gilkeidar/ByteFrost/Programs/README.md

# Programs

Here is a list of included programs.

> Note: ByteFrost assembly programs have the file extension `.asm` and can be compiled to `.mlg` (this rewrites the assembly program into machine language in ASCII, useful for uploading a program to the program EEPROM using Arduino code) and `.bin` (which compiles the assembly directly to binary)

## Assembly Programs

* `BIST` - Built-In Self Test (tests hardware operations such as the ALU, RAM, register file, and display) - written by Ron Keidar
* `Binary Search Tree` - Implementation of a Binary Search Tree with recursive insert and traversal functions to sort a list of 10 numbers - written by Gil Keidar and Ron Keidar
* `Eight Queens` - Solver for the Eight Queens problem. Prints all 92 solutions - written by Gil Keidar and Ron Keidar
* `Fibonacci Recursive (Exponential)` - Recursive calculator for the nth Fibonacci number (exponential time to showcase use of stack) - written by Gil Keidar and Ron Keidar
*  `Stack_Example` - Simple stack example program that showcases use of PUSH and POP commands - written by Gil Keidar and Ron Keidar
* `memdump` - (fill program information here) - written by Ron Keidar
