gilkeidar/ByteFrost/Documentation/README.md

# ByteFrost Documentation

## Hardware Documentation

* ByteFrost PowerPoint (includes hardware schematics)

## Software Documentation

* ByteFrost Powerpoint (includes instruction set list with control signal and micro-code specifications)
