gilkeidar/ByteFrost/Assembler v2/Design/assembler handbook/overview.md

#  Overview

This handbook documents the ByteFrost Assembler software architecture (covered
in the *Developer Documentation* section) and includes a manual for how to use
the ByteFrost Assembler intended for programmers of ByteFrost Assembly (covered
in the *Programmer Manual* section).
