gilkeidar/ByteFrost/Documentation/ByteFrost v3.0.pptx

Byte Frost

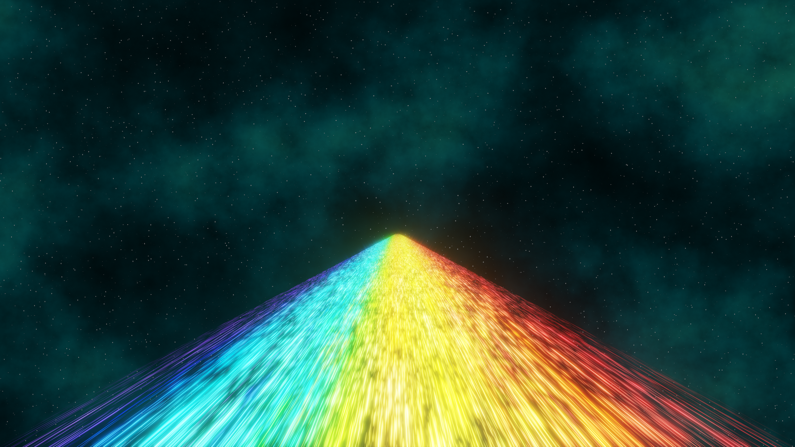
[picture p5: figure]
Bifrost [3840x2160] : r/wallpaper
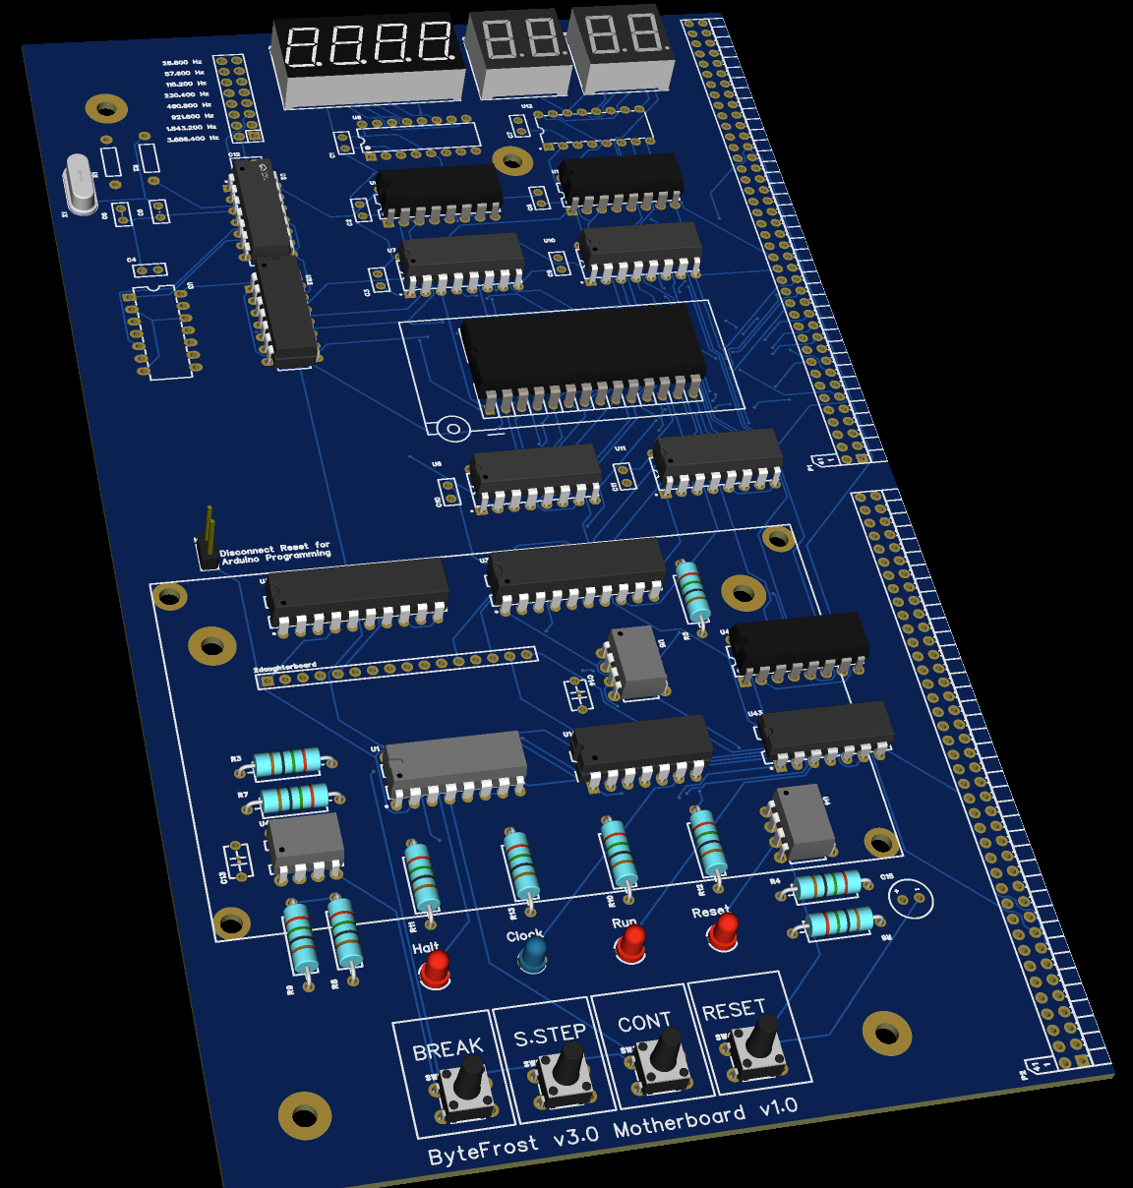
[picture p6: figure]

V3.0 PCB

## ByteFrost V3.0 – Migration to PCB

While most of the design is kept from v2.0, the migration to
Backplane and distributed PCB boards impact every circuit.
In addition, all the schematics are real, and not hand made impressions.

## Unified Bus Operation (v2.0)

8b→16b

16bitAdder

TmpAR

8 msb

Address Bus + Read/Write

8 lsb

Addr H

Addr L

Data Bus

Data Bus

TmpAR

PC

3msb

Data Bus

AMAP
Decoder

CE

Program Counter

Stack Pointer

SP

EEPROM

Data Pointer

DP

CE

SRAM

Base Pointer

AR Select

BP

CE

Read /Write

MMIO

Instruction Registers

Micro
Instructions

Register
File

## ByteFrost Addressing Modes

There are five forms of memory in the ByteFrost – Immediates (read-only), General-Purpose Registers (R0 – R3), Address Registers (DP, SP, PC, BP), Memory (64KB divided into ROM, RAM, and MMIO regions), and Stack
Every solid directed edge (u, v) in the following graph means that memory u can write to memory v with a dedicated instruction.
Every dotted directed edge (u, v) means that the memory u can write to memory v indirectly (i.e., a path exists from u to v but requires multiple instructions to implement).
There are technically 5 x 5 = 25 possible permutations here, but as immediates are read-only, there are in effect only 5 x 4 = 20 possible permutations.
Instructions with an asterisk (*) are currently not implemented.

Immediate

Memory

LDR

MOV

General Register

Address Register

Stack

Src | Dest | Semantics | Dedicated Instruction?
Imm | GR | Rd = Imm_8 (LDR Rd, Imm) | Yes (LDR)
GR | GR | Rd = Rs (MOV Rd, Rs) | Yes (MOV)
AR | GR | Rd = ARSrc[L/H] | Yes (*)
Memory | GR | (LMA) Rd = *{%DP[H], Imm}, DP[L] = Imm (LMR) Rd = *{%DP[H], Rs}, DP[L] = Rs (LMO*) Rd = *(ARSrc + Imm) | Yes (LMA, LMR, *
Stack | GR | Rd = *(SP), SP++ | Yes (POP)

Src | Dest | Semantics | Dedicated Instruction?
Imm | AR | ARDest[L/H] = Imm | Yes (*)
GR | AR | ARDest[L/H] = Rs | Yes (*)
AR | AR | ARDest = ARSrc + Imm | Yes (*)
Memory | AR | ARDest[L/H] = *(ARSrc + Imm) (?) ARDest = *{ARSrc + Imm + 1, ARSrc + Imm} (?) | No
Stack | AR | ARDest = *{SP + 1, SP}, SP += 2 (?) (e.g. POP ARDest) | No

Src | Dest | Semantics | Dedicated Instruction?
Imm | Memory | *(ARSrc) = Imm (?) | No
GR | Memory | *(ARSrc + Imm) = Rs | Yes (*)
AR | Memory | *(ARDest + Imm + 1, ARDest + Imm) = ARSrc(?) | No
Memory | Memory | *(ARDest + Imm) = *(ARSrc) | No (load-store architecture)
Stack | Memory | *(ARSrc + Imm) = *SP, SP++ (?) | No

Src | Dest | Semantics | Dedicated Instruction?
Imm | Stack | *(SP) = Imm, SP– (Push Imm) | No?
GR | Stack | *(SP) = Rs, SP-- | Yes (PUSH *) (change to full-descending)
AR | Stack | *(SP, SP – 1) = ARSrc, SP -= 2 | No? (Push ARSrc)
Memory | Stack | ? | ?
Stack | Stack | ? | ?

## Backplane

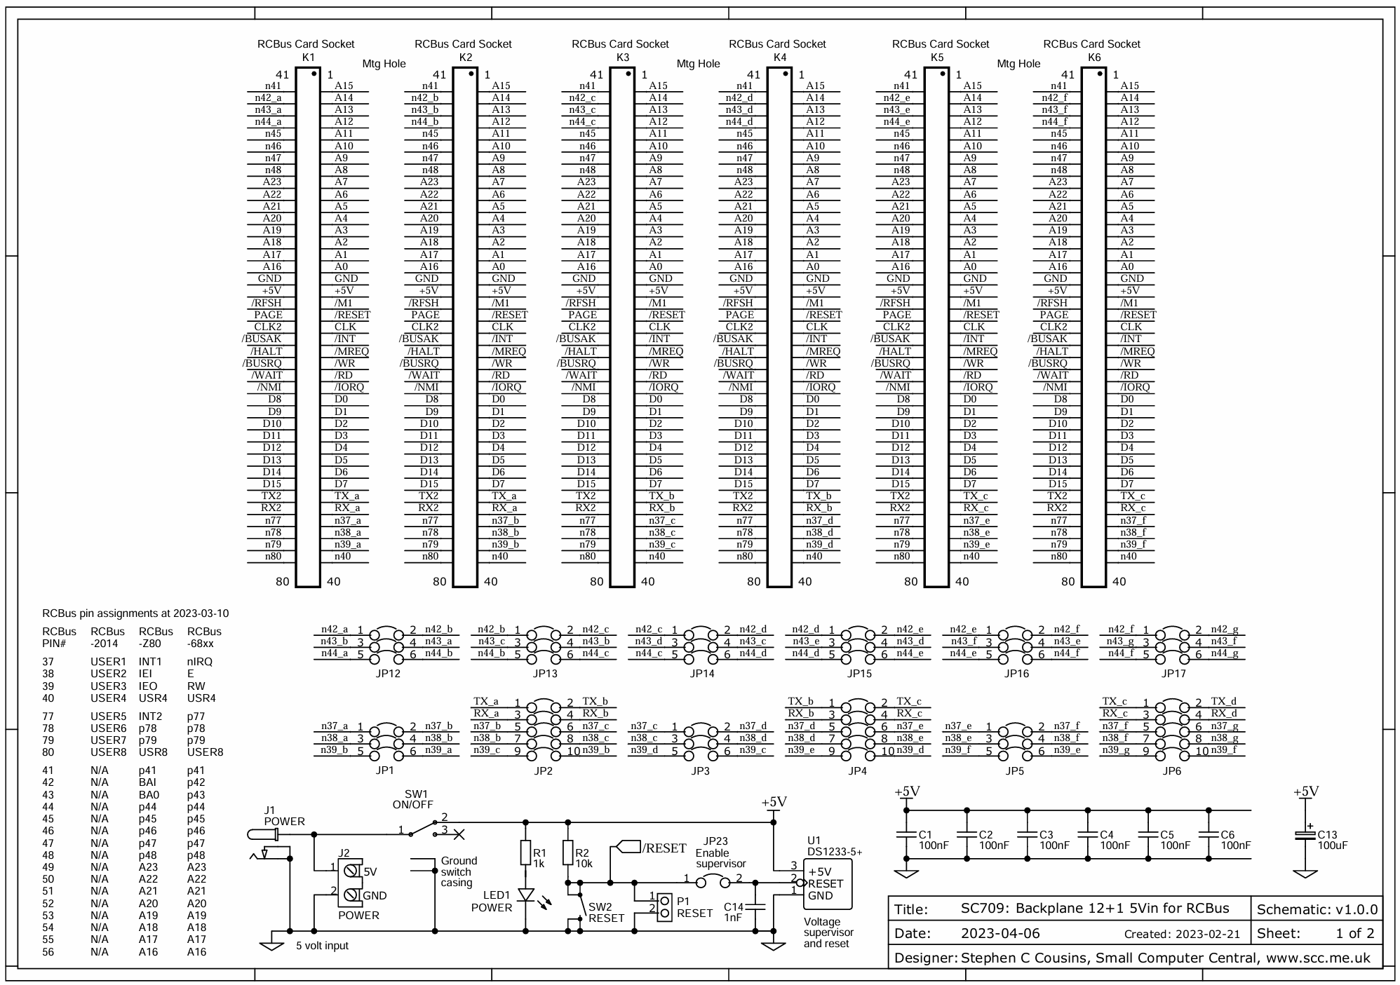
[picture p7: figure]

sc709_v1.0.0_2023-04-17_22-11_schematic.pdf (https://smallcomputercentral.com/wp-content/uploads/2023/04/sc709_v1.0.0_2023-04-17_22-11_schematic.pdf)
EasyEDA (https://easyeda.com/editor#id=67eacdcff3ef4f0daaa2c420b6aae15d)(Standard) - A Simple and Powerful Electronic Circuit Design Tool (https://easyeda.com/editor#id=67eacdcff3ef4f0daaa2c420b6aae15d)

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
## Main Backplane

__41 | 41 | 1 | A15
__42 | 42 | 2 | A14
__43 | 43 | 3 | A13
__44 | 44 | 4 | A12
__45 | 45 | 5 | A11
__46 | 46 | 6 | A10
D0 | 47 | 7 | A9
D1 | 48 | 8 | A8
D2 | 49 | 9 | A7
D3 | 50 | 10 | A6
D4 | 51 | 11 | A5
D5 | 52 | 12 | A4
D6 | 53 | 13 | A3
D7 | 54 | 14 | A2
CTRL23 | 55 | 15 | A1
CTRL22 | 56 | 16 | A0
GND | 57 | 17 | GND
+5V | 58 | 18 | +5V
CTRL21 | 59 | 19 | __19
CTRL20 | 60 | 20 | Reset#
CTRL19 | 61 | 21 | CLK
CTRL18 | 62 | 22 | WR#
CTRL17 | 63 | 23 | RD# (OE#)
CTRL16 | 64 | 24 | INSTR0
CTRL15 | 65 | 25 | INSTR1
CTRL14 | 66 | 26 | INSTR2
CTRL13 | 67 | 27 | INSTR3
CTRL12 | 68 | 28 | INSTR4
CTRL11 | 69 | 29 | INSTR5
CTRL10 | 70 | 30 | INSTR6
CTRL9 | 71 | 31 | INSTR7
CTRL8 | 72 | 32 | INSTR8
CTRL7 | 73 | 33 | INSTR9
CTRL6 | 74 | 34 | INSTR10
CTRL5 | 75 | 35 | INSTR11
CTRL4 | 76 | 36 | INSTR12
CTRL3 | 77 | 37 | INSTR13
CTRL2 | 78 | 38 | INSTR14
CTRL1 | 79 | 39 | INSTR15
CTRL0 | 80 | 40 | __40

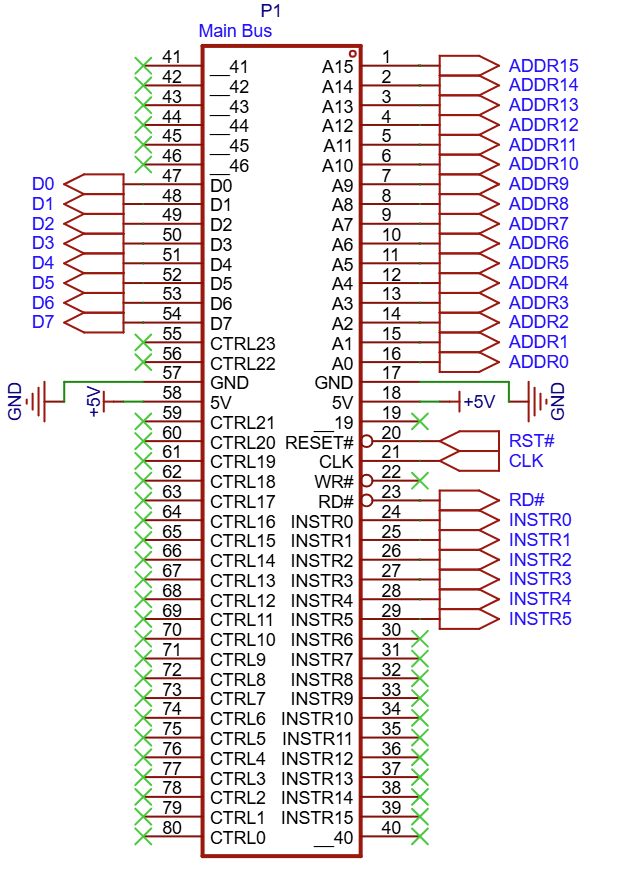
[picture p8: figure]

- Orange pins have jumpers that can make them local
- Pin with prefix __ are not assigned

## Secondary Backplane

__41 | 41 | 1 | Bus_Request
__42 | 42 | 2 | Bus_Grant
__43 | 43 | 3 | Bus_Release
__44 | 44 | 4 | Quiesce
__45 | 45 | 5
__46 | 46 | 6 | Fetch_Cycle
| 47 | 7
| 48 | 8 | Display_Load
| 49 | 9 | KBD_CLK
| 50 | 10 | KBD_Data
| 51 | 11
| 52 | 12
| 53 | 13
| 54 | 14
| 55 | 15
| 56 | 16
GND | 57 | 17 | GND
+5V | 58 | 18 | +5V
| 59 | 19 | BPL_LD
| 60 | 20 | BPH_LD
| 61 | 21 | SPL_LD
| 62 | 22 | SPH_LD
| 63 | 23 | DPL_LD
| 64 | 24 | DPH_LD
| 65 | 25 | PC_LD#
| 66 | 26 | DHPC_LD
| 67 | 27 | TmpAR_OE#
| 68 | 28 | BP_OE#
| 69 | 29 | SP_OE#
| 70 | 30 | DP_OE#
| 71 | 31 | PC_OE#
| 72 | 32 | __32
LD_BRNCH | 73 | 33 | __33
FLAG_N | 74 | 34 | __34
FLAG_C | 75 | 35 | __35
FLAG_Z | 76 | 36 | __36
RST_MicroPC | 77 | 37 | __37
MSB_Quiesce | 78 | 38 | __38
ARSrc_0 | 79 | 39 | __39
ARSrc_1 | 80 | 40 | __40

- Orange pins have jumpers that can make them local
- Pin with prefix __ are not assigned

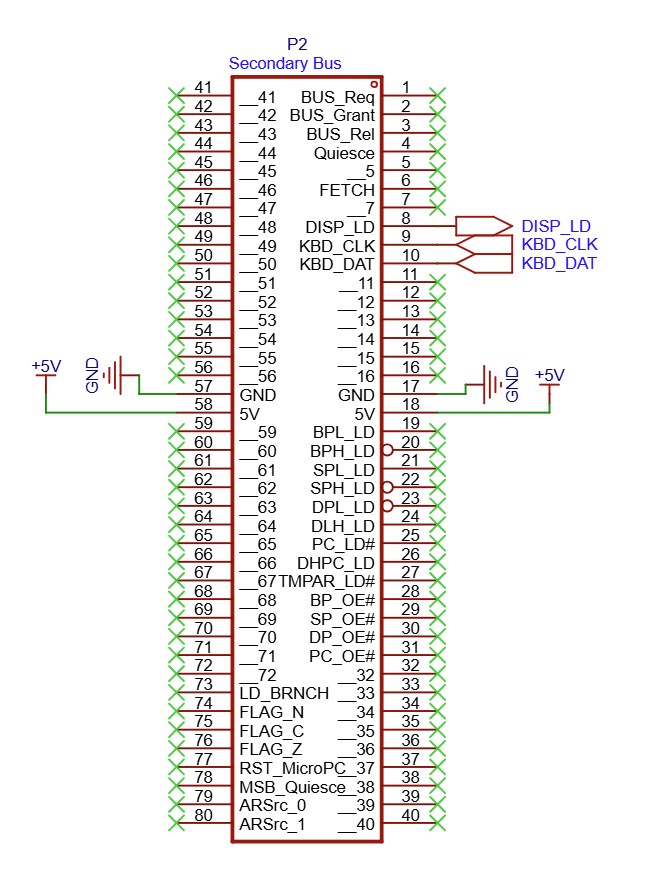
[picture p9: figure]

## Area Estimation – Chips * Length

23. Arduino+ Display
24. ALU

12. OpCode
13. Regs

15. Branch | 14. Display

16. SD MKR
17. SD I/F
18. BP
19. AddrDisp
20. TmpAR

1. clock
2. CTRL LEDs
3. MicroInst
4. OE/WE
5. ROM
6. DP
7. SRAM
8. PC
9 Addr
10. Counter
11. RNG

21. KBD
22. SP

## Motherboard (v3.0)

- The 4 buttons and LEDs at the bottom preserve the original ByteFrost design
- The clock is replaced with a crystal.
- The clock control is through the jumpers next to the crystal
- The 7SEG displays are scanned, such that one decoder serves 4 digits.
- The Display is planned to stand on 45mm columns
- 16b rainbow need to connect the display to the motherboard
- The empty space is to allow easy access to the EEPROM release bar
- The Primary and Secondary busses provides 160 lines to the rest of the system

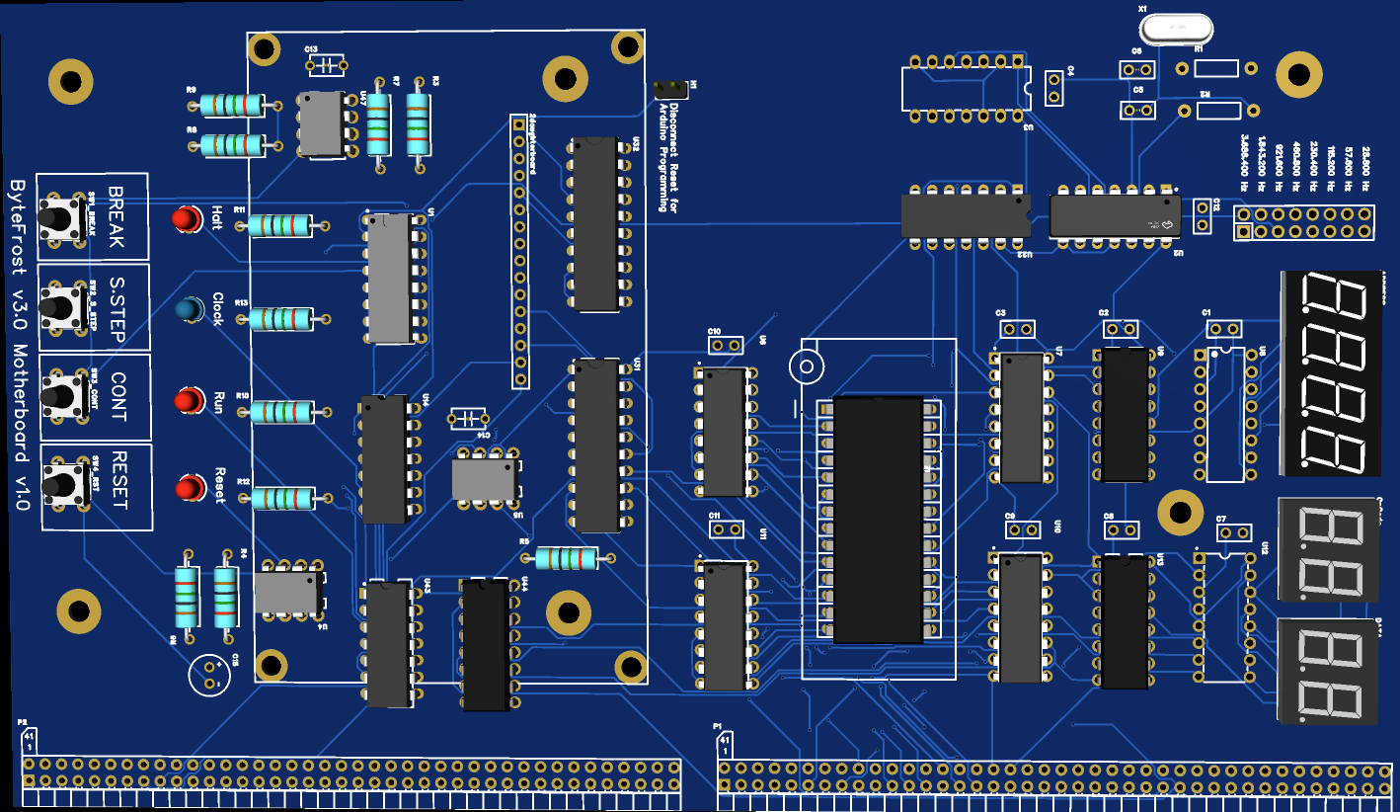
[picture p10: figure]

## Motherboard Clock (v3.0)

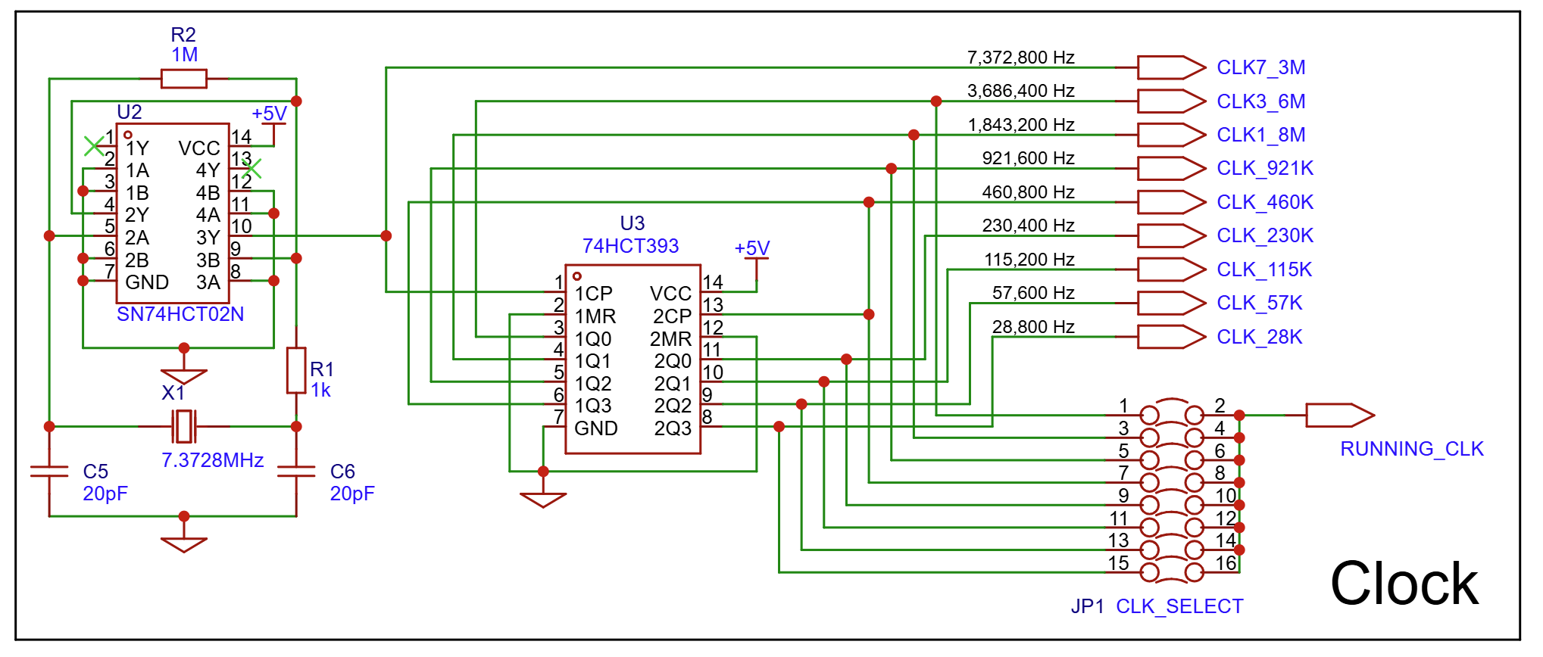
[picture p11: figure]

## Motherboard Address Display (v3.0)

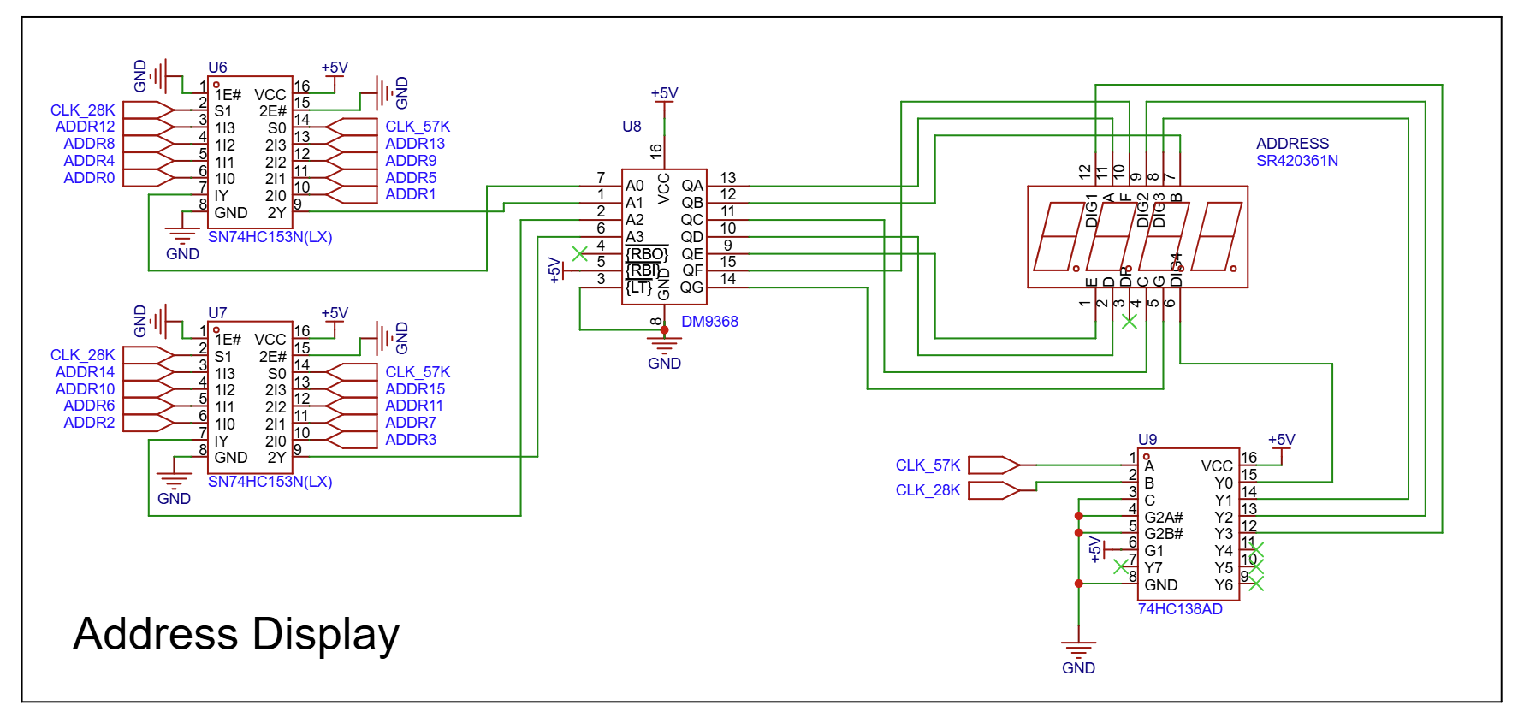
[picture p12: figure]

## Motherboard Data and Opcode Display (v3.0)

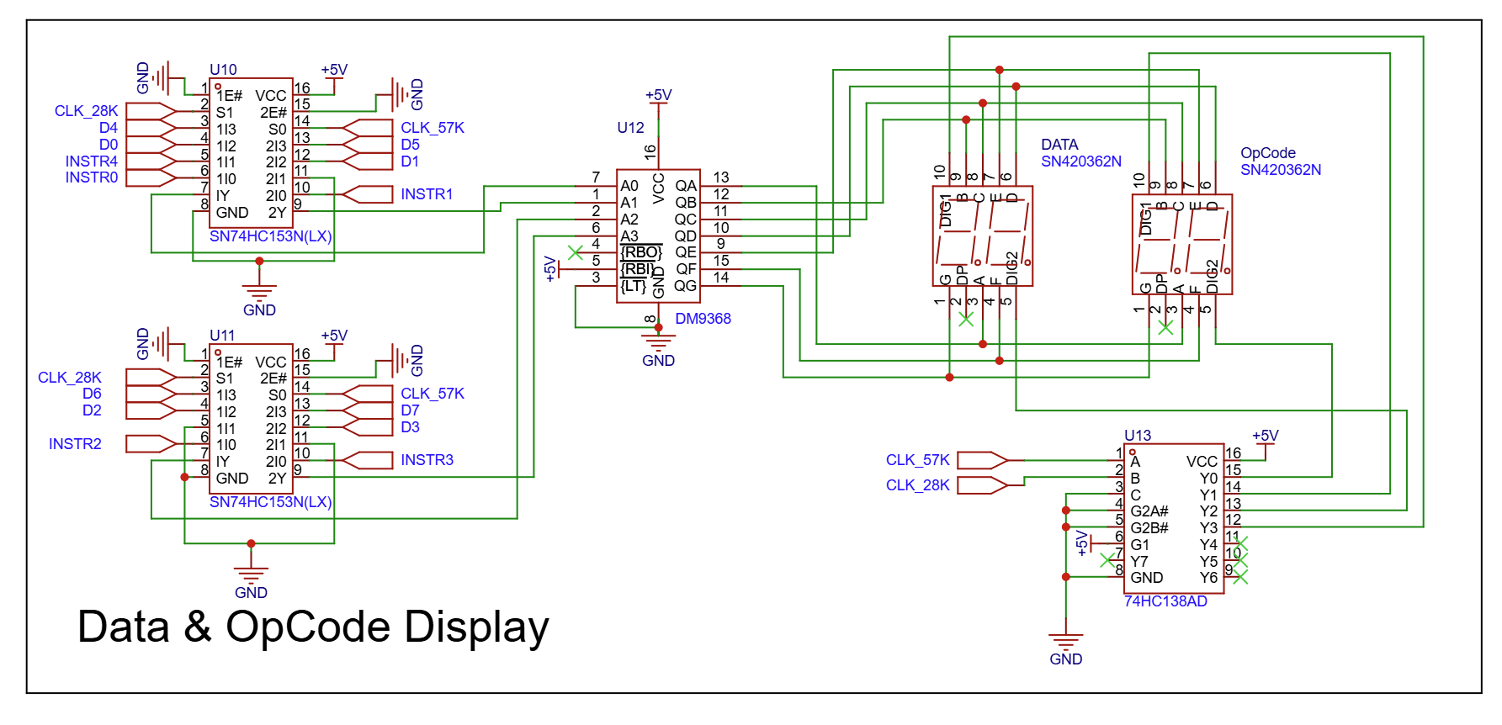
[picture p13: figure]

## Motherboard EEPROM (v3.0)

- In v3.0, the Chip_Enable signals are distributed, i.e, each storage need to generate its own CE based on the address bus.
- In this case the three MSBs are OR-ed to generate CE# for the lower 8KB

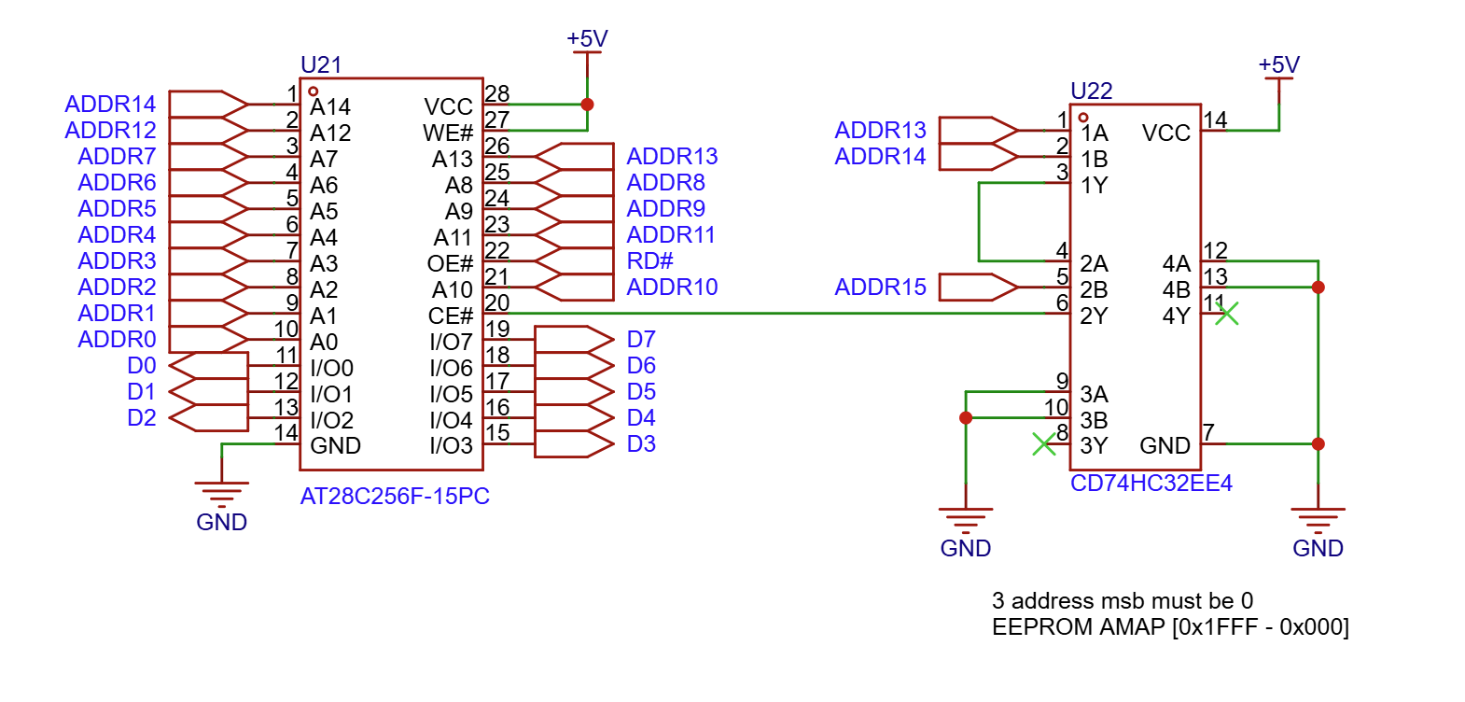
[picture p14: figure]

## Motherboard Arduino Interface (v3.0)

- DISP_LD – trigger printing a CHAR on the display
- First 273 capture the CHAR and second captures the A/I
- LDISP_LD also goes to the Arduino to trigger interrupt
- The Keyboard CHAR is serialized from Arduino and processed elsewhere through the secondary backplane.
- The reset line to Arduino need to be disconnected to enable programming through the USB

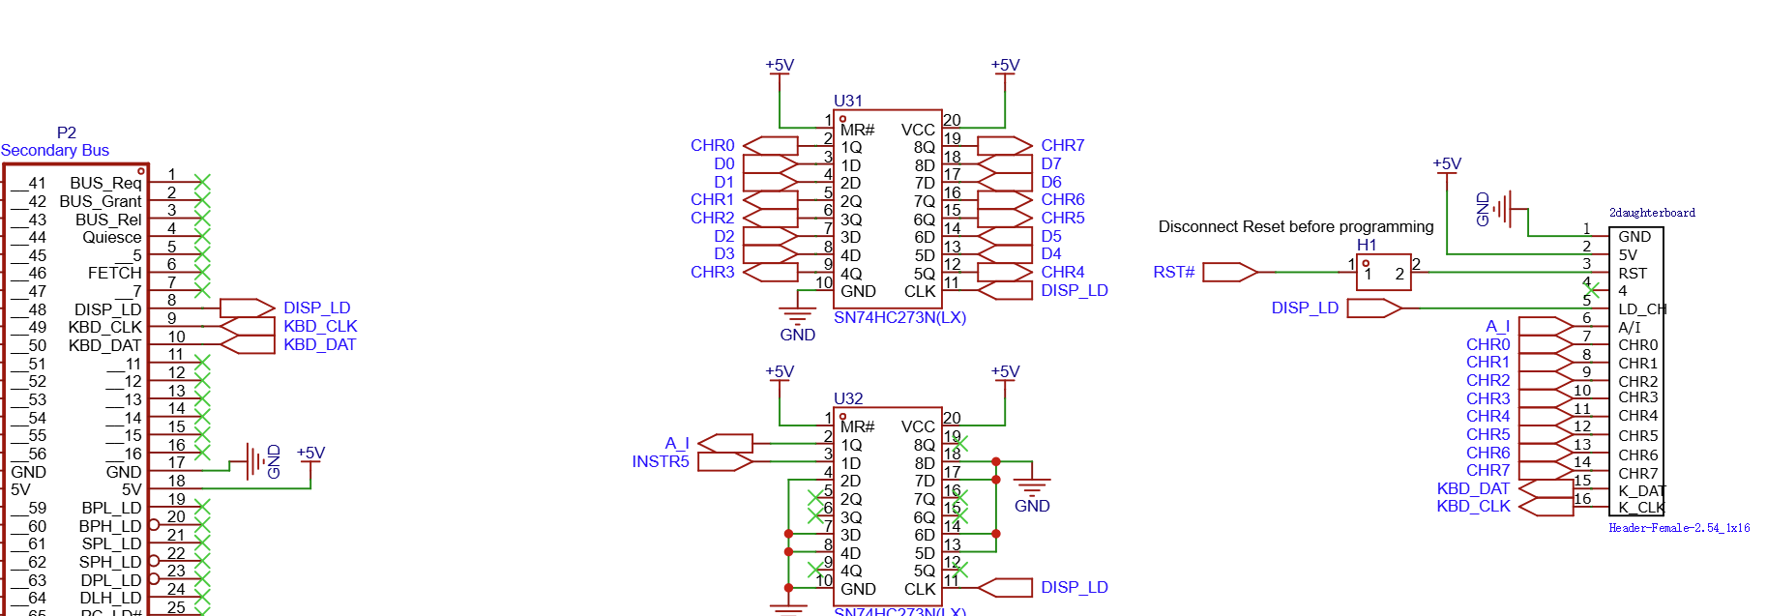
[picture p15: figure]

## Display Load (V2.0)

Data Bus

273 Char

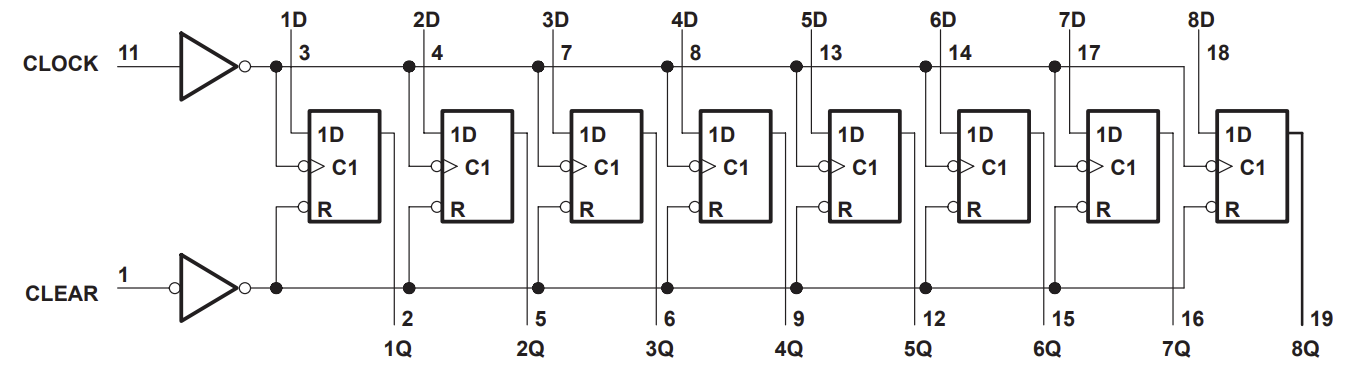
[picture p16: figure]

Disp Char

µC 6: Out Reg H

µC 3: Reg Out Select

OpCode [5] A/I

OpCode_08

Main CLK

Display Load

273 A/I

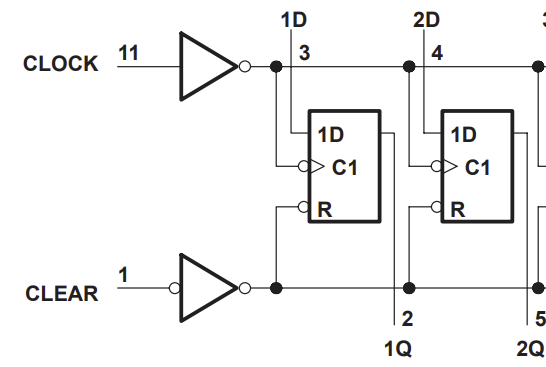
[picture p17: figure]

A/I

OpCode_0D

15

## Debug & Reset (v3.0)

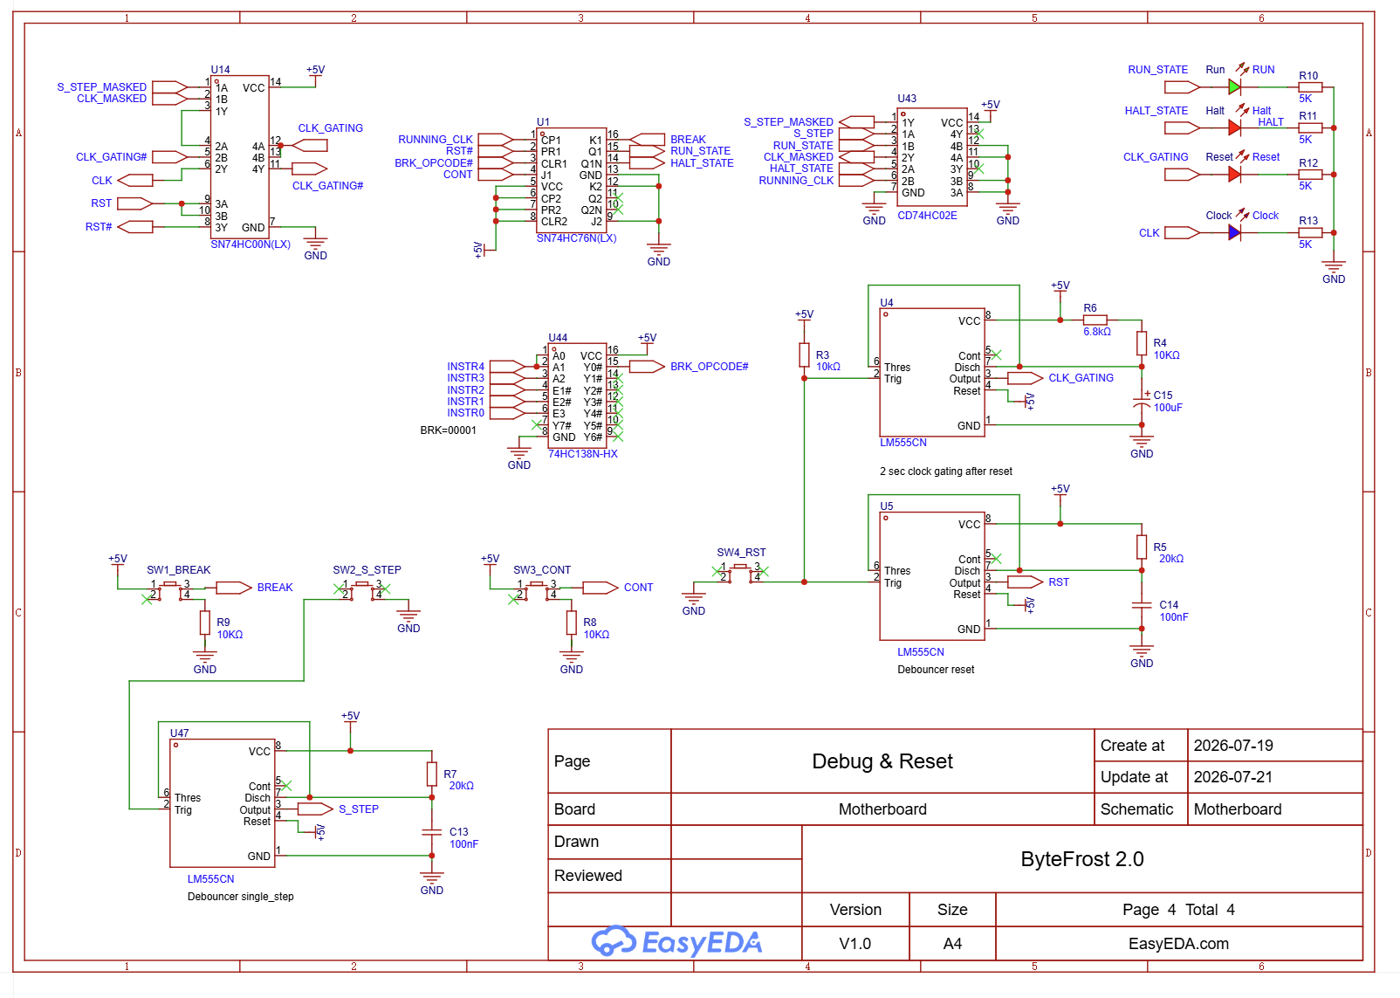
[picture p18: figure]

- The LM555 one-shots are used as debouncers, i.e. unify the many fast transitions a button may create.
- E.g. a “Single Step” button may advance multiple addresses unless a debouncer will unify the transitions into a single press.
- The CLK_GATING is a special timer that extend RST to almost 2sec. This allows the Arduino handling the display sufficient time. Otherwise, the first characters that printed in that time will be lost.
- 74HC76 is the running-state FF which determines if the system is:
  - RUN_STATE: RUNNING_CLK becomes CLK
  - HALT_STATE: No clock, or S_STEP is the CLK
- The BREAK and CONT do not need debouncers as they reset or set running-state
- 74HC02 is an OR
- The State wires are ORed with the clock they mask. (The output of the OR is ‘1’ instead of clock)
- 74HC00 is a NAND
- The two masked clocks are combined with a NAND (the masked clock is 1, enabling the other to go through the NAND)
- Another NAND is gated to allow the 2sec for the Display
- Next slide from v2.0 might help to visualize this

## Clock Gating (v2.0)

Reset#

BRK Button
(Purple)

Running CLK

Cont. Button
(Gray)

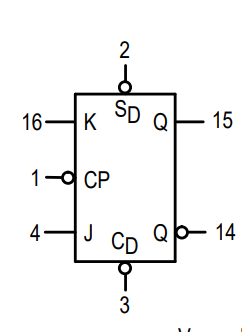
[picture p19: figure]

74LS76

S.S. CLK

RUN LED
(Brown wire)

Halt LED
(Blue wire)

Clock LED
(Green wire)

Main CLK

Clock gating 2sec for
Arduino (display) to boot

Op Code 1: BRK

Running CLK

Reset Button
(Red wire)

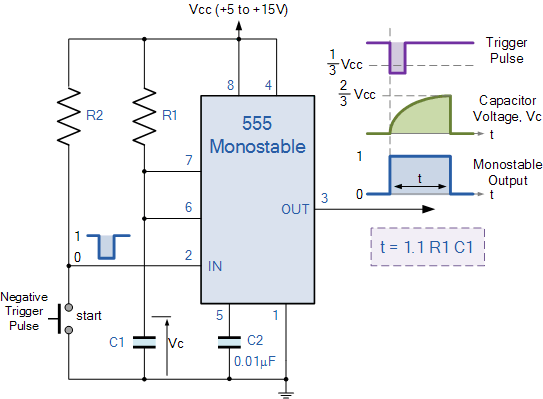
[picture p20: figure]
555 Timer Tutorial - The Monostable Multivibrator

Reset LED
(Orange wire)

Reset

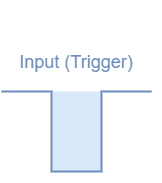
[picture p21: figure]
OPAMP Monostable - Electronics-Lab.com
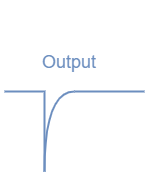
[picture p22: figure]

4ms

Main Reset

2s

17

## Display Daughterboard (v3.0)

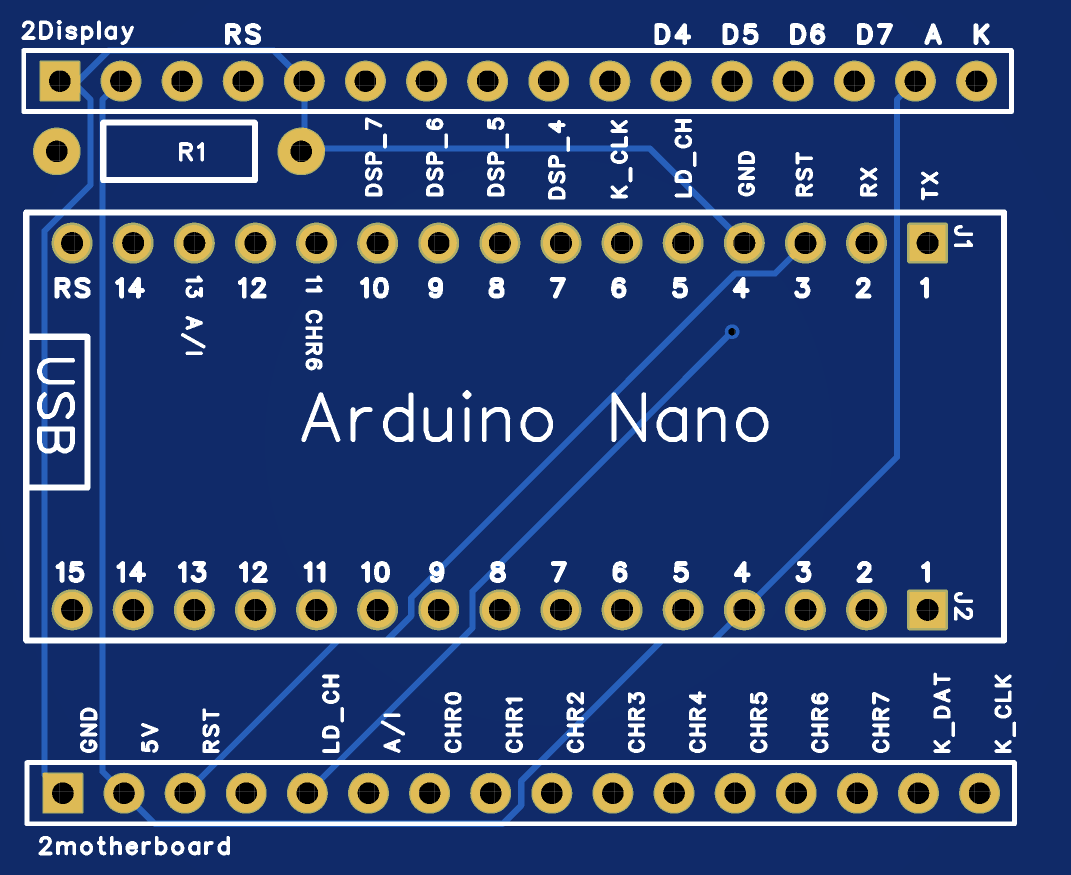
[picture p23: figure]

- The Display daughterboard is a mapper between the ByteFrost, the Arduino and the Display
- The wire to the motherboard is a 16-wire rainbow to the Motherboard
- J1/J2 are the socket for the Arduino
- The socket to the display is directly mapped to the display and physically holds the daughterboard in the air underneath the display.
- The Arduino is positioned such that the USB socket is as close as possible to the left edge of the Display, on the far end from the backplane of the Motherboard

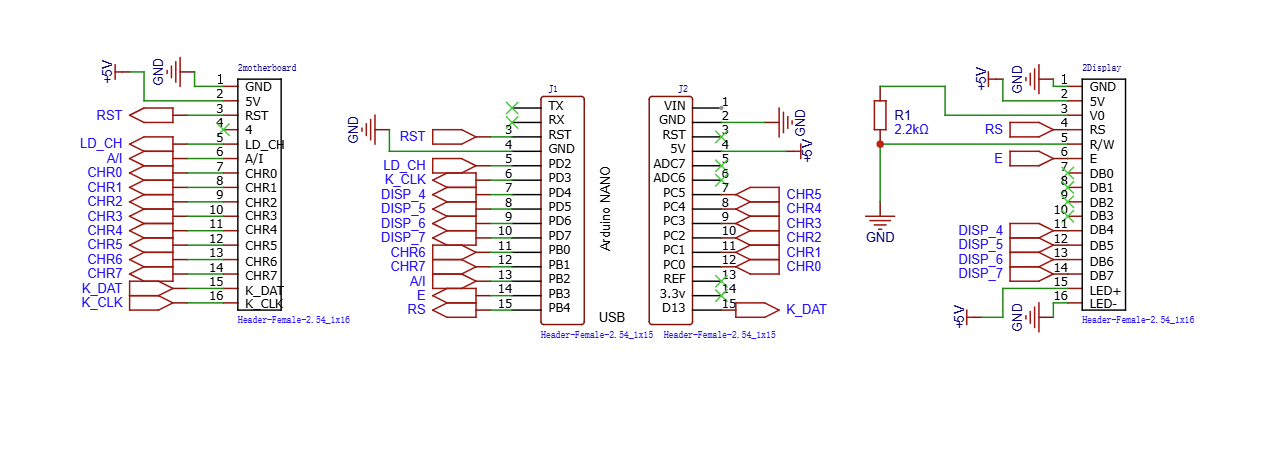
[picture p24: figure]

## Display (V2.0)

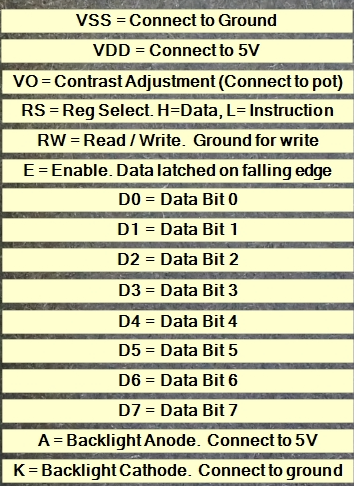
[picture p25: figure]

USB Serial.Print

Disp Char

5 4 3 2 1 0

6 7

# Main Reset

Gray

White

5V

KBD

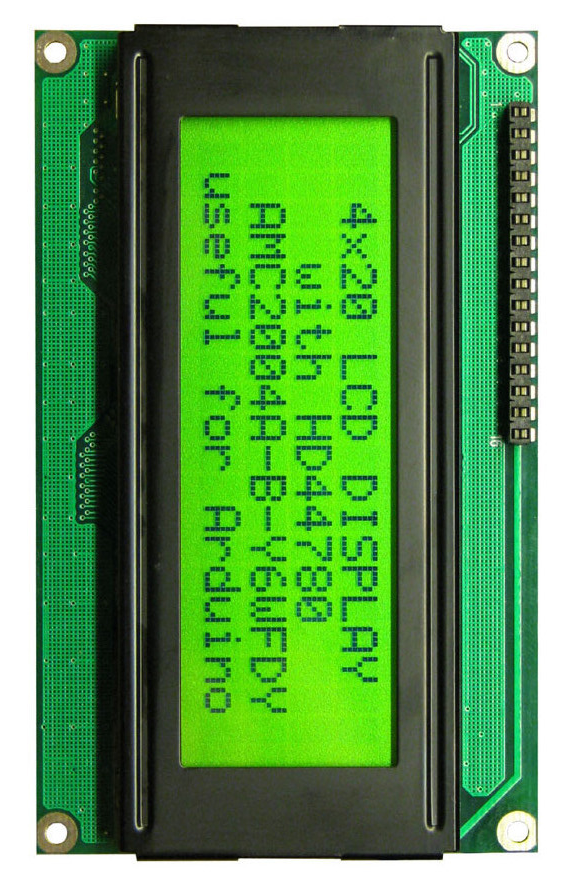
[picture p26: figure]

KBD data

KBD clock

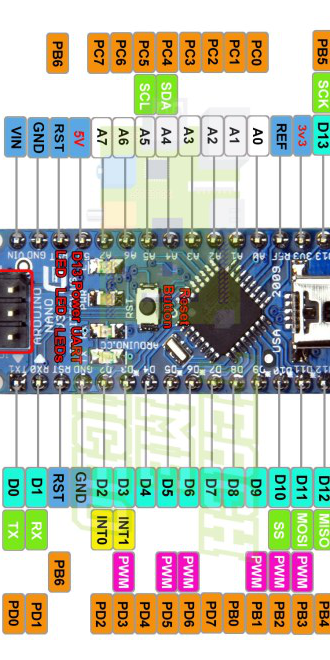
[picture p27: figure]
Arduino NANO Pinout

INT0

A/I

Notes:
1. To free up 4 GPIOs, Display is configured to use 4b which requires two writes
2. 5v was added to allow independence of USB connection. When USB is connected, it helps the main supply
3. To enable programing, the reset line need to be disconnected – proposed to add a 3state on its path
4. “A/I” is now latched and stay valid for multiple clocks and does not fail at MAX clock
5. IDE Setup: Board "Arduino NANO“; CPU "ATmega328p (old bootloader)"

Display Load

19

Notes: 1. IDE Setup
a. Board "Arduino NANO"
b. CPU "ATmega328p (old bootloader)"
2. To program the Arduino - the RESET control signal (black) need to be disconnected!!.

## Keyboard

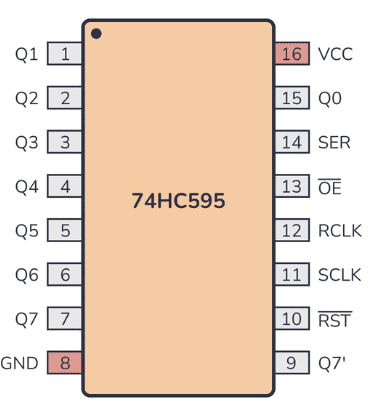
[picture p28: figure]

KBD #OE

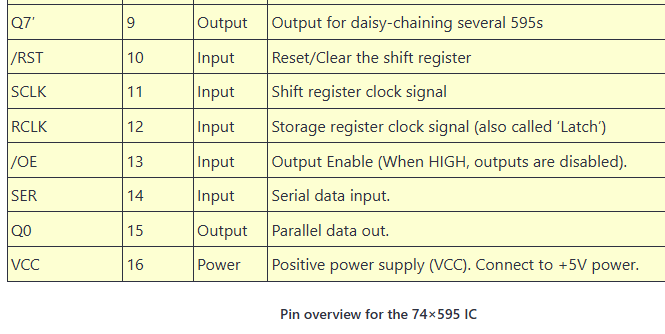
[picture p29: figure]

12

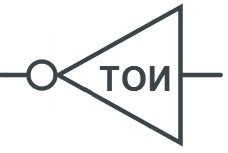
[picture p30: figure]

13

11

12

13

#Ready

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
Notes:
1. The format of the character is 1 READY bit followed by 8b char
2. Once the READY bit reaches the 9th spot (RDY Q0) the Char is ready
3. Once Ready, the Read to KBD generate #OE and the Char is out
4. If there is no Char, the #OE does not happen, and the CPU read 0
5. CPU ignores 0 as it is not an ASCII
6. The #OE also generates a reset that empty the SR but not the register
7. The end of the #OE generates a Reg clk (RCL), to load 0 to the register
8. The clock of the SR is inversed as clock to the Register (RCL) (if not inverted, the register get the previous SR)
9. The RCL combines both clock and #OE through OR 123
10. It is important that the clock from the display is 0 when not active so it wont block the OR.

Data Bus

Data - Gray

Clock - White

KBD

KBD

## Registers File

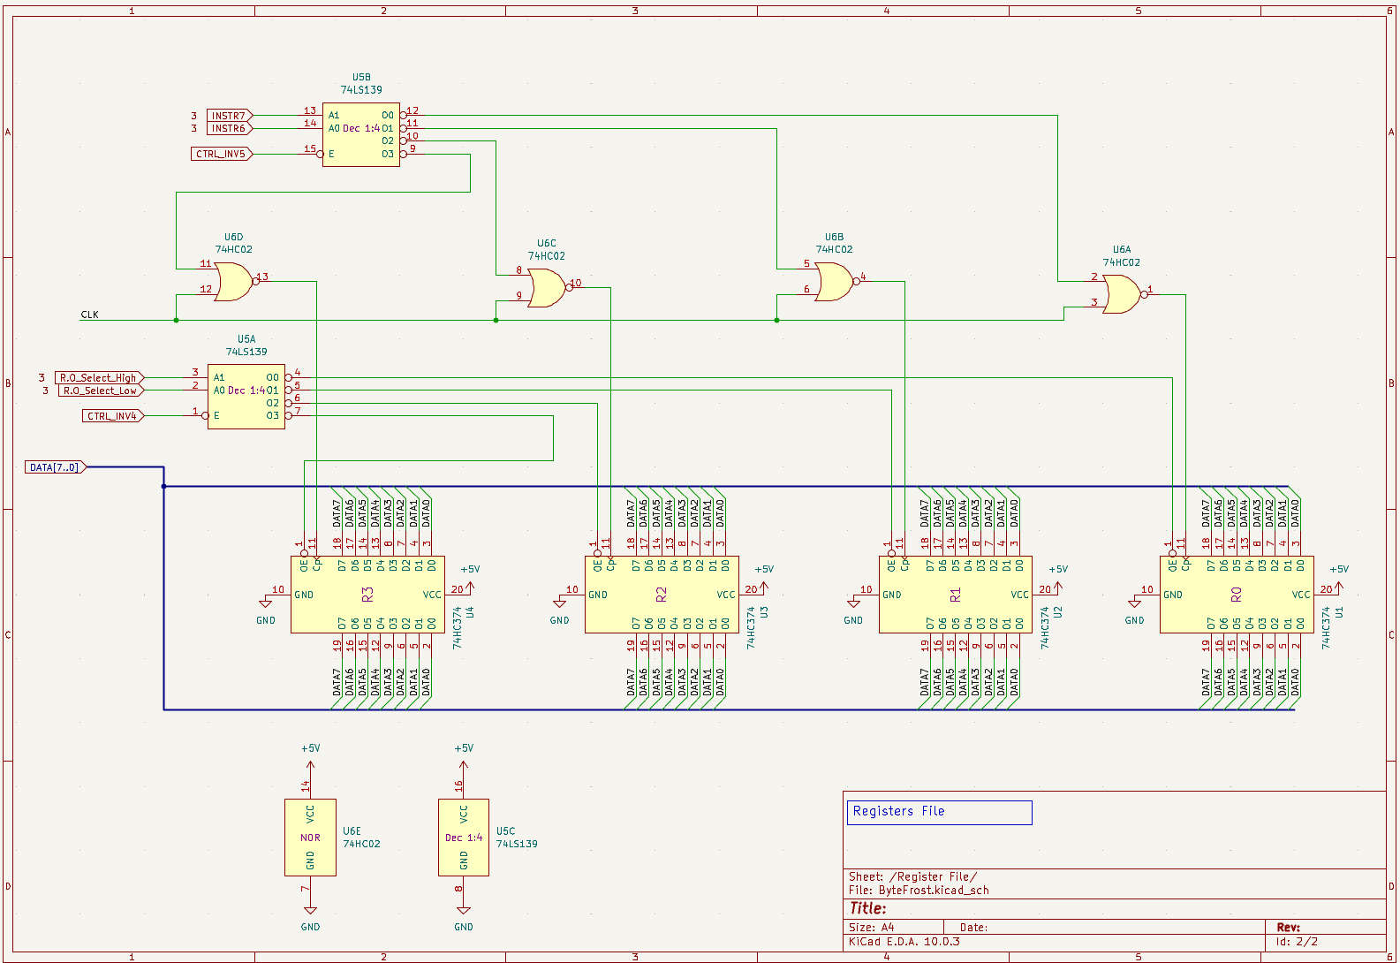
[picture p31: figure]

## Register Out Select

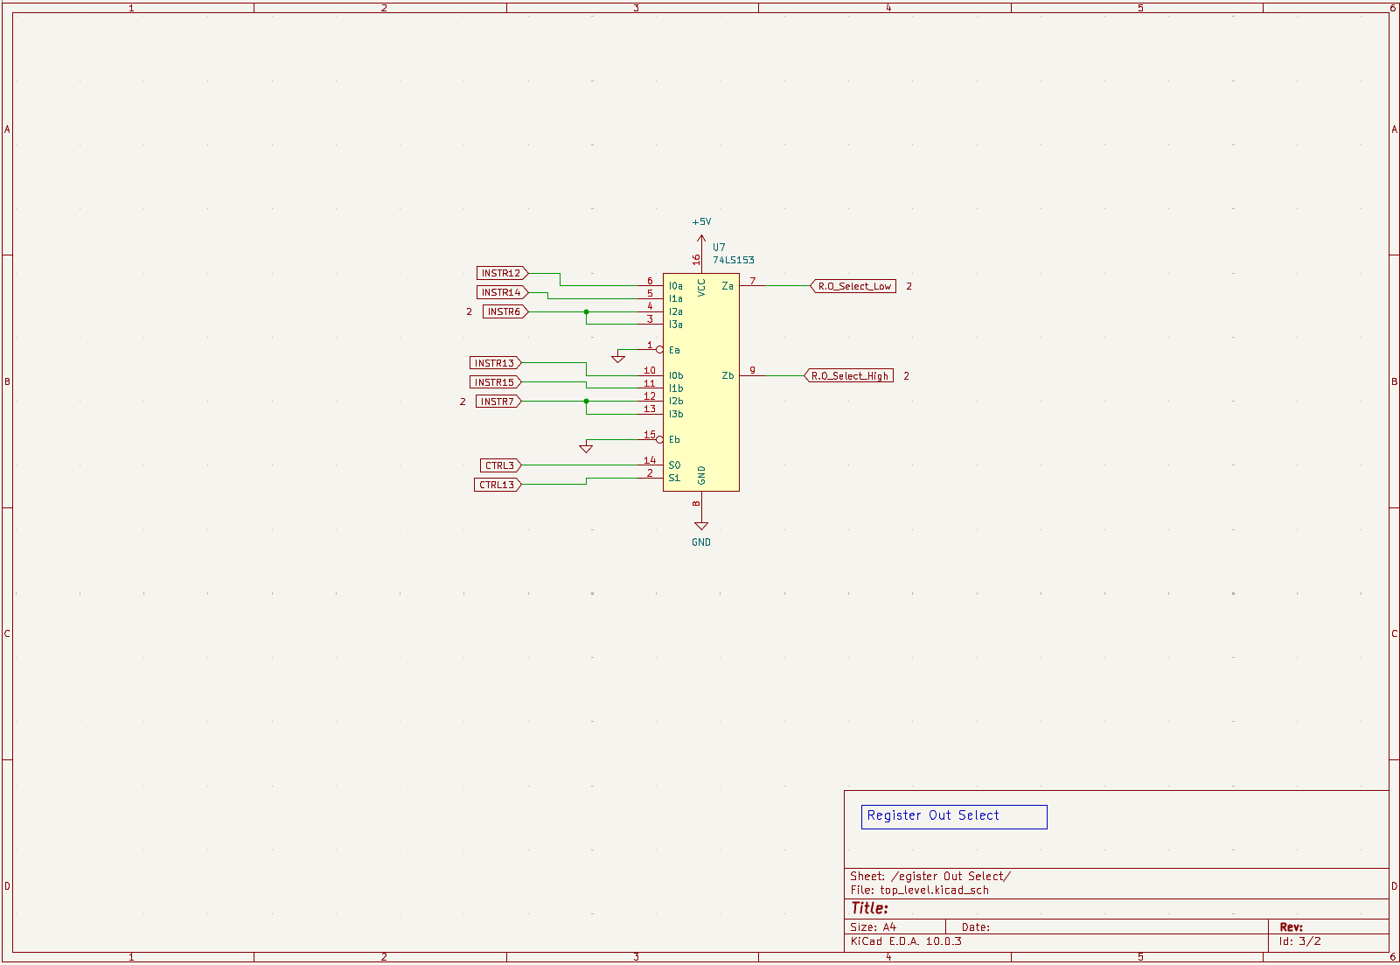
[picture p32: figure]

## Address Bus Select (ARSelect) v2.0

ARSelect specifies which AR gets to write to the Address Bus and whether any of them do (it can do this since it only sends output enables; if it doesn’t send an output enable to any hardware entity, then no entity writes to the address bus).

Bus Grant

µC 9: PC Out

FetchCycle

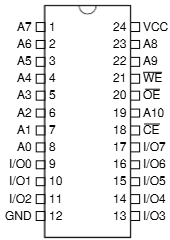
[picture p33: figure]

ARSelect 8x8 LUT

TmpAR OE

Opcode_MAG_LDW_SDW_MAA

µC 20: TmpARWrite

µC 14: SP Out

Program Counter OE

ARSrc [1:0]

Base Pointer OE

Inputs | | | | | | | Outputs (Active Low)
Bus Grant (A7) | Fetch Cycle (A6) | PC Out control signal (A5) | SP Out control signal (A4) | TmpAR Write control signal (A3) | Opcode_MAG_LDW_SDW_MAA (Active Low) (A2) | AR Src operand (A1, A0)
1 | X | X | X | X | X | X | None (Bus floats)
0 | 1 | X | X | X | X | X | PC (I/O 0)
0 | 0 | 1 | X | X | X | X | PC (I/O 0)
0 | 0 | 0 | 1 | X | X | X | SP (I/O 2)
0 | 0 | 0 | 0 | 1 | X | X | TmpAR (I/O 4)
0 | 0 | 0 | 0 | 0 | MAG, LDW, SDW, MAA | AR Src[1:0] | = AR Src[1:0] 0-PC, 1-DP, 2-SP, 3-BP
0 | 0 | 0 | 0 | 0 | Other Opcodes | X | DP (I/O 0)

Stack Pointer OE

Data Pointer OE

EEPROM Data Output Bit | Output
7 | 1 (unused)
6 | 1 (unused)
5 | 1 (unused)
4 | TmpAR Output Enable (ACTIVE LOW)
3 | BP Output Enable (ACTIVE LOW)
2 | SP Output Enable (ACTIVE LOW)
1 | DP Output Enable (ACTIVE LOW)
0 | PC Output Enable (ACTIVE LOW)

## Opcode_MAG_LDW_SDW_MAA (v2.0)

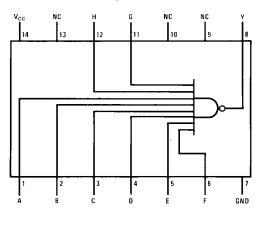
[picture p34: figure]

74LS30

LDWL

OpCode_14

LDWH

SDWL

OpCode_15

OpCode_16

SDWH

OpCode_17

MAAL

MAAH

OpCode_18

OpCode_19

Opcode_MAG_LDW_SDW_MAA

MAG

OpCode_1A

JSR

OpCode_10

Opcode_MAA

Opcode_MAA_JSR

## ARSrc Operand Decode v2.0

Instr[5],Instr[1]

Instr[9],Instr[8]

ARSrc Decode:
1. If opcode is of (AR → GR) (Rd = ARSrc[L/H]) instruction, then ARSrc is in bits 9:8.
2. Otherwise, ARSrc is a function of bits 5 and the opcode (maybe the opcode’ least significant bit?)
Instructions that specify ARSrc with 1 bit in bit 5 need to get the other bit from the opcode; if we always assign these two-opcode instructions opcodes as [4-bit opcode x][0/1], then we can get the other ARSrc bit from the least significant bit of the opcode, i.e., in these instructions ARSrc is {Instr[5], Instr[0]} (in bits 5 and 0)

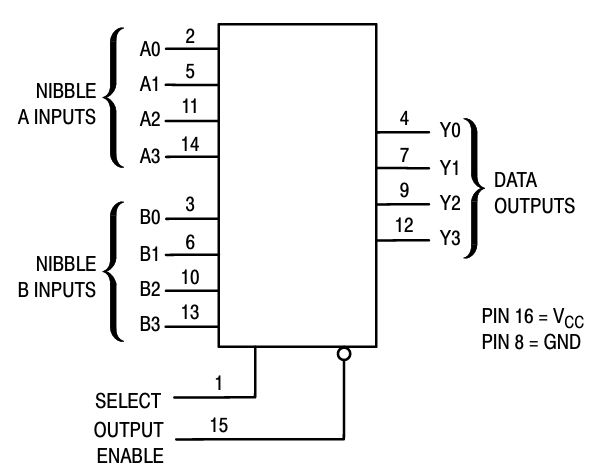
[picture p35: figure]

157: ARSrc

Instr[9],Instr[8]

ARSrc [1:0]

Instr[5],Instr[1]

OpCode_MAG

0v

## Address Map Decoder (v2.0)

Address Bus + Read/Write

A15..A13

138 AMAP

138 AMAP

~EEPROM Chip En

74HC21

Address Map

0000 – 1FFF | ROM
2000 – 3FFF | RAM
4000 – 5FFF
6000 – 7FFF
8000 – 9FFF
A000 – BFFF
C000 – DFFF
E000 – FFFF | MMIO

~SRAM Chip En

MMIO

E000 – E1FF | SD Card
E200 – E3FF | Counter
E400 – E5FF
E600 – E7FF
E800 – E9FF
EA00 – EBFF
EC00 – EDFF
EE00 – EFFF
F000 – FFFF | No HW

A9

A10

A11

138 MMIO Device Enable

~SD Card Device En

A12

~Counter Device En

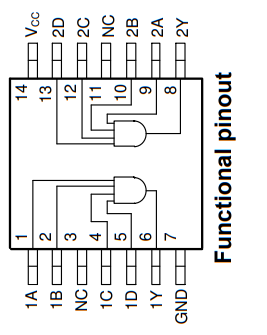
[picture p36: figure]

74HC21

## Memory Access (v2.0)

Cycle | Signal | SRAM | EEPROM | MMIO
Memory Write | #WE | #WE | ‘1’ (no writes) | #WE
Memory Read | #OE | #OE
Memory Write, or Memory Read | #CE | (~SRAM Chip En) | (~EEPROM Chip En) | MMIO

148ns delay

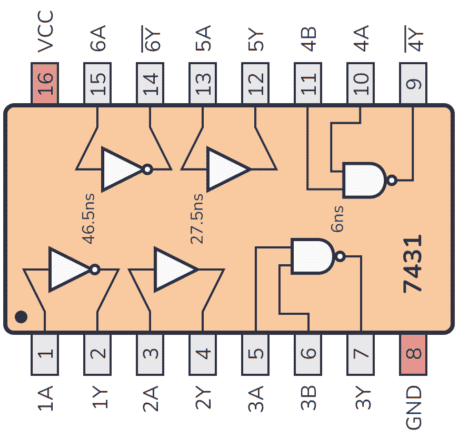
[picture p37: figure]
7400 Series Guide: 74LS31 Delay Elements

OR+Delay postpones the start of #OE,
but doesn’t impact its end

µC 10: MEM Read

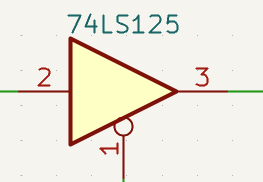
[picture p38: figure]

FetchCycle

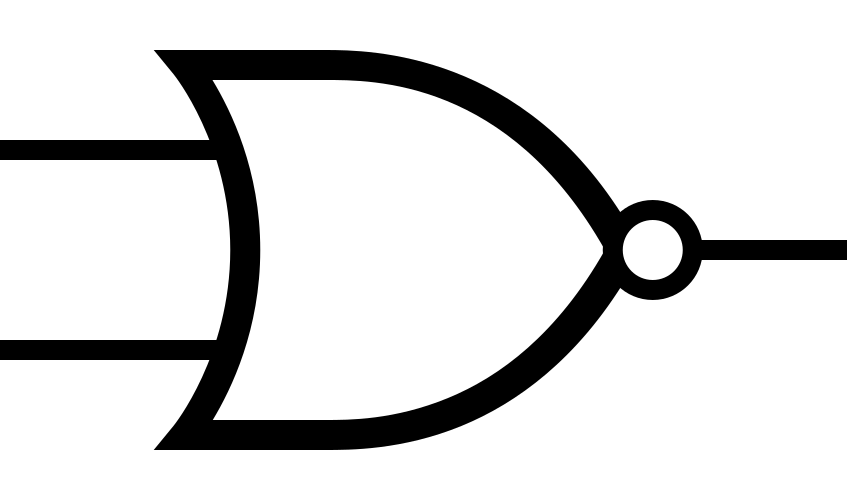
[picture p39: figure]
NOR logic - Wikipedia

#OE

Main CLK

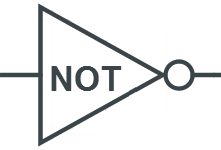
[picture p40: figure]
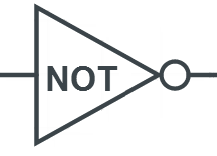
[picture p41: figure]

Bus Grant

5

6

#WE

µC 11: MEM Write

4

## SRAM (v2.0)

Data
Bus

~SRAM Chip En

#OE

#WE

Address Bus + Read/Write

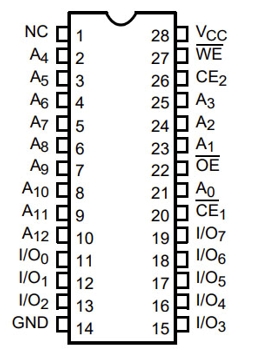
[picture p42: figure]

SRAM

A0..A15

I/O[0:7]

31

## EEPROM (v2.0)

Address Bus

Addr
[15:0]

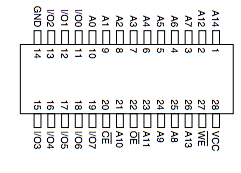
[picture p43: figure]
The Ben Eater EEPROM Programmer, 28C256 and Software Data Protection – Bread80.com

Prog EEPROM

Prog
Data[7:0]

~EEPROM Chip En

#OE

Data Bus

32

## Address Registers - Data Bus Load Enable v2.0

µC 17: LoadAR

µC 8: PC Load

PC Ld Branch

AR DB LE 8x8 LUT

µC 18: LoadAR H/L

Opcode_MAA

Opcode_5

BP[H] Ld En

EEPROM Address Bit | Input
7 | PC Ld Branch (Flags & µC 8: PC Load)
6 | loadAR (control signal)
5 | PC Load (control signal)
4 | loadARHorL (control signal)
3 | Opcode_MAA (ACTIVE LOW)
2 | (AR) L/H instruction operand
1 | ARDest[1]
0 | ARDest[0]

Opcode_7

Opcode_6

BP[L] Ld En

SP[H] Ld En

DHPC Ld En

DP[L] Ld En

PC Ld En

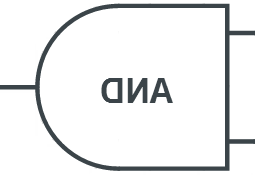
[picture p44: figure]

SP[L] Ld En

DP[H] Ld En

Main CLK

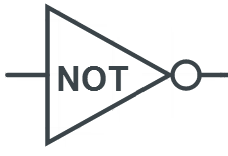
[picture p45: figure]

EEPROM Data Output Bit | Output
7 | BP[H] Load Enable (574 - ACTIVE HIGH)
6 | BP[L] Load Enable (574 - ACTIVE HIGH)
5 | SP[H] Load Enable (191 – ACTIVE High*)
4 | SP[L] Load Enable (191 - ACTIVE High*)
3 | DP[H] Load Enable (574 - ACTIVE HIGH)
2 | DP[L] Load Enable (574 - ACTIVE HIGH)
1 | DHPC Load Enable (574 - ACTIVE HIGH)
0 | PC[L] Load Enable (161 - ACTIVE LOW)

* 191 is active low, but to use the AND for clock gating they are Active High that later inverted

## Program Counter Design

- The Program Counter on Address Bus is a 16b pointer, with granularity of bytes.
- However, the actual HW counter is a 15b counter, counting instructions.
- So:
  - When SW writes to the HW counter, the data shift right, dropping the lsb (PC cannot be odd)
  - When HW Counter writes to the Address bus, it shift left, addith the lsb from the fetch FSM

Load PC from Dummy

Load PC from Data Bus

Load PC from Data+Dummy

15 | 14 | 13 | 12 | 11 | 10 | 9 | 8 | 7 | 6 | 5 | 4 | 3 | 2 | 1 | 0

15 | 14 | 13 | 12 | 11 | 10 | 9 | 8 | 7 | 6 | 5 | 4 | 3 | 2 | 1 | 0

dangled

0

HW Program Counter

dangled

15 | 14 | 13 | 12 | 11 | 10 | 9 | 8 | 7 | 6 | 5 | 4 | 3 | 2 | 1 | 0

PC on the Address Bus

Bit[0] from
Fetch FSM

## Program Counter (v2.0)

Notes:
- In SW view, PC points to Address,
- In HW view, PC points to instruction (div by 2)
- Read PC : PC shifts left
  - “INC Prog Counter” provides bit 0
- Write PC: (Absolute Branch, JSR, RTS) Dummy and Data shifted right (ignoee lsb)

DHPC Ld En

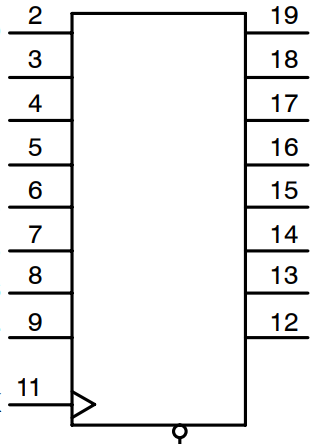
[picture p46: figure]

574: Prog Ctr
Dummy

0,[15:9]

Data Bus

Data
[7:5]

Data
[4:1]

Data[0] dangled

Main CLK

74HC161 PC[15:13]

74HC161 PC[12:9]

PC High[15:9]

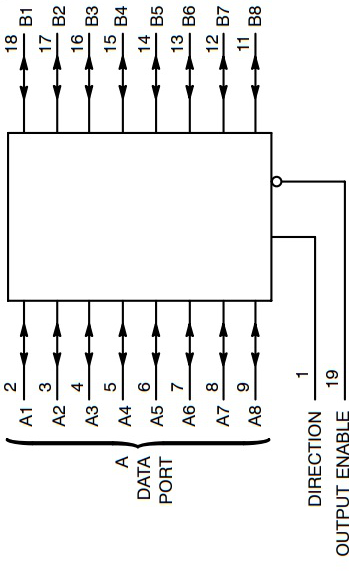
[picture p47: figure]
74HC245 Octal Bus Transceiver Pinout, Examples, Datasheet, Applications

74HC245

PC[14:8] → Addr[15:9]
INC → Addr[0]

‘0’

PC[8]

74HC161 PC[8:5]

74HC161 PC[4:1]

~Main Reset

Address Bus

PC
[8:5]

PC
[4:1]

PC Ld En

[0]

PC Low[8:1]

74HC245

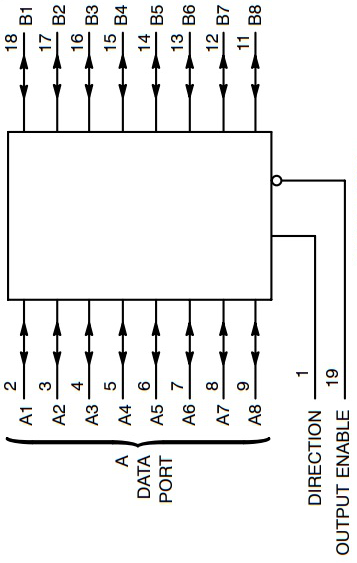
[picture p48: figure]
74HC245 Octal Bus Transceiver Pinout, Examples, Datasheet, Applications

PC[7:0 ]→ Addr[8:1]

Addr Low
[8:1]

INC Prog Counter

Addr Hi
[15:9, 0]

Program Counter OE

35

## Data Pointer (v2.0)

574: Addr Ptr Hi

574: Addr Ptr Lo

Address Bus + Read/Write

Data
Bus

A15..A8

A15..A8

DP[H] Ld En

A7..A0

A7..A0

DP[L] Ld En

Data Pointer OE

Clk

Control

!Clk

AND

Data is sampled in the middle of the clock (negative edge)

36

## Base Pointer (v2.0)

574: Addr Ptr Hi

574: Addr Ptr Lo

Address Bus + Read/Write

Data
Bus

A15..A8

A15..A8

BP[H] Ld En

A7..A0

A7..A0

BP[L] Ld En

Base Pointer OE

Clk

Control

!Clk

AND

Data is sampled in the middle of the clock (negative edge)

37

## Stack Pointer (v2.0)

µC 16: SP Up/Down

µC 15: SP Count

Main CLK

SP[H] Ld En

574: Stack Ptr Page

Address Bus + Read/Write

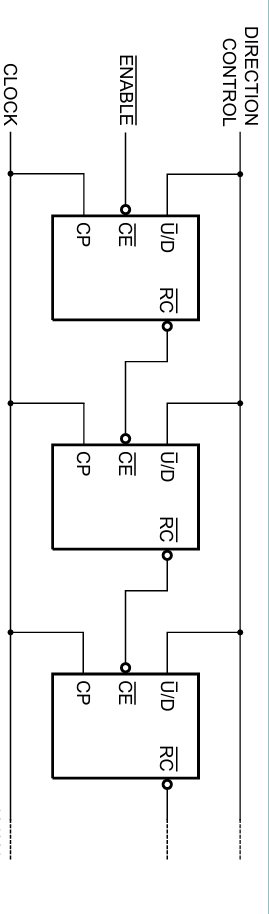
[picture p49: figure]

Data
Bus

SP 3:0

74HC191
A3:A0

A3..A0

A7..A0

SP 7:4

74HC191
A7:A4

A7..A4

SP 3:0

74HC191
A11:A8

A11..A8

574: Stack Ptr Page

Stack Pointer OE

A15..A8

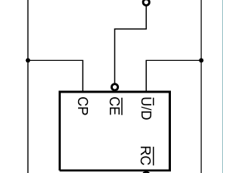
[picture p50: figure]

SP 7:4

A15..A12

74HC191
A15:A12

SP[L] Ld En

38

## Address to Data Bus

Main CLK

Bock clock during Output Enable

µC 21: AB2DB

Data Bus

Data
[7:0]

Addr Hi
[15:8]

Address Bus

Data
[7:0]

8

9

10

574: Addr Hi

574: Addr Lo

Addr Hi
[15:8]

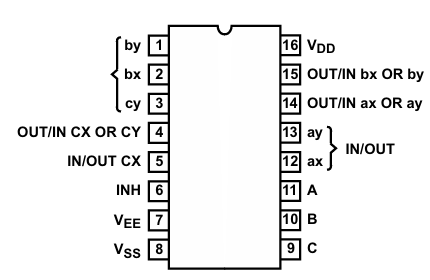
[picture p51: figure]

µC 21: AB2DB

1v

5v

Addr Lo OE

AR H/L (Instr[5])

11

1v

Addr Hi OE

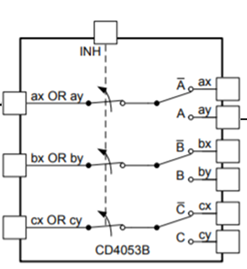
[picture p52: figure]

µC 22: AB2DB H/L

Opcode_MAA_JSR

Opcode_MAA_JSR

12

13

CD4053 A

1

3

0

µC 21: AB2DB

0v

µC 22: AB2DB H/L

12

0

11

CD4053 C

5

1

9

4

Addr Hi OE

0v

0v

AR H/L (Instr[5])

13

1

14

1

CD4053 B

0

10

1

2

1

15

Addr Lo OE

## TmpAR (Address Offset Adder) v2.0

Address Bus

Address Bus

Main CLK

5

6

Addr Hi
[15:8]

Addr Low
[7:0]

2

1

3

574: TmpAR Hi

574: TmpAR Lo

Read in the middle of the cycle

Addr Hi
[15:8]

Addr Hi
[15:8]

µC 19: TmpARRead

TmpAR OE

283: Add 3:0

283: Add 3:0

283: Add 3:0

283: Add 3:0

Addr Hi
[15:8]

Data
Sign Extended
[15:8]

Addr Lo
[7:0]

Data
[7:0]

Data Bus

## Output H Register to Data Bus (v2.0)

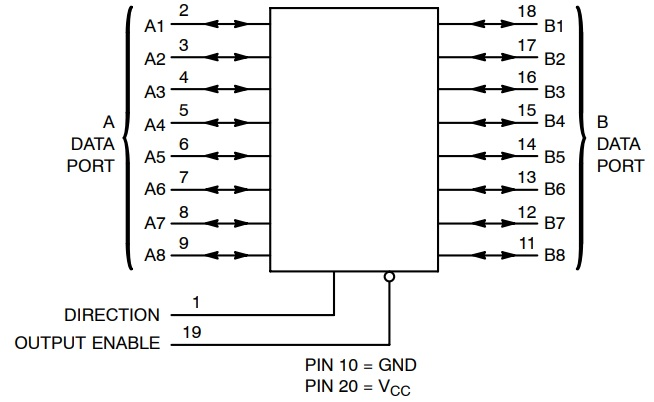
[picture p53: figure]
74HC245 Octal Bus Transceiver Pinout, Examples, Datasheet, Applications

HC245
H → Bus

HC245
H4 → Bus

Data
Bus

H Reg
8 bits

µC 6: Out Reg H

ALU Imm

TST Imm

OpCode_6

OpCode_13

Short H
[15:12]

0

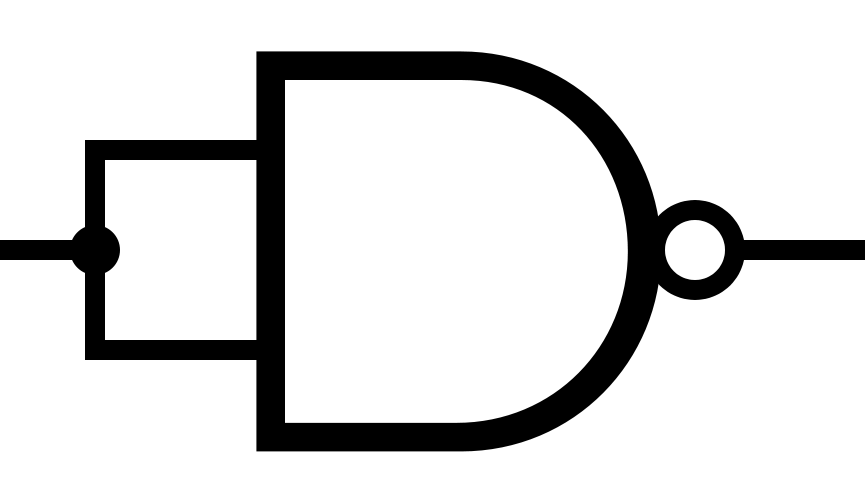
[picture p54: figure]

If opcode is 00110 or 10011, then 4-bit immediate from high instruction register
is written to the bus; otherwise, the full 8-bit high instruction register is written to
bus as an 8-bit immediate

41

## Fetch State Machine (v2.0)

Prog
Data[7:0]

OpCode
[4:0]

Prog
Data[7:0]

FetchCycle

273 Lo

µC 7: PC Advance

OpCode
[7:5] Flags

OpCode
[7:6] Rd RO

Main CLK

OpCode [5] A/I

175

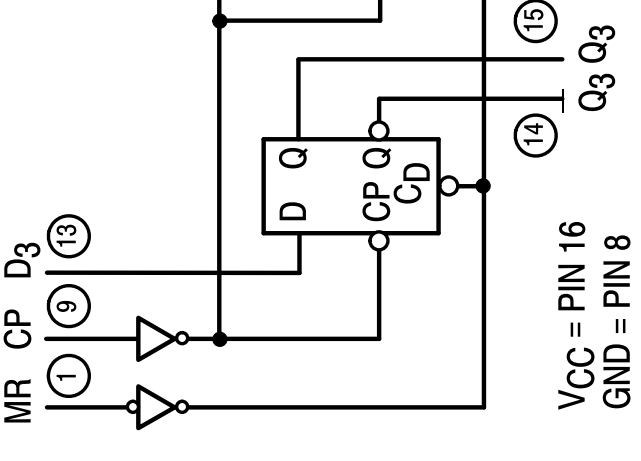
[picture p55: figure]

273 Hi

OpCode
[7:6] Rd RI

MR

H Reg
8 bits

Short H
[15:12]

# Main Reset

# Bus Grant

# Reset_microPC

Quiesce

INC Prog Counter

Bus Grant

MSB_Quiesce

42

## Micro Instructions EEPROMs (v2.0)

µC 23:

µC 22: AB2DB H/L

µC 15: SP Count

µC 14: SP Out

µC 7: PC Advance

µC 6: Out Reg H

µC 21: AB2DB

µC 20: TmpARWrite

µC 19: TmpARRead

µC 13: Reg Out Rd

µC 12: Ld Data Addr

µC 11: MEM Write

µC 5. Reg In En

µC 4: Reg Out En

µC 3: Reg Out Select

µC 5. Reg In En

µC 4. Reg Out En

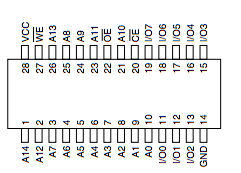
[picture p56: figure]
The Ben Eater EEPROM Programmer, 28C256 and Software Data Protection – Bread80.com

1,0,0,0,0,0,0,0

Micro Ins 16_23

µC 18: LoadAR H/L

µC 17: LoadAR

µC 16: SP Up/Down

1,0,0,0,0,0,0,0

Micro Ins 8_15

µC 10: MEM Read

µC 9: PC Out

µC 8: PC Load

µC 2: ALU Out En

µC 1: ALU Load A

µC 0: ALU Load B

Set A8 to quiesce all controls during the first clock while upper OpCode is loading

µC 2. ALU Out En

1,0,0,0,0,0,0,0

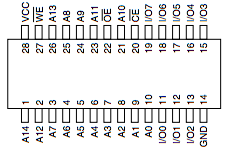
[picture p57: figure]
The Ben Eater EEPROM Programmer, 28C256 and Software Data Protection – Bread80.com

Micro Ins 0_7

MSB_Quiesce

0,0

5 bit

Opcode A7..A3

0,0

5 bit

3 bit

0,0

5 bit

3 bit

Counter A2..A0

3 bit

OpCode
[4:0]

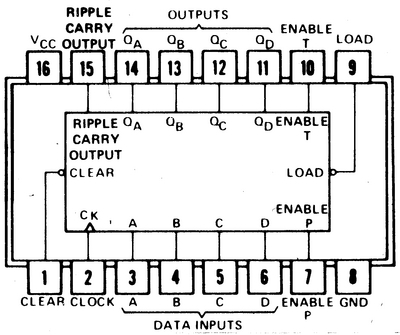
[picture p58: figure]

43

3 bit

# Reset_microPC

161

Main CLK

## Sharing the Data and Address Buses during Fetch Cycle

Last Instruction

Next Instruction

Address Bus

Data Bus

Control signals

Last Micro instruction
PC Advance

Addr+1
Inst address A8=1

Micro
instruction 0

Micro
instruction 1

Program Counter
Low addr

Program Counter
High addr

Next Instruction Low byte

Ld Low Instruction

Next Instruction High byte

Ld High Instruction

Ld Instruction

Clock

First clock of the next instruction, buses are used to load the high byte of the instruction. To avoid transmission of the first micro instruction on the buses, the micro instruction address bit A8 is set, and all control signals are set to 0, avoiding any transmission on the busses

Micro Instruction 0 controls the buses

Last clock of an instruction includes the PC_Advance.
In that clock, the Address and Data buses are used by the Program Counter. No other signal using the address or data buses is allowed.

## PC Advance - Logic Analyzer

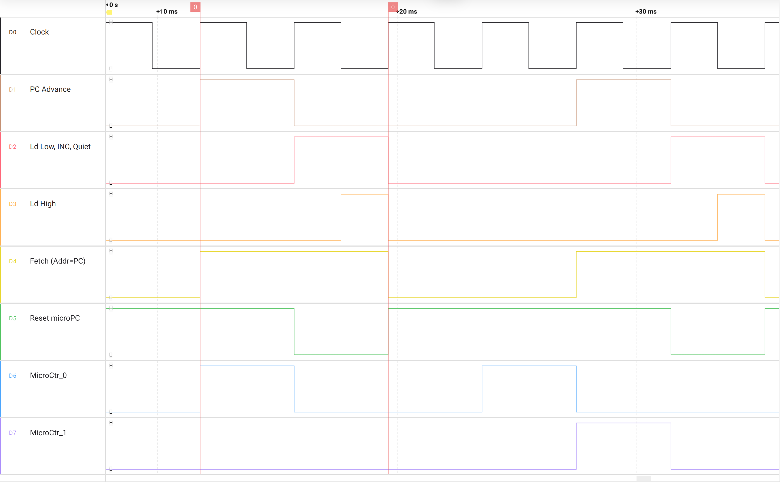
[picture p59: figure]

PC Advance

Address Bus controlled by Prog Count

Ld Low (rising)
INC, Quiesce

Ld High
(from INC)

Reset Micro Instruction Ctr

CTR=0

CTR=0

CTR=1

CTR=2

## Bus Arbitration for I/O

Normal
- CPU owns buses

MMIO Buses Request
- No change
- CPU owns buses till end of instruction

MMIO Buses Granted
- CPU does not transmit on
  - Address bus
  - Data bus
  - Micro instruction controls
- Microinstruction counter held in reset

MMIO request

End of
Micro instruction

Bus Release

175

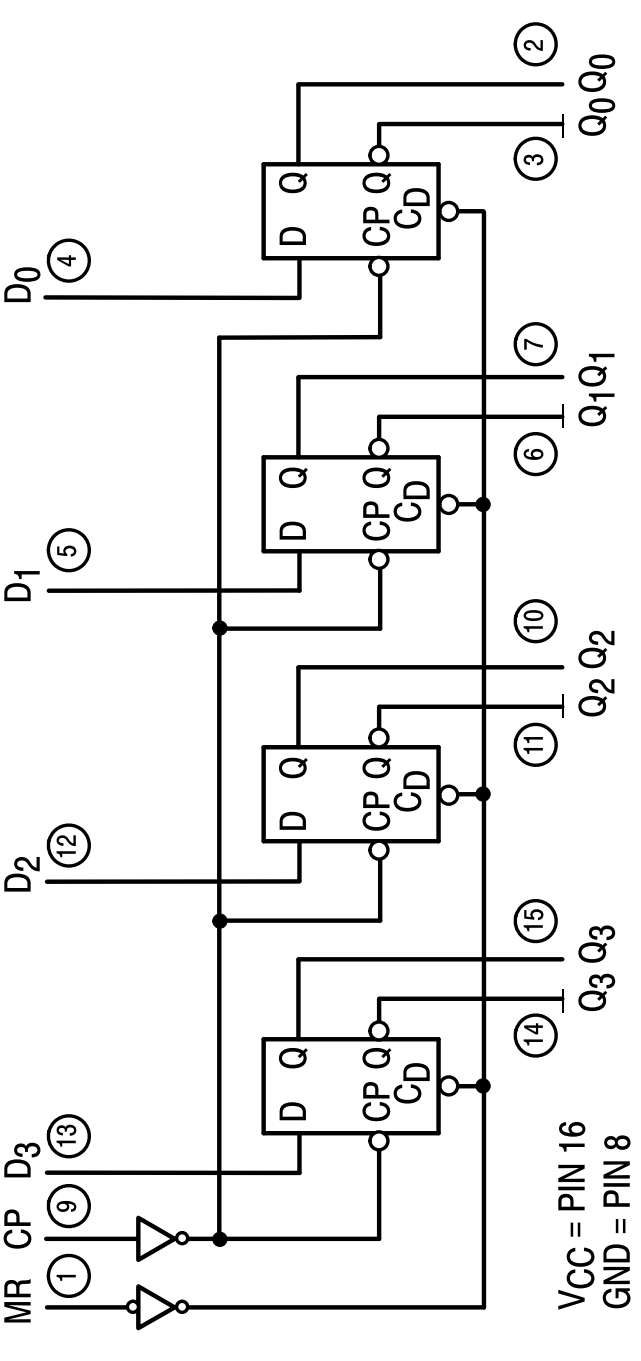
[picture p60: figure]

Requested

1

3

1

3

Bus Request

2

2

4

5

6

5

Bus Grant

Quiesce

4

6

12

13

11

# Bus Release

## SD Card – Page Load / Store

Operation | ReadRAM# | WriteRAM# | Addr_En# | Dat_ dir | SRAM OE# | SRAM WE#
Idle | 0 | 0 | 1 | N/A | N/A | N/A
RAM → SD | 0 | 1 | 0 | In | 0 | 1
SD → RAM | 1 | 0 | 0 | Out | 1 | 0
Idle | 1 | 1 | 1 | N/A | N/A | N/A

Address | R/W | Register
Base Addr | W | Addr Hi
+1 | W | Sector Hi
+2 | W | Sector Lo
+3 | W | Go

8-bit data bus

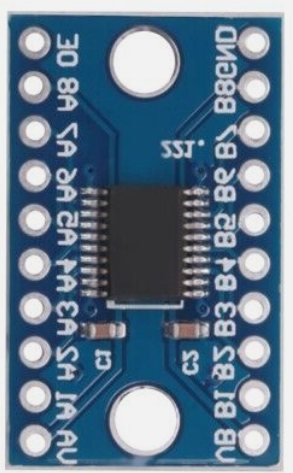
[picture p61: figure]

Data bus

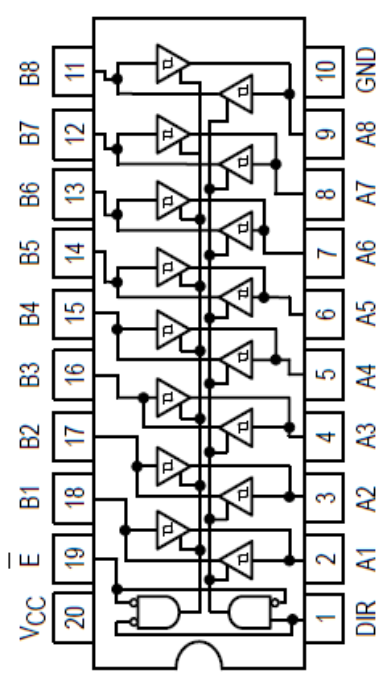
[picture p62: figure]

HC245 Data Out

Data bus

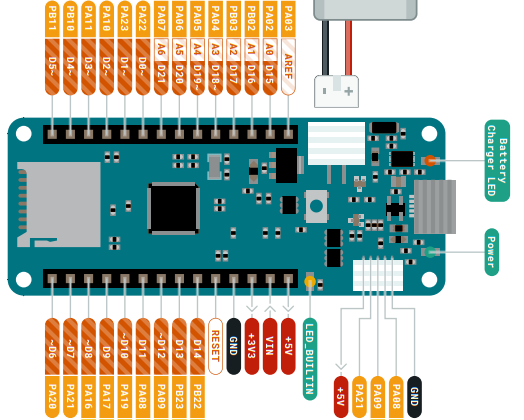
[picture p63: figure]

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
RESET
GND
VCC (3.3v)
VIN (5v)
5V

165 Sector Lo

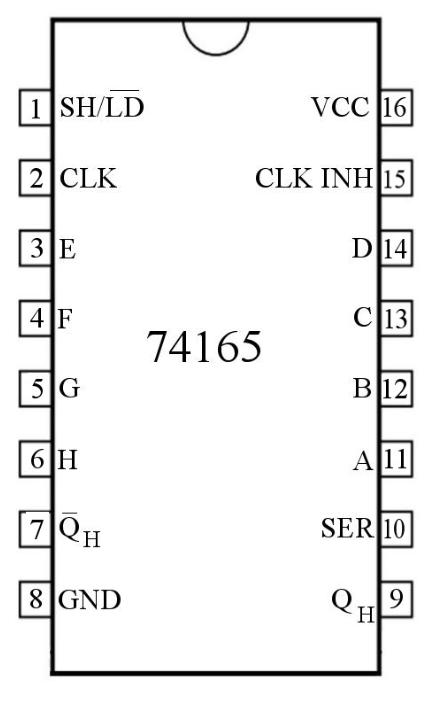
[picture p64: figure]

165 Sector Hi

WriteRAM#

Addr_en#

Addr_en#

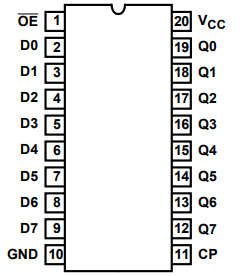
[picture p65: figure]

574 Addr - High

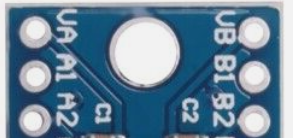
[picture p66: figure]

# Bus Release

165 Sector Hi

Ld Sector

138 Decoder

Addr 15:8

17 – ReadRAM#

16 – WriteRAM#

Load Addr Hi

~SD Card Device En

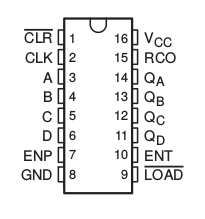
[picture p67: figure]

7:4 Ctr

3.3v – 5v
bi-directional
level shifters

# Main Reset

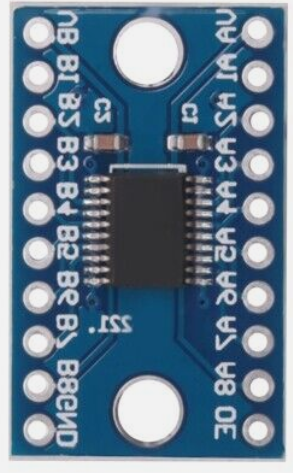
[picture p68: figure]

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
Addr_en#
XNOR

#WE

Addr 2:0

Addr_en#

Addr 7:4

11 - Serial_IN

10 – RESET Counters

9 - CNT/CLK

8 - GO_INT

12 - Shift

3:0 Ctr

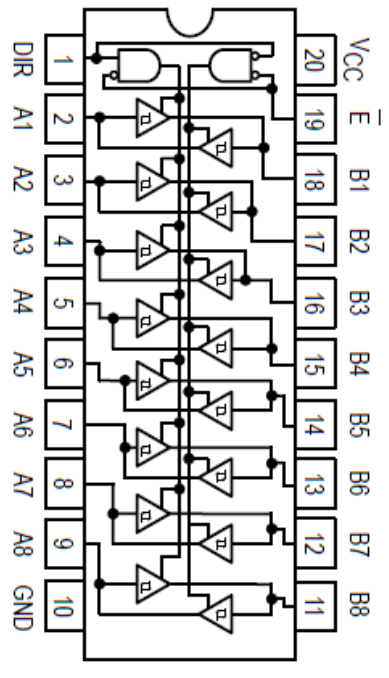
[picture p69: figure]

HC245 Addr Out

Addr 3:0

Bus Grant

Bus Request

47

## Counter (v2.0)

Data Bus

Address | R/W | Register
Base Addr E200 | W | Reset Counter
+1 | W | Latch Counter
+2 | R | Read Counter 0
+3 | R | Read Counter 1
+4 | R | Read Counter 2
+5 | R | Read Counter 3
+6 | R | RNG Read

74HC590 Counter

Addr 2:0

#WE

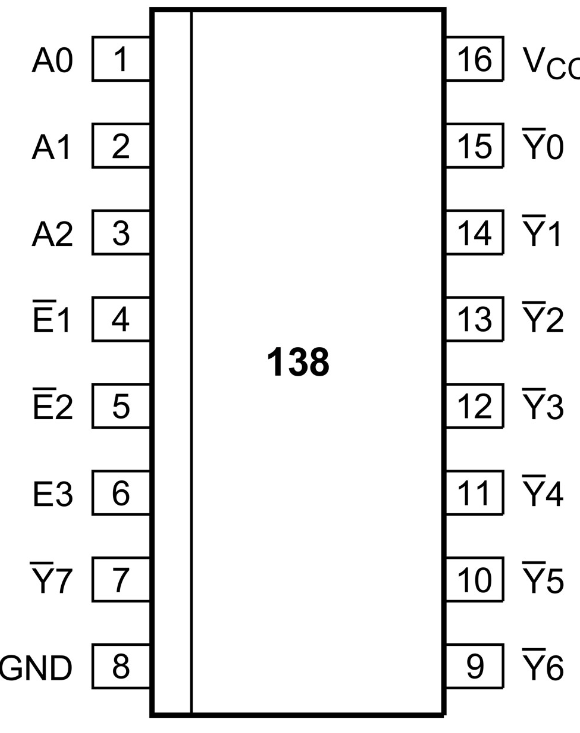
[picture p70: figure]

Write Decoder

MRC: Reset Counter

CPR: Latch Counter

74HC590 Counter

~Counter Device En

Addr 2:0

#OE

Read Decoder

74HC590 Counter

RNG Rd

74HC590 Counter

74HC590 Counter

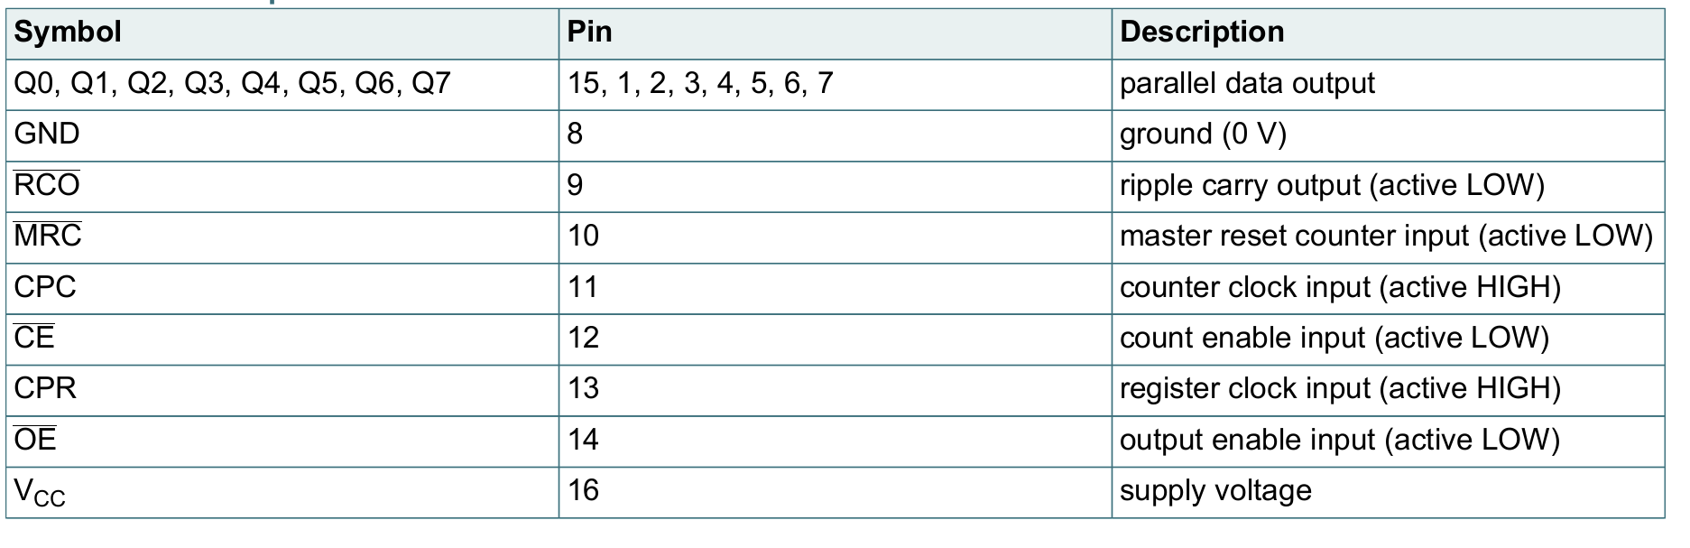
[picture p71: figure]

## RNG (V2.0)

HC164

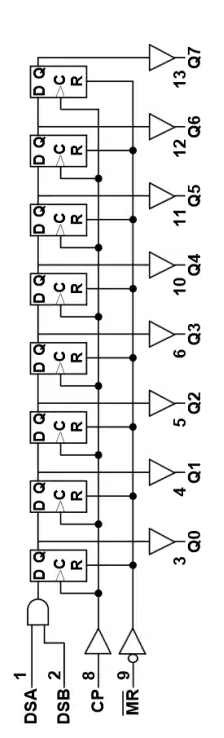
[picture p72: figure]

RNG Rd

10

9

8

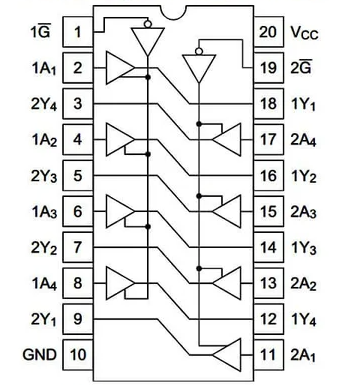
[picture p73: figure]

1

12

13

11

Data Bus

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
Clock

5v

## OpCode Decoder (v2.0)

OpCode_18

MAAL

OpCode_10

JSR

OpCode_08

Out Reg

OpCode_0D

OpCode_1

BRK

OpCode_19

OpCode_MAG

OpCode_1B

MAAH

1A

LDA

MGA

OpCode_11

OpCode_13

RTS

TST Im

Out Imm

OpCode_05

OpCode_6

Branch Absolute

ALU Immediate

74HC138
OpCodes 24-31

OpCode_1C

OpCode_1D

OpCode_1E

Unused

Unused

Unused

74HC138
OpCodes 16-23

74HC138
OpCodes 8-15

74HC138
OpCodes 0-7

OpCode_7

Branch Relative

OpCode_1F

‘0’

0

1

2

3

4

OpCode
[4:0]

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
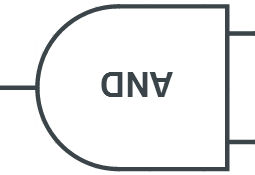
[picture p74: figure]

50

## Slide 51

ALU Interface – Flags, A,B Registers, Op Code selection (v2.0)

Clock

MR

A_I

Clk

µC 1: ALU Load A

ALU

74HC161

74HC161

74HC161

74HC161

74HC251

74HC161

Clk

Branch Relative

µC 0: ALU Load B

Gray

Data
Bus

A

OpCode_7

Don’t update flags on BR relative

4b’0110 (ADD)

74HC157

0

ALU OpCode

B

Function H[3:0]

1

µC 2. ALU Out En

Data Bus

Flags captured on ALU Out (161 Parallel Load Enable)

C

Flags

Flags

Carry In

Notes: Registers A and B are implemented by two HC161s, each stores 4 bits as the typical HC273 and HC347 won't fit into the 16pin sockets on the ALU wirewrap board.
~~The branch relative instruction (Obsolete) doesn’t update flag bits to avoid corrupting the flag register state when executing a branch instruction (which may occur due to the ADD operation performed)~~

## ALU OpCodes 2,3,7

Op Select | Special Func. = 0 | | Special Func. = 1 | | Flag in
010 - 2 | A XOR B | XOR: 4 | !B | NOT: 5 | -
011 - 3 | A + B | ADD: 6 | A – B | SUB: 7 | -
111- 7 | A + B + Cin | ADC: E | A – B + Cin | SBC: F | Cin

ALU opcode(010), SF(0 / 1) – A XOR B / !B
No change to the source SF for ADD/SUB/ADC/SBC/!B

SF

ALU_Op[0]

{Op =XX0, SF = 0} → A XOR B; Else B or !B

x8

Adder

Carry-in to Adder

ADD/SUB/ADC/SBC/!B

B

A

Op Codes
‘011’ , ‘111’

SF

A

8

0

1

x8

8

!B or (A XOR B)

B or !B

Op Code ‘010’ output

52

## Branch (v2.0)

Note: PC Ld Lo is renamed to PC Load Branch.

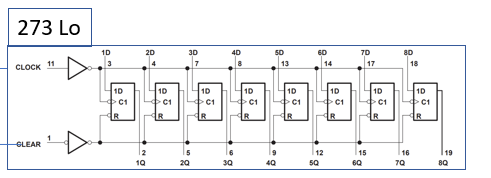
[picture p75: figure]

OpCode
[7:5]

Q7 Q6 Q5

Instruction LSB

µC 8: PC Load

D4
D5
D6
D7

‘1’

PC Ld Branch

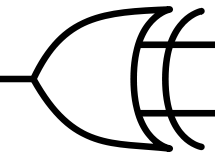
[picture p76: figure]

74HC151

‘C’

‘N’

‘Z’

74HC161

Flags

C2 | C1 | C0 | Condition | Instruction LSB | Equivalent Assembly Instruction
0 | 0 | 0 | JMP | 05 | JMP
0 | 0 | 1 | N | 25 | BMI – Branch on Minus
0 | 1 | 0 | C | 45 | BCS – Branch Carry Set
0 | 1 | 1 | Z | 65 | BEQ – Branch Equal
1 | 0 | 0 | Never | 85 | NOP
1 | 0 | 1 | !N | A5 | BPL – Branch on Plus
1 | 1 | 0 | !C | C5 | BCC – Branch Carry Clear
1 | 1 | 1 | !Z | E5 | BNE

## Instruction set (v2.0)

Op code | Instruction | Details
0x00 | NOP | No operation
0x01 | BRK | Halt the program
0x02 | ALU (Format ALU Rd, Rs1, Rs2) | ALU instruction (OR, AND, XOR, NOT, ADD, SUB, ASL, ROL, LSR, ASR, ROR, ADC, SBC)
0x03 | LDR | Load Register from immediate
0x04 | MOV | Copy Register (MOV instruction in ARM)
0x05 | Branch Absolute | Conditional/Unconditional Jump to a 16-bit address
0x06 | ALU Immediate (Format: ALU Rd, Rd, imm) | ALU instruction with value from immediate
0x07
0x08 | OUT register | Print a register as a character or integer
0x09
0x0A
0x0B
0x0C
0x0D | OUT Immediate | Print the immediate next byte as a character or integer
0x0E | PUSH
0x0F | POP
0x10 | JSR | Jump Subroutine, store current PC in stack
0x11 | RTS | Return Subroutine, Load PC from stack
0x12 | TST Registers | Compare registers
0x13 | TST Register | Compare register and immediate
0x14 | LDW1 | Load Data Byte with Offset 1 (PC or SP)
0x15 | LDW2 | Load Data Byte with Offset 2 (DP or BP)
0x16 | SDW1 | Store Data Byte with Offset 1 (PC or SP)
0x17 | SDW2 | Store Data Byte with Offset 2 (DP or BP)
0x18 | MAA1 | Move Address with Offset to Address 1 (PC or SP)
0x19 | MAA2 | Move Address with Offset to Address 2 (DP or BP)
0x1A | MAG | Move Address to General register
0x1B | LDA | Load Address register
0x1C | MGA | Move General to Address register

Covered by BIST
Implemented
Planned
Deprecating
Not used

54

## ALU with changes

Op Select | Special Func. = 0 | | Special Func. = 1 | | Flag in | Flags Out
0 | A OR B | OR: 0 | A OR B | | - | Z, N
1 | A AND B | AND: 2 | A AND B | | -
2 | A XOR B | XOR: 4 | ~B | NOT: 5 | - | Z, N
3 | A + B | ADD: 6 | A – B | SUB: 7 | - | Z, N, Co
4 | Shift Left A A[0]=0 | ASL: 8 | Rotate left A A[0]=Cin | ROL: 9 | Cin (Rotate) | Z, N=A[6], Co=A[7]
5 | Shift Right A | LSR: A | Arithmetic S.R. A | ASR: B | - | Z, N, Co=A[0]
6 | Rotate Right | ROR: C | Cin -> A-> Cout | | Cin | Z, N, Co=A[0]
7 | A + B + Cin | ADC: E | A – B + Cin | SBC: F | Cin | Z, N, Co

Proposal | # of IC slots | Description | Op Code
OR and ADD share Op Code (low priority) | 2x 74LS157 | Special Function select OR or AND | Release op code
Allow using ALU as two registers (low Priority) | | Need to create output A and B

Proposals for the additional operations
- How to chain Shift Right of two bytes?

55

## Micro-Instructions Control: NOP Instruction (00000)

Cycle # | Instruction | Explanation
0 | 10000000 = 0x80 | Increment PC
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
Bit | Operation
16 | Stack Pointer Increment / Decrement (0: decrease / 1: increase)
15 | Stack Pointer Count
14 | RAM Address Select (0: Address register / 1: Stack pointer)
13 | Use Rd as Source
12 | Lower Address Register Load
11 | Mem Write
10 | Mem Read
9 | PC Out
8 | PC Load
7 | PC advance
6 | Program Register H Write to Bus (parameter)
5 | Register File Input Enable
4 | Register File Output Enable
3 | Register File Output Select (parameter – 0 -> Rs1, 1 -> Rs2)
2 | ALU output enable
1 | ALU load register A
0 | ALU load register B

Bit | Operation
17 | Load Special Register
16 | Stack Pointer Increment / Decrement (0: decrease / 1: increase)
15 | Stack Pointer Count
14 | RAM Address Select (0: Address register / 1: Stack pointer)
13 | Use Rd as Source
12 | Lower Address Register Load
11 | Mem Write
10 | Mem Read
9 | PC Out
8 | PC Load
7 | PC advance
6 | Program Register H Write to Bus (parameter)
5 | Register File Input Enable
4 | Register File Output Enable
3 | Register File Output Select (parameter – 0 -> Rs1, 1 -> Rs2)
2 | ALU output enable
1 | ALU load register A
0 | ALU load register B

NOP

Type | 15 14 | 13 12 | 11 10 9 8 | 7 6 | 5 | 4 3 2 1 0
None | XX | X | XXXX | XX | X | OpCode=00

56

## Micro-Instructions Control: BREAK (00001)

Cycle # | Instruction | Explanation
0 | 10000000 = 0x80 | Increment PC
1
2
3
4
5
6
7

Note: BRK has the same microcode as NOP, but the opcode decoder halts the clock when the opcode 00001 is detected. Stepping through it manually (via Single-Step / Run button press) resumes the clock. Hence, BRK acts as a hardware breakpoint.

1

Bit | Operation
16 | Stack Pointer Increment / Decrement (0: decrease / 1: increase)
15 | Stack Pointer Count
14 | RAM Address Select (0: Address register / 1: Stack pointer)
13 | Use Rd as Source
12 | Lower Address Register Load
11 | Mem Write
10 | Mem Read
9 | PC Out
8 | PC Load
7 | PC advance
6 | Program Register H Write to Bus (parameter)
5 | Register File Input Enable
4 | Register File Output Enable
3 | Register File Output Select (parameter – 0 -> Rs1, 1 -> Rs2)
2 | ALU output enable
1 | ALU load register A
0 | ALU load register B

Bit | Operation
17 | Load Special Register
16 | Stack Pointer Increment / Decrement (0: decrease / 1: increase)
15 | Stack Pointer Count
14 | RAM Address Select (0: Address register / 1: Stack pointer)
13 | Use Rd as Source
12 | Lower Address Register Load
11 | Mem Write
10 | Mem Read
9 | PC Out
8 | PC Load
7 | PC advance
6 | Program Register H Write to Bus (parameter)
5 | Register File Input Enable
4 | Register File Output Enable
3 | Register File Output Select (parameter – 0 -> Rs1, 1 -> Rs2)
2 | ALU output enable
1 | ALU load register A
0 | ALU load register B

BRK

Type | 15 14 | 13 12 | 11 10 9 8 | 7 6 | 5 | 4 3 2 1 0
None | XX | X | XXXX | XX | X | OpCode=01

57

## Micro-Instructions Control: ALU (00010)

Cycle # | Instruction | Explanation
0 | 00010010 = 0x12 | Load Rs1 to reg A
1 | 00011001 = 0x19 | Load Rs2 to reg B
2 | 00100100 = 0x24 | Output and Read to Rd
3 | 10000000 = 0x80 | Increment PC
4
5
6
7

2

Bit | Operation
16 | Stack Pointer Increment / Decrement (0: decrease / 1: increase)
15 | Stack Pointer Count
14 | RAM Address Select (0: Address register / 1: Stack pointer)
13 | Use Rd as Source
12 | Lower Address Register Load
11 | Mem Write
10 | Mem Read
9 | PC Out
8 | PC Load
7 | PC advance
6 | Program Register H Write to Bus (parameter)
5 | Register File Input Enable
4 | Register File Output Enable
3 | Register File Output Select (parameter – 0 -> Rs1, 1 -> Rs2)
2 | ALU output enable
1 | ALU load register A
0 | ALU load register B

Bit | Operation
17 | Load Special Register
16 | Stack Pointer Increment / Decrement (0: decrease / 1: increase)
15 | Stack Pointer Count
14 | RAM Address Select (0: Address register / 1: Stack pointer)
13 | Use Rd as Source
12 | Lower Address Register Load
11 | Mem Write
10 | Mem Read
9 | PC Out
8 | PC Load
7 | PC advance
6 | Program Register H Write to Bus (parameter)
5 | Register File Input Enable
4 | Register File Output Enable
3 | Register File Output Select (parameter – 0 -> Rs1, 1 -> Rs2)
2 | ALU output enable
1 | ALU load register A
0 | ALU load register B

ADD Rd, Rs1, Rs2

Type | 15 14 13 12 | 11 10 | 9 8 | 7 6 5 4 | 3 2 | 1 0
ALU | OpCode | XX | Rd | Function | Rs1 | Rs2

Type | 15 14 | 13 12 | 11 10 9 8 | 7 6 | 5 | 4 3 2 1 0
ALU | Rs2 | Rs1 | S2 S1 S0 SF (Function sel) | Rd | X | OpCode=02

58

## Micro-Instructions Control: Load Immediate to Reg (00011)

Cycle # | Instruction | Explanation
0 | 01100000 = 0x60 | Write imm to bus and Rd read
1 | 10000000 = 0x80 | Increment PC
2
3
4
5
6
7

3

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

LDR Rd, #0x00

Type | 15 14 | 13 12 | 11 10 9 8 | 7 6 | 5 | 4 3 2 1 0
Load Imm | Immediate (8-bit) | | Immediate (8-bit) | Rd | X | OpCode=03

59

## Micro-Instructions Control: MOV (00100)

Cycle # | Instruction | Explanation
0 | 00110000 = 0x30 | Write Rs1 to bus and Rd reads
1 | 10000000 = 0x80 | Increment PC
2
3
4
5
6
7

4

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

MOV Rd, Rs1

Type | 15 14 | 13 12 | 11 10 9 8 | 7 6 | 5 | 4 3 2 1 0
Load Reg | XX | Rs1 | XXXX | Rd | X | OpCode=04

60

## Micro-Instructions Control: Branch / Jump Absolute Immediate (00101)

Cycle # | Instruction | Explanation
0 | 0x1_40 01_0100_0000 | Write H register to bus and PC (conditionally) reads
1 | 0x0_80 00_1000_0000 | PC advance
2
3
4
5
6
7

C2 | C1 | C0 | Condition | Low instruction register | Assembly
0 | 0 | 0 | JMP | 05 | JMP
0 | 0 | 1 | N | 25 | BMI – Branch on Minus
0 | 1 | 0 | C | 45 | BCS – Branch Carry Set
0 | 1 | 1 | Z | 65 | BEQ – Branch Equal
1 | 0 | 0 | Never | 85 | NOP
1 | 0 | 1 | !N | A5 | BPL – Branch on Plus
1 | 1 | 0 | !C | C5 | BCC – Branch Carry Clear
1 | 1 | 1 | !Z | E5 | BNE

5

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

Type | 15 14 | 13 12 | 11 10 9 8 | 7 6 5 | 4 3 2 1 0
Branch | Immediate (8-bit) | | Immediate (8-bit) | C2 C1 C0 | OpCode=05

61

## Micro-Instructions Control: ALU immediate (4-bit) (00110)

Cycle # | Instruction | Explanation
0 | 10_0000_0001_0010 = 2012 | Load Rd to reg A
1 | 0100_0001 = 0x0041 | Load 4 bit imm to reg B
2 | 0010_0100 = 0x0024 | Write ALU output to Rd
3 | 1000_0000 = 0x0080 | Increment PC
4
5
6
7

ADD Rd, #0x00

6

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

Type | 15 14 13 12 | 11 10 | 9 8 | 7 6 5 4 | 3 2 | 1 0
ALU | OpCode | XX | Rd | Function | Rs1 | Rs2

Type | 15 14 13 12 | 11 10 9 8 | 7 6 | 5 | 4 3 2 1 0
ALU | 4-bit imm. | S2 S1 S0 SF (Function sel) | Rd | X | OpCode=06

62

## Micro-Instructions Control: Branch / Jump Relative Immediate (00111)

Cycle # | Instruction | Explanation
0 | 10_0000_0010 0x2_02 | Load PC into reg A
1 | 00_0100_0001 0x0_41 | Load immediate into reg B
2 | 01_0000_0100 0x1_04 | Output ALU val, load PC
3 | 00_1000_0000 0x0_80 | Advance PC
4
5
6
7

C2 | C1 | C0 | Condition | OpCode | Assembly
0 | 0 | 0 | JMP | 07 | JMP
0 | 0 | 1 | N | 27 | BMI – Branch on Minus
0 | 1 | 0 | C | 47 | BCS – Branch Carry Set
0 | 1 | 1 | Z | 67 | BEQ – Branch Equal
1 | 0 | 0 | Never | 87 | NOP
1 | 0 | 1 | !N | A7 | BPL – Branch on Plus
1 | 1 | 0 | !C | C7 | BCC – Branch Carry Clear
1 | 1 | 1 | !Z | E7 | BNE

7

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

Note: This only sets the PC Low register! As such, this instruction is Deprecated.

Type | 15 14 | 13 12 | 11 10 9 8 | 7 6 5 | 4 3 2 1 0
Branch | Immediate (8-bit) | | Immediate (8-bit) | C2 C1 C0 | OpCode=07

63

## Micro-Instructions Control: OUT (01000) (Display ASCII or Integer)

Cycle # | Instruction | Explanation
0 | 0000_0000 = 0x00 | Wait for H register to be loaded (need value of Rs1)- No longer required
1 | 0001_0000 = 0x10 | Write Rs1 to the bus (when opcode 01000 is detected, the value on the bus is read by the OUT register to the display)
2 | 1000_0000 = 0x80 | Advance PC
3
4

8

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

OUT Rs1, A

Type | 15 14 13 12 | 11 10 | 9 8 | 7 6 5 4 | 3 2 | 1 0
Load Reg | OpCode | XX | Rd | XXXX | Rs1 | XX

Type | 15 14 | 13 12 | 11 10 9 8 | 7 6 | 5 | 4 3 2 1 0
Out | XX | Rs1 | XXXX | XX | I=1; A=0 | OpCode=08

64

## Micro-Instructions Control: OUT immediate (01101)

Cycle # | Instruction | Explanation
0 | 0000_0000 = 0x00 | Wait for H instruction register to be loaded
1 | 0100_0000 = 0x40 | Write program register H to the bus
2 | 1000_0000 = 0x80 | Advance PC
3
4

D

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

OUT #Imm, A

Type | 15 14 13 12 | 11 10 | 9 8 | 7 6 5 4 | 3 2 | 1 0
Load Reg | OpCode | XX | Rd | XXXX | Rs1 | XX

Type | 15 14 | 13 12 | 11 10 9 8 | 7 6 | 5 | 4 3 2 1 0
Out | 8-bit immediate | | XXXX | XX | I=1; A=0 | OpCode=0D

65

## Micro-Instructions Control: PUSH (01110)

Cycle # | Instruction | Explanation
0 | 0x00_80_00 | (SP--;) Decrement SP.
1 | 0x00_48_10 | (*SP = Rs1;) Write Rs1 to the Data Bus, Write SP to the Address Bus, and Set Memory to read from the Data Bus.
2 | 0x00_00_80 | Advance PC.

E

Bit | Operation
23 | Not Used
22 | AddressHorL
21 | AddressBusToDataBus
20 | TmpARWrite
19 | TmpARRead
18 | loadARHorL
17 | loadAR (formerly: Load Special Pointer)
16 | Stack Pointer Increment / Decrement (0: decrease / 1: increase)
15 | Stack Pointer Count
14 | SP Out (formerly: RAM Address Select (0: Address register / 1: Stack pointer))
13 | Use Rd as Source
12 | Lower Address Register Load
11 | Mem Write
10 | Mem Read
9 | PC Out
8 | PC Load
7 | PC advance
6 | Program Register H Write to Bus (parameter)
5 | Register File Input Enable
4 | Register File Output Enable
3 | Register File Output Select (parameter – 0 -> Rs1, 1 -> Rs2)
2 | ALU output enable
1 | ALU load register A
0 | ALU load register B

SP--;
*SP = Rs1

PUSH R2

Type | 15 14 | 13 12 | 11 10 9 8 | 7 6 | 5 | 4 3 2 1 0
PUSH | XX | Rs1 | XXXX | XX | X | OpCode=0x0e

66

## Micro-Instructions Control: POP (01111)

Cycle # | Instruction | Explanation
0 | 0x01_c4_20 | (Rd = *SP; SP++;) Write SP to the Address Bus, Set Memory to write to the Data Bus, Set Rd to read from the Data Bus, and increment SP.
1 | 0x00_00_80 | Advance PC.

F

Bit | Operation
23 | Not Used
22 | AddressHorL
21 | AddressBusToDataBus
20 | TmpARWrite
19 | TmpARRead
18 | loadARHorL
17 | loadAR (formerly: Load Special Pointer)
16 | Stack Pointer Increment / Decrement (0: decrease / 1: increase)
15 | Stack Pointer Count
14 | SP Out (formerly: RAM Address Select (0: Address register / 1: Stack pointer))
13 | Use Rd as Source
12 | Lower Address Register Load
11 | Mem Write
10 | Mem Read
9 | PC Out
8 | PC Load
7 | PC advance
6 | Program Register H Write to Bus (parameter)
5 | Register File Input Enable
4 | Register File Output Enable
3 | Register File Output Select (parameter – 0 -> Rs1, 1 -> Rs2)
2 | ALU output enable
1 | ALU load register A
0 | ALU load register B

Rd = *SP;
SP++

POP R1

Type | 15 14 | 13 12 | 11 10 9 8 | 7 6 | 5 | 4 3 2 1 0
POP | XX | XX | XXXX | Rd | X | OpCode=0x0f

67

## Micro-Instructions Control: JSR (10000)

Cycle # | Instruction | Explanation
0 | 0x00_82_00 | (SP--; Address Bus Register High = PC[H];) Write PC to the Address Bus (captured by A2D).
1 | 0x60_48_00 | (*SP = PC[H]) Write SP to the Address Bus, Write A2D High to the Data Bus (PC[H]), Set Memory to store in *SP.
2 | 0x00_82_00 | (SP--; Address Bus Register Low = PC[L]) Write PC to the Address Bus (captured by A2D).
3 | 0x20_48_00 | (*SP = PC[L]) Write SP to the Address Bus, write Address Bus Register Low to the Data Bus (PC[L]), and set Memory to read from the Data Bus.
4 | 0x00_00_00 | (Address Bus Register High = DP[H]) Write DP to the Address Bus.
5 | 0x66_01_00 | (DHPC = DP[H]; Address Bus Register Low = DP[L]) Write DP to the Address Bus, write Address Bus Register High to the Data Bus (DP[H], and set DHPC to load from the Data Bus.
6 | 0x22_01_00 | (PC[L] = DP[L] (and PC[H] = DHPC)) Write Address Bus Register Low to the Data Bus (DP[L]) and set PC[L] to load from the Data Bus.
7 | 0x00_00_80 | Advance PC.

SP--; *SP = PC[H]; SP--;
*SP = PC[L]; PC = DP;

10

Bit | Operation
23 | Not Used
22 | AddressHorL
21 | AddressBusToDataBus
20 | TmpARWrite
19 | TmpARRead
18 | loadARHorL
17 | loadAR (formerly: Load Special Pointer)
16 | Stack Pointer Increment / Decrement (0: decrease / 1: increase)
15 | Stack Pointer Count
14 | SP Out (formerly: RAM Address Select (0: Address register / 1: Stack pointer))
13 | Use Rd as Source
12 | Lower Address Register Load
11 | Mem Write
10 | Mem Read
9 | PC Out
8 | PC Load
7 | PC advance
6 | Program Register H Write to Bus (parameter)
5 | Register File Input Enable
4 | Register File Output Enable
3 | Register File Output Select (parameter – 0 -> Rs1, 1 -> Rs2)
2 | ALU output enable
1 | ALU load register A
0 | ALU load register B

JSR

Type | 15 14 | 13 12 | 11 10 9 8 | 7 6 | 5 | 4 3 2 1 0
JSR | XX | XX | XXXX | XX | X | OpCode=0x10

68

## Micro-Instructions Control: RTS (10001)

Cycle # | Instruction | Explanation
0 | 0x01_80_00 | (SP++;) Increment SP. (Point to Return address HIGH)
1 | 0x06_45_00 | (DHPC = *SP) Write SP to the Address Bus, Set Memory to write to the Data Bus, Set DHPC to read from the Data Bus, and decrement SP.
2 | 0x00_80_00 | SP-- (Point to Return address LOW)
3 | 0x03_45_00 | (PC[L] = *SP) Write SP to the Address Bus, Set Memory to write to the Data Bus, Set PC[L] to read from the Data Bus (and PC[H] = DHPC).
4 | 0x01_80_00 | (SP++;) Increment SP. (POP first half)
5 | 0x01_80_80 | (SP++;) POP second half and Advance PC.

11

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

SP++; DHPC = *SP; SP--;
PC[L] = *SP, PC[H] = DHPC;
SP++; SP++;

Type | 15 14 | 13 12 | 11 10 9 8 | 7 6 | 5 | 4 3 2 1 0
POP | XX | XX | XXXX | Rd | X | OpCode=0x0f

RTS

69

## Micro-Instructions Control: Test (10010)

Cycle # | Instruction | Explanation
0 | 0001_0010 = 0x12 | Load Rs1 to reg A
1 | 0001_1001 = 0x19 | Load Rs2 to reg B
2 | 0000_0100 = 0x04 | Output ALU value on bus (but don’t save in register)
3 | 1000_0000 = 0x80 | Increment PC
4
5
6
7

12

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

TST Rs1, Rs2

Type | 15 14 13 12 | 11 10 | 9 8 | 7 6 5 4 | 3 2 | 1 0
ALU | OpCode | XX | Rd | Function | Rs1 | Rs2

Type | 15 14 | 13 12 | 11 10 9 8 | 7 6 | 5 | 4 3 2 1 0
ALU | Rs2 | Rs1 | S2 S1 S0 SF (Function sel) | XX | X | OpCode=12

70

## Micro-Instructions Control: Test immediate (10011)

Cycle # | Instruction | Explanation
0 | 10_0000_0001_0010 = 0x2012 | Load Rd to reg A
1 | 0100_0001 = 0x0041 | Load 4 bit imm to reg B
2 | 0000_0100 = 0x0004 | Write ALU output to bus (but not to register)
3 | 1000_0000 = 0x80 | Increment PC
4
5
6
7

13

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

TST Rd, #0x00

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

Type | 15 14 13 12 | 11 10 9 8 | 7 6 | 5 | 4 3 2 1 0
ALU | 4-bit imm. | S2 S1 S0 SF (Function sel) | Rd | X | OpCode=13

71

## Micro-Instructions Control: Load Data Byte with Offset 1 (LDW1) (10100)

Cycle # | Instruction | Explanation
0 | 0x08_00_40 | Write Imm to the Data Bus, ARSrc to the Address Bus, and set TmpAR to read from the 16-bit adder.
1 | 0x10_04_20 | Write TmpAR to the Address Bus, Write Memory data word to the Data Bus, and set Rd to read from the Data Bus.
2 | 0x00_00_80 | Advance PC.

14

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

INSTR[5] | INSTR[0] | ARSrc Address Register | Command Parameter
0 | 0 | PC ({PC[H], PC[L]}) | %PC
1 | 0 | SP | %SP

Rd = *(ARSrc + Imm)

LDW R0, %SP, #4

Type | 15 14 | 13 12 | 11 10 9 8 | 7 6 | 5 | 4 3 2 1 0
LDW | Immediate (8-bit) | | Immediate (8-bit) | Rd | ARSrc[1] | OpCode=14 (and ARSrc[0] = 0)

72

## Micro-Instructions Control: Load Data Byte with Offset 2 (LDW2) (10101)

Cycle # | Instruction | Explanation
0 | 0x08_00_40 | Write Imm to the Data Bus, ARSrc to the Address Bus, and set TmpAR to read from the 16-bit adder.
1 | 0x10_04_20 | Write TmpAR to the Address Bus, Write Memory data word to the Data Bus, and set Rd to read from the Data Bus.
2 | 0x00_00_80 | Advance PC.

15

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

INSTR[5] | INSTR[0] | ARSrc Address Register | Command Parameter
0 | 1 | DP | %DP
1 | 1 | BP | %BP

Rd = *(ARSrc + Imm)

LDW R0, %DP, #4

Type | 15 14 | 13 12 | 11 10 9 8 | 7 6 | 5 | 4 3 2 1 0
LDW | Immediate (8-bit) | | Immediate (8-bit) | Rd | ARSrc[1] | OpCode=15 (and ARSrc[0] = 1)

73

## Micro-Instructions Control: Store Data Byte with Offset 1 (SDW1) (10110)

Cycle # | Instruction | Explanation
0 | 0x08_00_40 | Write Imm to the Data Bus, write ARSrc to the Address Bus, and set TmpAR to read.
1 | 0x10_28_10 | Write TmpAR to the Address Bus, write Rs (Rd) to the Data Bus, and set Memory to read from the Data Bus.
2 | 0x00_00_80 | Advance PC.

16

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

INSTR[5] | INSTR[0] | ARSrc Address Register | Command Parameter
0 | 0 | PC ({PC[H], PC[L]}) | %PC
1 | 0 | SP | %SP

*(ARSrc + Imm) = Rs (Rd as source)

SDW R2, 16(%SP)

Type | 15 14 | 13 12 | 11 10 9 8 | 7 6 | 5 | 4 3 2 1 0
SDW | Immediate (8-bit) | | Immediate (8-bit) | Rs (Rd) | ARSrc[1] | OpCode=16 (and ARSrc[0] = 0)

74

## Micro-Instructions Control: Store Data Byte with Offset 2 (SDW2) (10111)

Cycle # | Instruction | Explanation
0 | 0x08_00_40 | Write Imm to the Data Bus, write ARSrc to the Address Bus, and set TmpAR to read.
1 | 0x10_28_10 | Write TmpAR to the Address Bus, write Rs (Rd) to the Data Bus, and set Memory to read from the Data Bus.
2 | 0x00_00_80 | Advance PC.

17

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

INSTR[5] | INSTR[0] | ARSrc Address Register | Command Parameter
0 | 1 | DP | %DP
1 | 1 | BP | %BP

*(ARSrc + Imm) = Rs (Rd as source)

SDW R0, %BP, #0

Type | 15 14 | 13 12 | 11 10 9 8 | 7 6 | 5 | 4 3 2 1 0
SDW | Immediate (8-bit) | | Immediate (8-bit) | Rs (Rd) | ARSrc[1] | OpCode=17 (and ARSrc[0] = 1)

75

## Micro-Instructions Control: Address with Offset to Address 1 (MAA1) (11000)

Cycle # | Instruction | Explanation
0 | 0x08_00_40 | Write Imm to the Data Bus, ARSrc to the Address Bus, and set TmpAR to read.
1 | 0x10_00_00 | Write TmpAR to the Address Bus.
2 | 0x32_00_00 | Write TmpAR to the Address Bus, Address Bus Low register to the Data Bus, and set ARDest[L] to read from the Data Bus.
3 | 0x66_00_00 | Write Address Bus High Register to the Data Bus and set ARDest[H] to read from the Data Bus.
4 | 0x_00_00_80 | Advance PC.

18

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

ARDest = ARSrc + Imm

MAA %SP, %SP, #-1

INSTR[5] | INSTR[0] | ARSrc Address Register | Command Parameter
0 | 0 | PC ({PC[H], PC[L]}) | %PC
1 | 0 | SP | %SP

Type | 15 14 | 13 12 | 11 10 9 8 | 7 6 | 5 | 4 3 2 1 0
MAA | Immediate (8-bit) | | Immediate (8-bit) | ARDest | ARSrc[1] | OpCode=18 (and ARSrc[0] = 0)

0-PC, 1-DP, 2-SP, 3-BP

76

## Micro-Instructions Control: Address with Offset to Address 2 (MAA2) (11001)

Cycle # | Instruction | Explanation
0 | 0x08_00_40 | Write Imm to the Data Bus, ARSrc to the Address Bus, and set TmpAR to read.
1 | 0x10_00_00 | Write TmpAR to the Address Bus.
2 | 0x32_00_00 | Write TmpAR to the Address Bus, Address Bus Low register to the Data Bus, and set ARDest[L] to read from the Data Bus.
3 | 0x66_00_00 | Write Address Bus High Register to the Data Bus and set ARDest[H] to read from the Data Bus.
4 | 0x_00_00_80 | Advance PC.

19

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

ARDest = ARSrc + Imm

MAA %DP, %BP, #-1

INSTR[5] | INSTR[0] | ARSrc Address Register | Command Parameter
0 | 1 | DP | %DP
1 | 1 | BP | %BP

Type | 15 14 | 13 12 | 11 10 9 8 | 7 6 | 5 | 4 3 2 1 0
MAA | Immediate (8-bit) | | Immediate (8-bit) | ARDest | ARSrc[1] | OpCode=19 (and ARSrc[0] = 1)

0-PC, 1-DP, 2-SP, 3-BP

77

## Micro-Instructions Control: Move Address to General register (MAG) (11010)

Cycle # | Instruction | Explanation
0 | 0x00_00_00 | Write ARSrc to the Address Bus (special behavior due to opcode being MAG).
1 | 0x20_00_20 | Write Address Bus L/H Register to the Data Bus (L or H determined by the (AR) L/H instruction operand) and set Rd to read from the Data Bus.
2 | 0x00_00_80 | Advance PC.

1A

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

Rd = ARSrc[L/H]

MAG R3, %SP, L

Type | 15 14 | 13 12 | 11 10 9 8 | 7 6 | 5 | 4 3 2 1 0
MAG | XXXX | | ARSrc | Rd | (AR) L/H | OpCode=1a

78

## Micro-Instructions Control: Load Address register(LDA) (11011)

Cycle # | Instruction | Explanation
0 | 0x02_00_40 | Write Imm to the Data Bus and set ARDest[L/H] to read from the Data Bus.
1 | 0x00_00_80 | Advance PC.

1B

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

ARDest[L/H] = Imm

LDA %BP[L], #0x05

Type | 15 14 | 13 12 | 11 10 9 8 | 7 6 | 5 | 4 3 2 1 0
LDA | Immediate (8-bit) | | | ARDest | (AR) L/H | OpCode=1b

0-PC, 1-DP, 2-SP, 3-BP

79

## Micro-Instructions Control: Move General to Address register (MGA) (11100)

Cycle # | Instruction | Explanation
0 | 0x02_00_10 | Write Rs1 to the Data Bus and set ARDest[L/H] to read from the Data Bus.
1 | 0x00_00_80 | Advance PC.

1C

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

ARDest[L/H] = Rs1

MGA %SP[L], R2

Type | 15 14 | 13 12 | 11 10 9 8 | 7 6 | 5 | 4 3 2 1 0
MGA | XX | Rs1 | X | ARDest | (AR) L/H | OpCode=1c

80

## (Data Bus → AR) Loading

We must be able to tell an AR to read from the Data Bus, and we must specify which byte (L or H) it should write the Data Bus’ data word into.

Inputs: L/H instruction operand (1 bit), ARDest instruction operand (2 bits), loadAR control signal, PC Load control signal, loadARHorL control signal, opcode

Output: {None (no AR reads), PC[Dummy H], PC[L], SP[H], SP[L], DP[H], DP[L], BP[H], BP[L]}
(Note: Can’t write to the actual PC H, can only write to the PC Dummy H from the data bus! Actual PC H only reads from the Dummy PC High!)

PC Load Branch | loadAR control signal | PC Load control signal | Opcode_MAA (active low) | loadARHorL control signal | L/H instruction operand | Output
Active (1) | X | X | X | X | X | PC[L] (and PC[H] = DHPC)
Inactive (0) | 1 | 1 | X | HorL | X | PC[HorL] (if L, PC[L] = data bus and PC[H] = DHPC)
Inactive (0) | 1 | 0 | MAA | HorL | X | ARDest[HorL]
Inactive (0) | 1 | 0 | Other Opcodes | X | L/H | ARDest[L/H]
Inactive (0) | 0 | X | X | X | X | None

## (Data Bus → AR) Loading (AR Data Bus Load Enable LUT)

The Data Bus → AR Loading combinational logic (explained in previous slide) is implemented as a (8 bit → 8 bit) (256 byte) LUT in an EEPROM.

EEPROM Address Bit | Input
7 | PC Load Branch (ACTIVE LOW)
6 | loadAR (control signal)
5 | PC Load (control signal)
4 | loadARHorL (control signal)
3 | Opcode_MAA (ACTIVE LOW)
2 | (AR) L/H instruction operand
1 | ARDest[1]
0 | ARDest[0]

EEPROM Data Output Bit | Output
7 | BP[H] Load Enable (ACTIVE LOW)
6 | BP[L] Load Enable (ACTIVE LOW)
5 | SP[H] Load Enable (ACTIVE LOW)
4 | SP[L] Load Enable (ACTIVE LOW)
3 | DP[H] Load Enable (ACTIVE LOW)
2 | DP[L] Load Enable (ACTIVE LOW)
1 | DHPC Load Enable (ACTIVE LOW)
0 | PC[L] + PC[H] = DHPC Load Enable (ACTIVE LOW)

## 138 - 3-to-8 Line Decoder

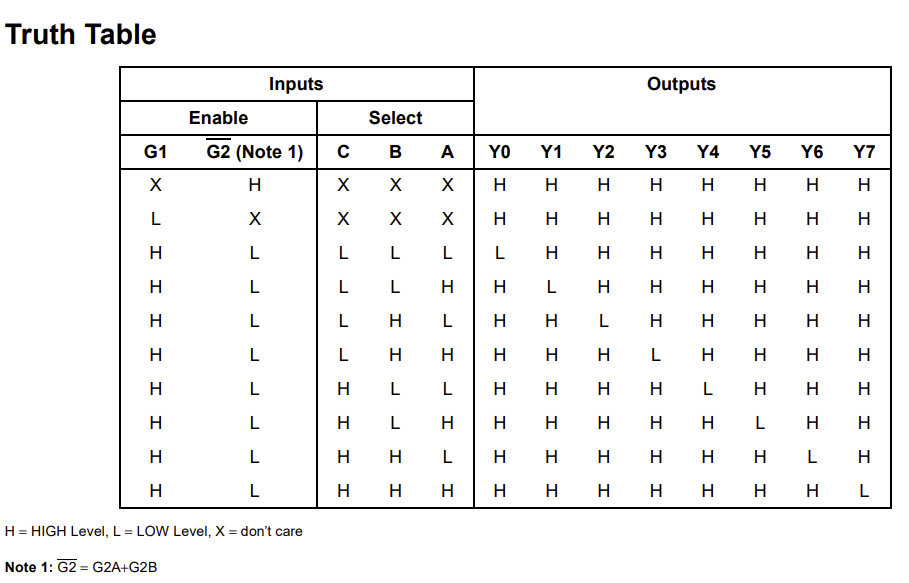
[picture p77: figure]
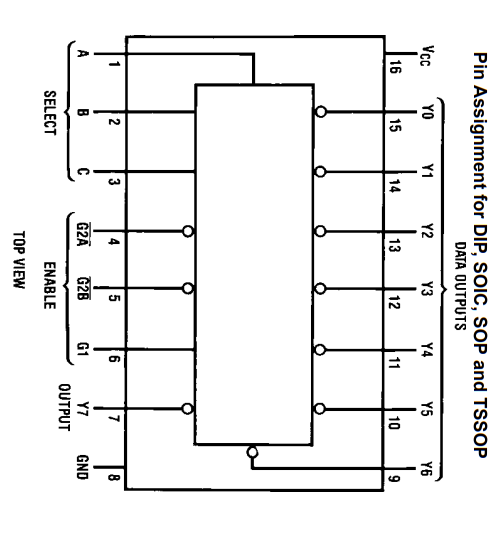
[picture p78: figure]
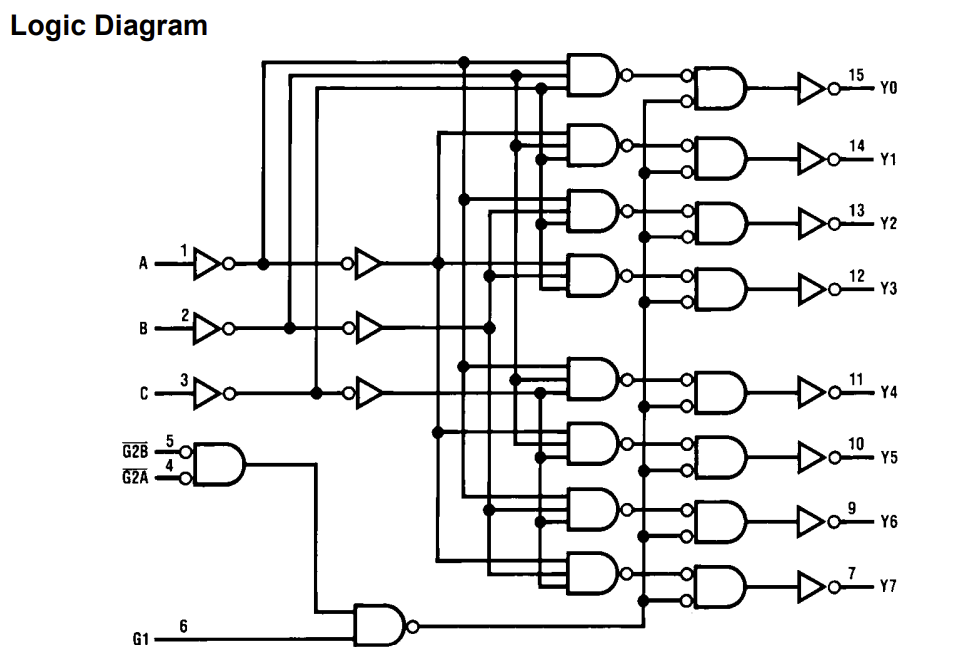
[picture p79: figure]

## 161 - 4-Bit Binary Counter, Asynchronous Reset

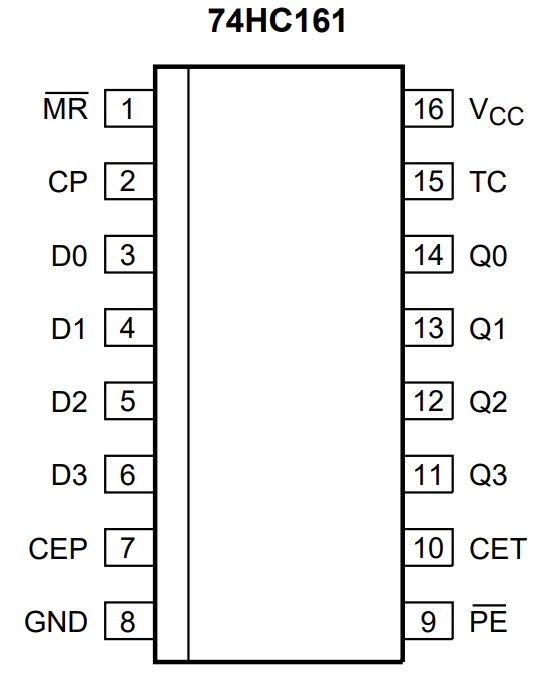
[picture p80: figure]
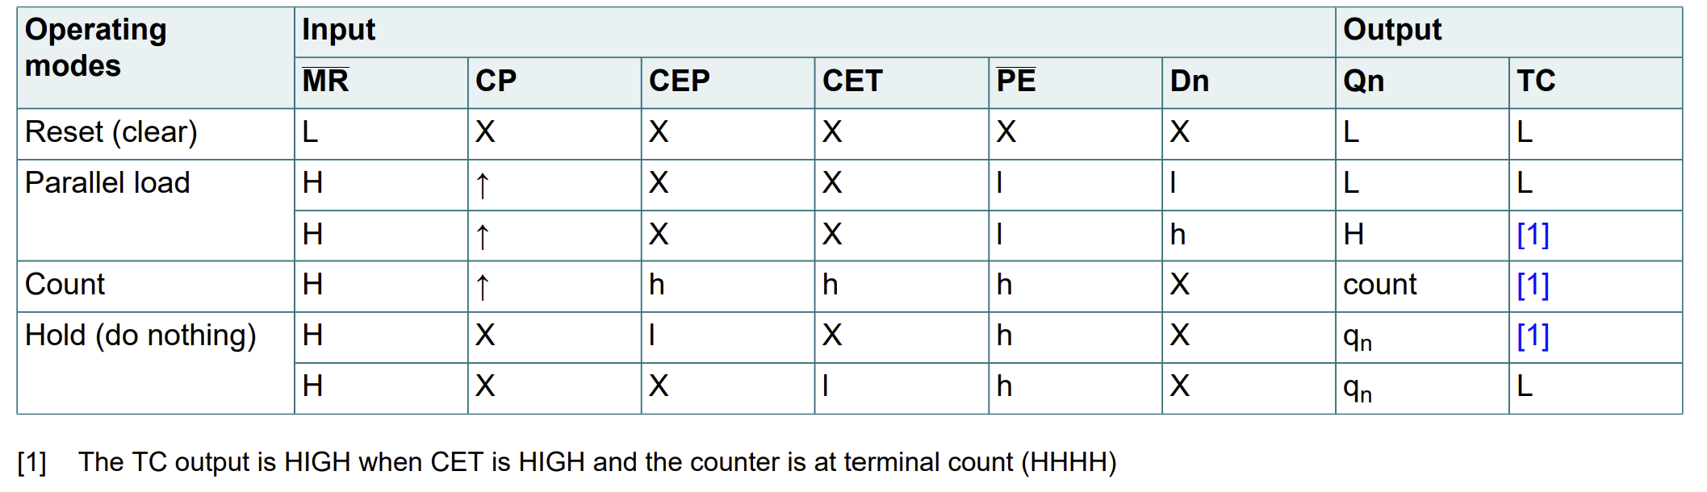
[picture p81: figure]
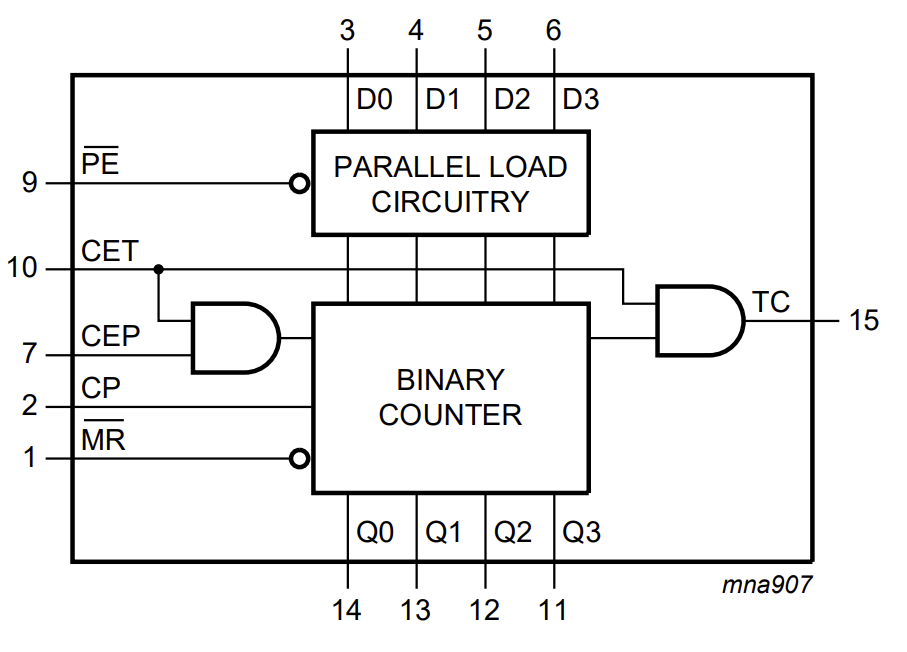
[picture p82: figure]

Notes:
- Parallel Load need to happen on invese clock
- Count need to happen on [TBD – need timing diagram of the PC Advance]

## 175 - Quad D-Type Flip-Flop with Reset

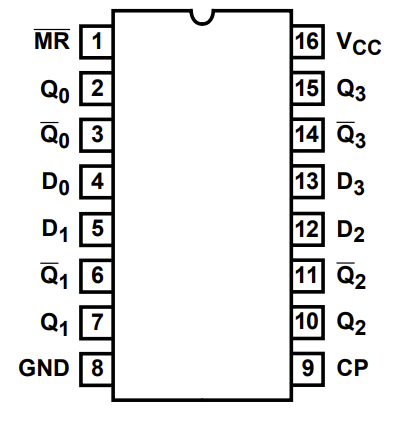
[picture p83: figure]
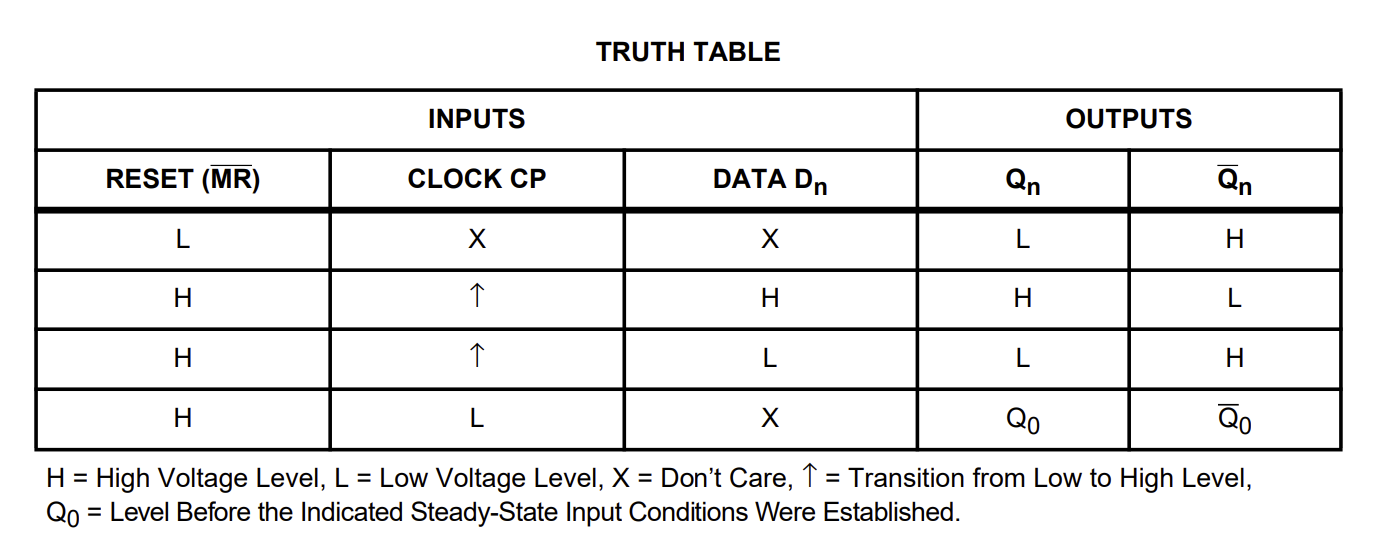
[picture p84: figure]
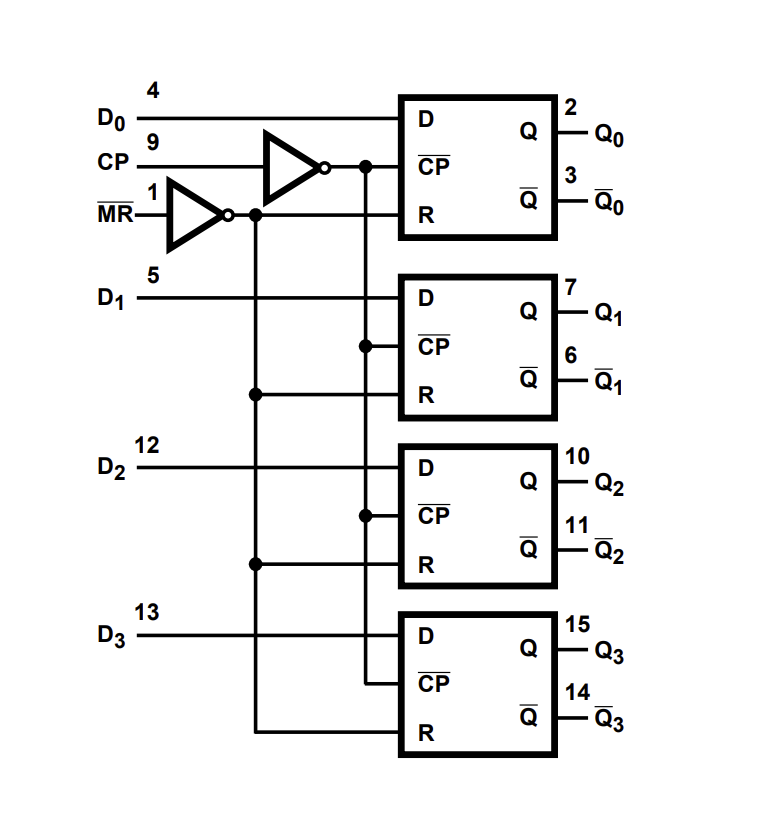
[picture p85: figure]

## 245 - Octal D-Type Flip-Flop with Reset

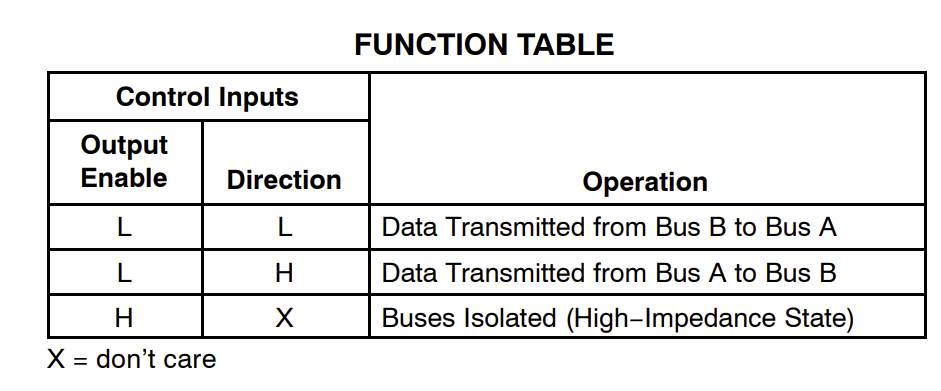
[picture p86: figure]
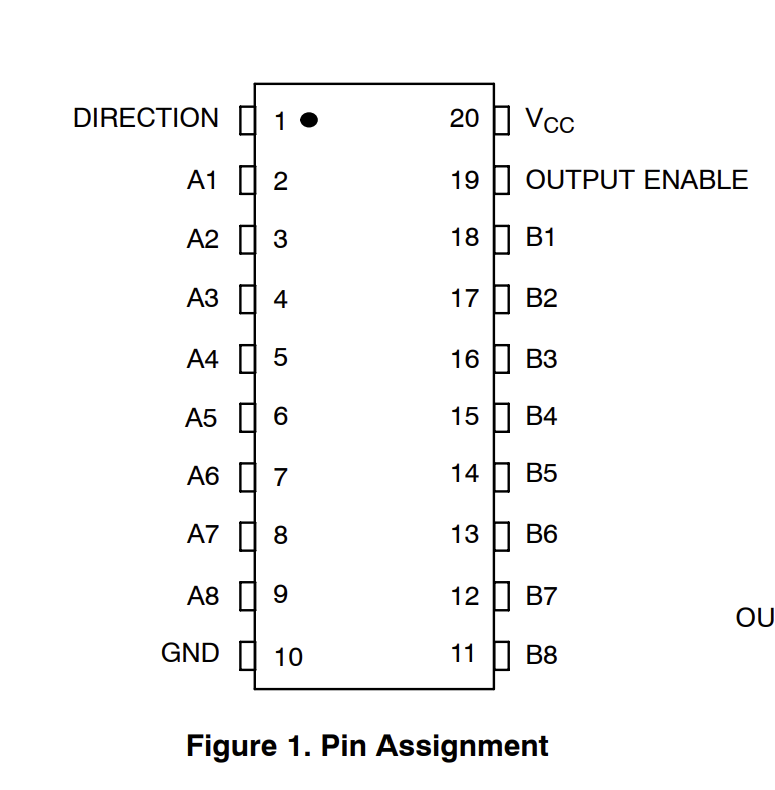
[picture p87: figure]
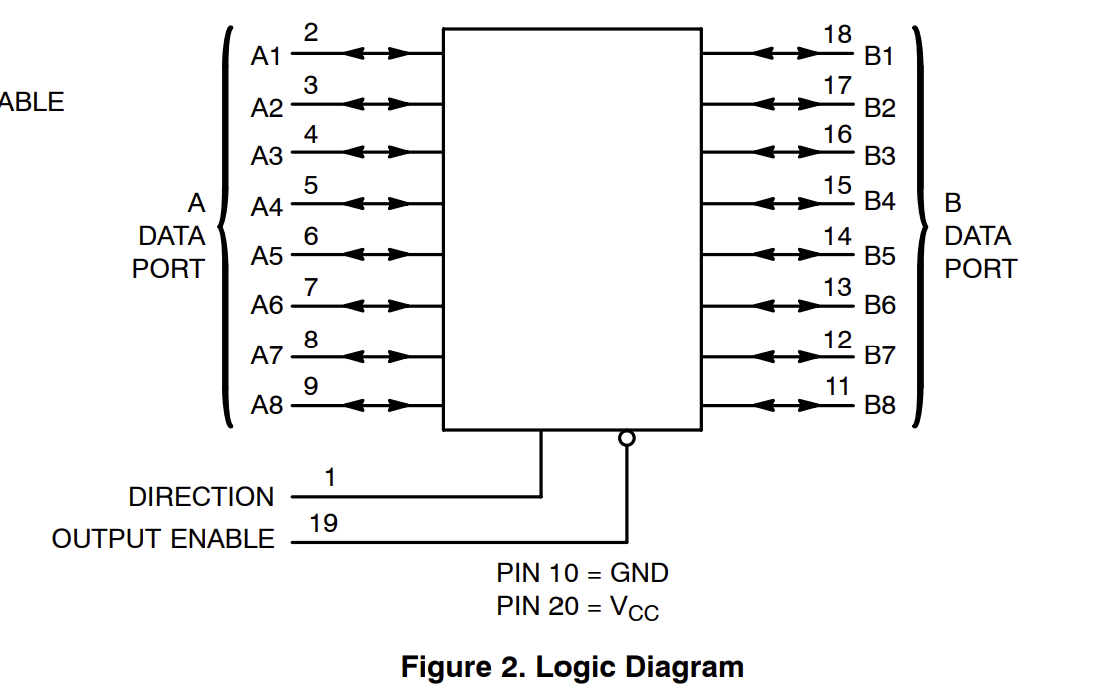
[picture p88: figure]

## 273 - Octal D-Type Flip-Flop with Reset

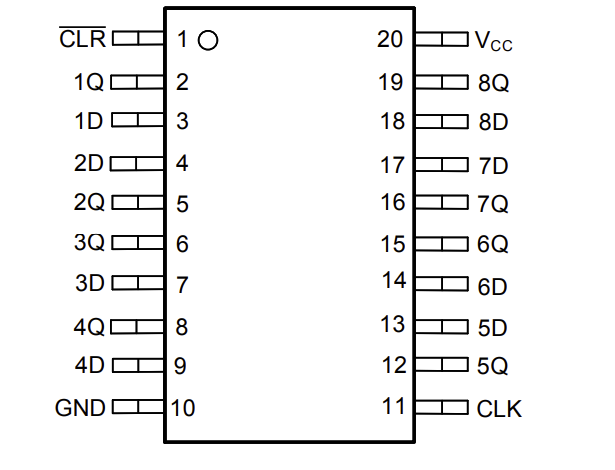
[picture p89: figure]
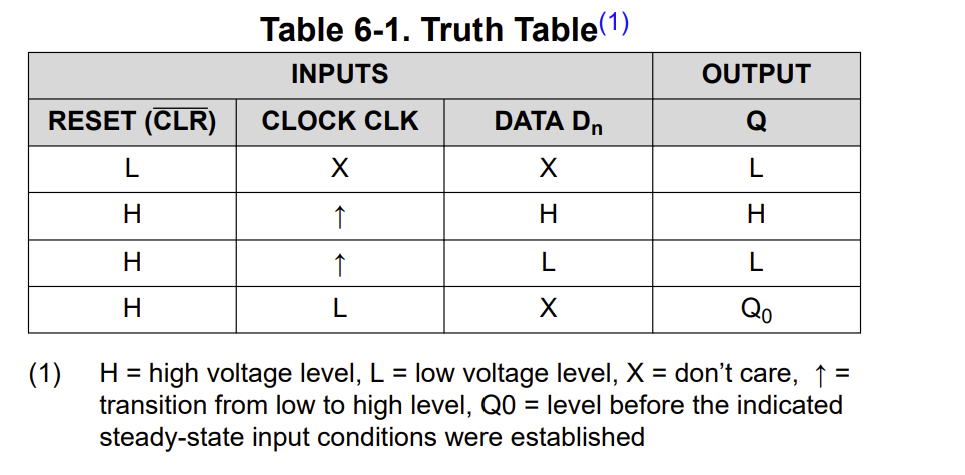
[picture p90: figure]
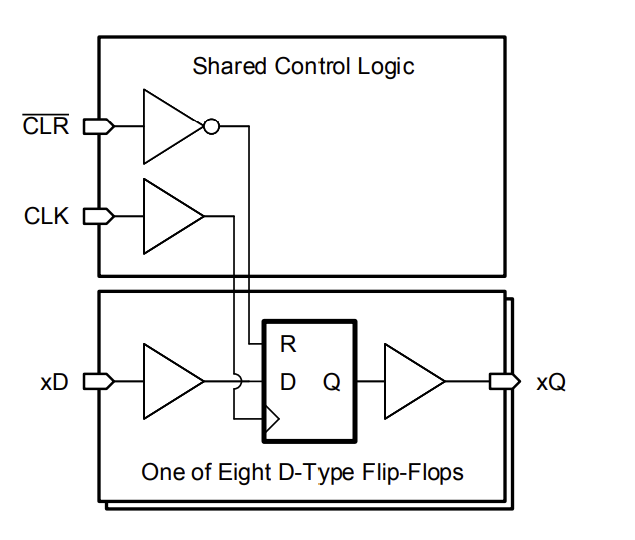
[picture p91: figure]

## 547 - Octal 3−State Noninverting D Flip−Flop

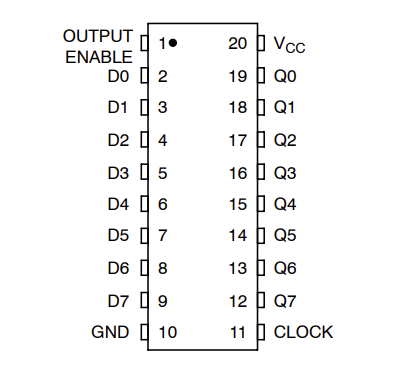
[picture p92: figure]
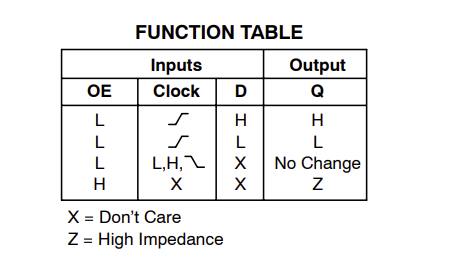
[picture p93: figure]
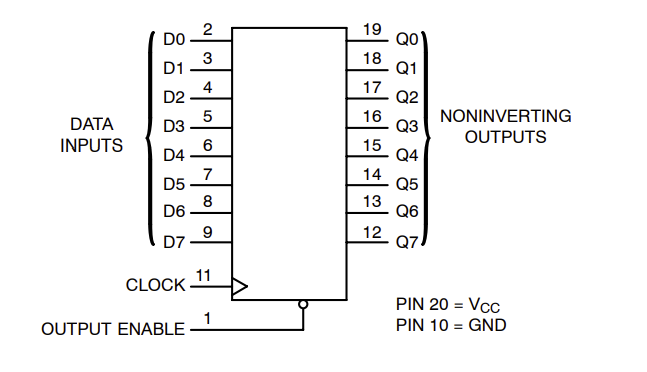
[picture p94: figure]
