gilkeidar/ByteFrost/PCB/Process - Study.docx

# Process Building ByteFrost on PCB

To create a professional Printed Circuit Board (PCB) from a breadboard project, you must transition from a temporary physical prototype to a digital design and, finally, to a fabricated board. [1 (https://www.aivon.com/blog/pcb-manufacturing/from-breadboard-to-pcb-making-your-projects-permanent/), 2 (https://www.youtube.com/watch?v=nFrnlTu5QJI)]

1. Document the Working Circuit [3 (https://hubble.com/community/guides/how-to-transition-from-arduino-to-custom-pcb/)]

Before dismantling anything, document your breadboard setup.

- Take Photos: Capture top-down and angled views to clearly see every wire and component.
- List Components: Create a Bill of Materials (BOM) that includes the physical size of each part to ensure the correct footprints are used later. [5 (https://www.aivon.com/blog/pcb-manufacturing/from-breadboard-to-pcb-making-your-projects-permanent/), 6 (https://forum.arduino.cc/t/from-breadboard-to-pcb-how/973134), 7 (https://www.allpcb.com/allelectrohub/digital-signage-pcb-reverse-engineering-understanding-existing-designs), 8 (https://adaptalux.com/electronic-circuit-board-photography/)]

2. Draw the Electrical Schematic

A schematic is the "blueprint" of your circuit. Use Electronic Design Automation (EDA) software to map the logical connections between components.

- Software Options:
  - KiCad: Free, open-source, and highly recommended for beginners and pros alike.
  - EasyEDA: Web-based and very user-friendly for fast prototyping.
  - Flux.ai: A collaborative tool with AI-assisted routing.
- Assign Footprints: Choose the physical layout for each part, such as through-hole (easier for hand-soldering) or Surface Mount Devices (SMD) for a more compact board. [3 (https://hubble.com/community/guides/how-to-transition-from-arduino-to-custom-pcb/), 13 (https://www.youtube.com/shorts/ufUB1CZ1i50), 14 (https://www.reddit.com/r/AskElectronics/comments/7tku6p/how_to_transfer_from_breadboard_to_circuit_board/), 15 (https://medium.com/@pcbsync/how-i-went-from-arduino-breadboards-to-custom-pcbs-in-3-months-f72e82460411), 16 (https://www.youtube.com/shorts/ufUB1CZ1i50), 17 (https://www.kicad.org/), 18 (https://versae.com/the-best-pcb-design-software-for-printed-circuit-board-designing/), 19 (https://www.protoexpress.com/kb/pcb-design-software-overview/)]

3. Design the PCB Layout

Once the schematic is finished, the software transfers it to a physical board layout.

- Place Components: Arrange parts logically. Place power sections together and minimize the length of signal paths.
- Route Traces: Draw the copper paths (traces) connecting the pins. Avoid sharp 90-degree angles and ensure traces are wide enough for the current they carry (typically 0.5mm for signals).
- Run a Design Rule Check (DRC): Use the software's built-in tool to verify there are no short circuits or overlapping traces. [1 (https://www.aivon.com/blog/pcb-manufacturing/from-breadboard-to-pcb-making-your-projects-permanent/), 4 (https://www.aivon.com/blog/pcb-manufacturing/from-breadboard-to-pcb-making-your-projects-permanent/), 5 (https://www.aivon.com/blog/pcb-manufacturing/from-breadboard-to-pcb-making-your-projects-permanent/), 20 (https://www.allpcb.com/allelectrohub/building-a-simple-pcb-prototype-on-a-breadboard-a-cost-effective-starting-point), 21 (https://www.amazon.com/Practical-PCB-Design-Michael-Smith-ebook/dp/B0DQP4ZJVT)]

4. Fabricate the Board [22 (https://www.pcbpower.us/blog/pcb-manufacturing-process-prototyping-to-production)]

After finalizing the design, you need to turn the digital file into a physical board.

- Export Gerber Files: Generate these standard manufacturing files and compress them into a .zip folder.
- Order from a Manufacturer: Upload your Gerbers to a service like PCBWay or JLCPCB. They will fabricate and ship the boards to you, often within a week.
- DIY Alternative: For simple boards, you can use the toner transfer method to etch the copper at home using chemicals. [1 (https://www.aivon.com/blog/pcb-manufacturing/from-breadboard-to-pcb-making-your-projects-permanent/), 5 (https://www.aivon.com/blog/pcb-manufacturing/from-breadboard-to-pcb-making-your-projects-permanent/), 9 (https://www.youtube.com/shorts/vFAx4VsygzY), 10 (https://www.youtube.com/watch?v=TJPyqRnhytA), 23 (https://www.youtube.com/watch?v=nFrnlTu5QJI), 24 (https://www.facebook.com/groups/electronichobbycircuits/posts/9320050414686251/)]

5. Assembly

When the boards arrive, solder your components onto the new PCB. Start with the lowest-profile components (resistors, diodes) and work your way up to larger parts like capacitors and headers. [2 (https://www.youtube.com/watch?v=nFrnlTu5QJI), 9 (https://www.youtube.com/shorts/vFAx4VsygzY), 23 (https://www.youtube.com/watch?v=nFrnlTu5QJI), 25 (https://www.ourpcb.com/pcb-kit.html), 26 (https://vectorbluehub.com/a-guide-to-printed-circuit-board-assembly-pcba)]

AI responses may include mistakes.

[1] https://www.aivon.com/blog/pcb-manufacturing/from-breadboard-to-pcb-making-your-projects-permanent/

[2] https://www.youtube.com/watch?v=nFrnlTu5QJI

[3] https://hubble.com/community/guides/how-to-transition-from-arduino-to-custom-pcb/

[4] https://www.aivon.com/blog/pcb-manufacturing/from-breadboard-to-pcb-making-your-projects-permanent/

[5] https://www.aivon.com/blog/pcb-manufacturing/from-breadboard-to-pcb-making-your-projects-permanent/

[6] https://forum.arduino.cc/t/from-breadboard-to-pcb-how/973134

[7] https://www.allpcb.com/allelectrohub/digital-signage-pcb-reverse-engineering-understanding-existing-designs

[8] https://adaptalux.com/electronic-circuit-board-photography/

[9] https://www.youtube.com/shorts/vFAx4VsygzY

[10] https://www.youtube.com/watch?v=TJPyqRnhytA

[11] https://www.pcbinq.com/pcb_assembly_applica/how-to-go-from-breadboard-to-circuit-board/

[12] https://qual-pro.com/9-expert-steps-to-build-your-own-custom-pcb-today/

[13] https://www.youtube.com/shorts/ufUB1CZ1i50

[14] https://www.reddit.com/r/AskElectronics/comments/7tku6p/how_to_transfer_from_breadboard_to_circuit_board/

[15] https://medium.com/@pcbsync/how-i-went-from-arduino-breadboards-to-custom-pcbs-in-3-months-f72e82460411

[16] https://www.youtube.com/shorts/ufUB1CZ1i50

[17] https://www.kicad.org/

[18] https://versae.com/the-best-pcb-design-software-for-printed-circuit-board-designing/

[19] https://www.protoexpress.com/kb/pcb-design-software-overview/

[20] https://www.allpcb.com/allelectrohub/building-a-simple-pcb-prototype-on-a-breadboard-a-cost-effective-starting-point

[21] https://www.amazon.com/Practical-PCB-Design-Michael-Smith-ebook/dp/B0DQP4ZJVT

[22] https://www.pcbpower.us/blog/pcb-manufacturing-process-prototyping-to-production

[23] https://www.youtube.com/watch?v=nFrnlTu5QJI

[24] https://www.facebook.com/groups/electronichobbycircuits/posts/9320050414686251/

[25] https://www.ourpcb.com/pcb-kit.html

[26] https://vectorbluehub.com/a-guide-to-printed-circuit-board-assembly-pcba
