gilkeidar/ByteFrost/Documentation/Dev Log/AddressingModesSchematics/AR Data Bus Load Enable Schematic.png

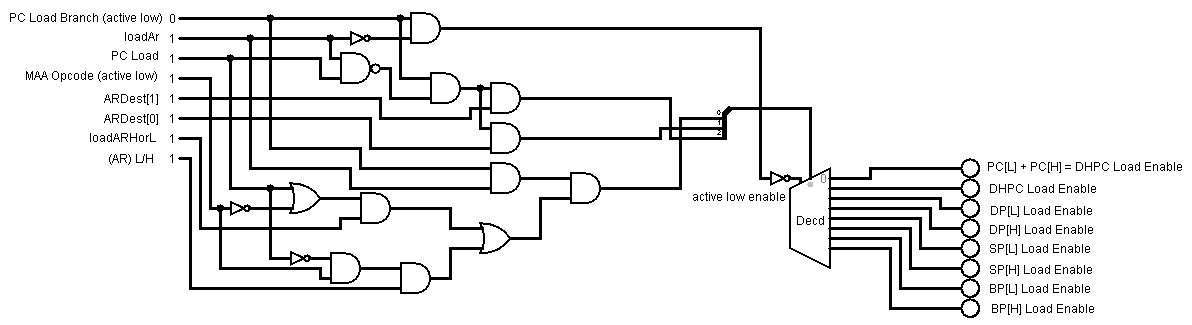
Documentation/Dev Log/AddressingModesSchematics/AR Data Bus Load Enable Schematic.png
