gilkeidar/ByteFrost/Documentation/Dev Log/AddressingModesSchematics/ARSelect Address Bits Schematic.png

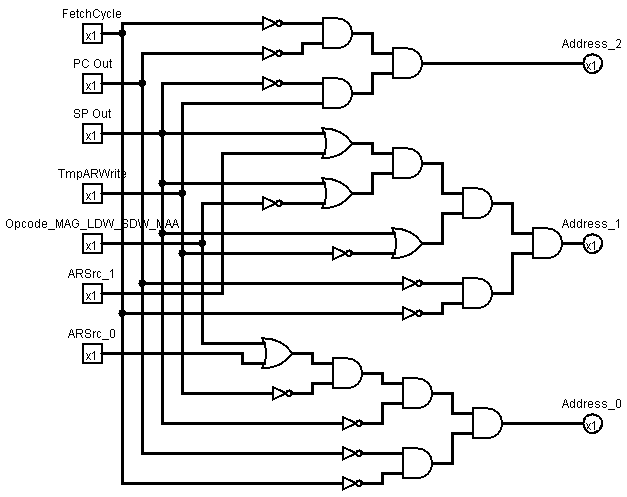
Documentation/Dev Log/AddressingModesSchematics/ARSelect Address Bits Schematic.png
