gilkeidar/ByteFrost/Documentation/Dev Log/AddressingModesSchematics/ARSelect Schematic v2.png

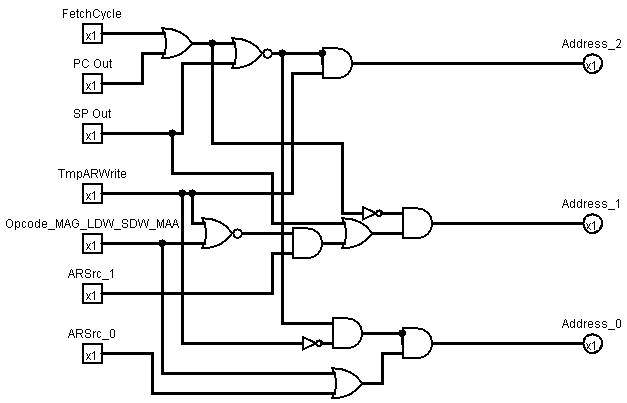
Documentation/Dev Log/AddressingModesSchematics/ARSelect Schematic v2.png
