gilkeidar/ByteFrost/(list of files, cad)

Other CAD files:
Assembler/assemblerv2.obj
