gilkeidar/ByteFrost/Documentation/Dev Log/november_26_2025_assembler_updates.md

#   ByteFrost Development Log - Assembler Updates

November 26, 2025

##  Overview

To support the new ISA instructions (such as `LDW`, `SDW`, etc.), the ByteFrost
Assembler will need to be updated.

(**This development log is unfinished and may be replaced by a future log.**)
