gilkeidar/ByteFrost/Assembler v2/Design/assembler_design_graphics.pptx

Command-line Arguments

int argc, char ** argv

ByteFrost Assembler

.mlg, .bin

Assembled output file

## Slide 2

int argc, char ** argv

Command-Line Argument Parser (CLAP)

CommandLineArguments

Command-line Arguments

Stage 0

Stage 1

Parser

std::vector<Line *> lines

Stage 2

Preprocessor

Stage 3

Label Handler

Output File Generation

Stage 4

Assembled output file

.mlg, .bin

## Slide 3

int argc, char ** argv

Command-Line Argument Parser (CLAP)

Command-line Arguments

Assembler

Config

(reference) (R/W)

(reference) (R/W)

(reference) (R)

(reference) (R)

Stage 0

Parser

Stage 1

std::vector<Line *> lines

Preprocessor

Stage 2

Label Handler

Output File Generation

Stage 3

(reference) (R)

Stage 4

Assembled output file

.mlg, .bin
