gilkeidar/ByteFrost/Assembler v2/Design/proposed_changes/new_assembler_pipeline.png

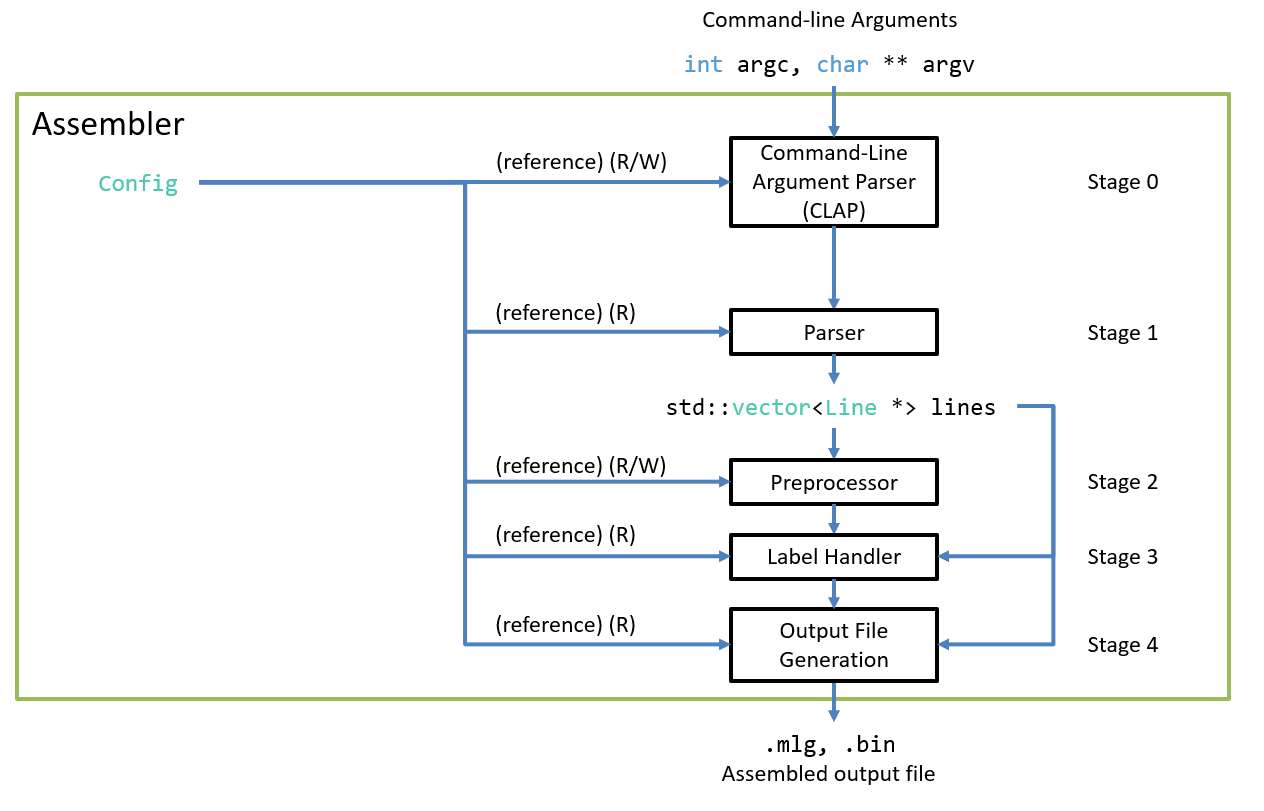
Assembler v2/Design/proposed_changes/new_assembler_pipeline.png
