gilkeidar/ByteFrost/(threads)

Thread 2 (2024-11-09):

Standardize General Register, Special Register, and Memory Access Instructions

ron-keidar, 2024-11-09:
**Problem Description:** Standardize ISA instructions that deal with reading / writing data from / to General Registers (`R0` - `R3`), Special Registers (16-bit PC, DP, SP, BP), and memory.

E.g., currently, one cannot set the value of an SR with a GR value (only an immediate).

Thread 3 (2024-11-21):

Add character values to Assembler v2

gilkeidar, 2024-11-21:
**Problem Description:** Add character values to assembler (which are translated to their corresponding immediate values).

**Example:** Currently, to print a character to the display, one must know its exact character set value; for instance:
```asm
OUT #0x41, A    //    Print 'A' to the screen
```

This can be partially mended using Preprocessor constants:
```asm
.define 1 _A    0x41
OUT _A, A    //    Print 'A' to the screen
```

However, this requires one to define many constants if one wants to write arbitrary characters; instead, this should be a built-in feature of the Assembler, like so:
```asm
OUT 'A', A    //    Print 'A' to the screen
```

This should cover the entire character set of the ByteFrost display.

Thread 4 (2024-11-21):

Complete first version of the ByteFrost Assembler Handbook

gilkeidar, 2024-11-21:
**Problem Description:** Finish the effort to produce two reference volumes that comprise the *ByteFrost Assembler Handbook*.

The two volumes are: A *Developer Reference* volume (containing software structure information) and a *Programmer Manual* (containing reference information useful for a ByteFrost Assembly programmer, both in using the Assembler and in writing ByteFrost Assembly code).

The first version of this handbook should completely and correctly document the current version of the ByteFrost Assembler v2. The handbooks should be labeled with semantic versions and maintain an update log in a start section (potentially immediately before the table of contents). New features of the Assembler should be documented in the source code and in the handbooks where applicable, and the fact that the handbooks were updated should be stated in the handbook update logs.

Thread 5 (2025-01-14):

Ensure the new Assembler has the full set of ISA and Assembly Instructions

gilkeidar, 2025-01-14:
**Task Description**: Review the ISA and Assembly Instructions lists in the Assembler v2 implementation and add any missing instructions.

Thread 7 (2025-01-21):

[Program Request] - Create an `ls -ls` program.

gilkeidar, 2025-01-21:
**Task Description:** Create a more powerful `ls` program that doesn't only print the files in the ByteFrost disk but also their inode attributes.

I.e., instead of

```bash
$ ls
file1 file2 file3
$
```

do

```bash
$ ls -ls
total [num data blocks used]
[num data blocks used by first file] [file type] [size in bytes] [file name]
...
4 ASM 1000 my_program
...
$
```
