gilkeidar/ByteFrost/PCB/KiCAD/ByteFrost/ByteFrost.kicad_pcb

## KiCad design PCB/KiCAD/ByteFrost/ByteFrost.kicad_pcb (2026-05-29)

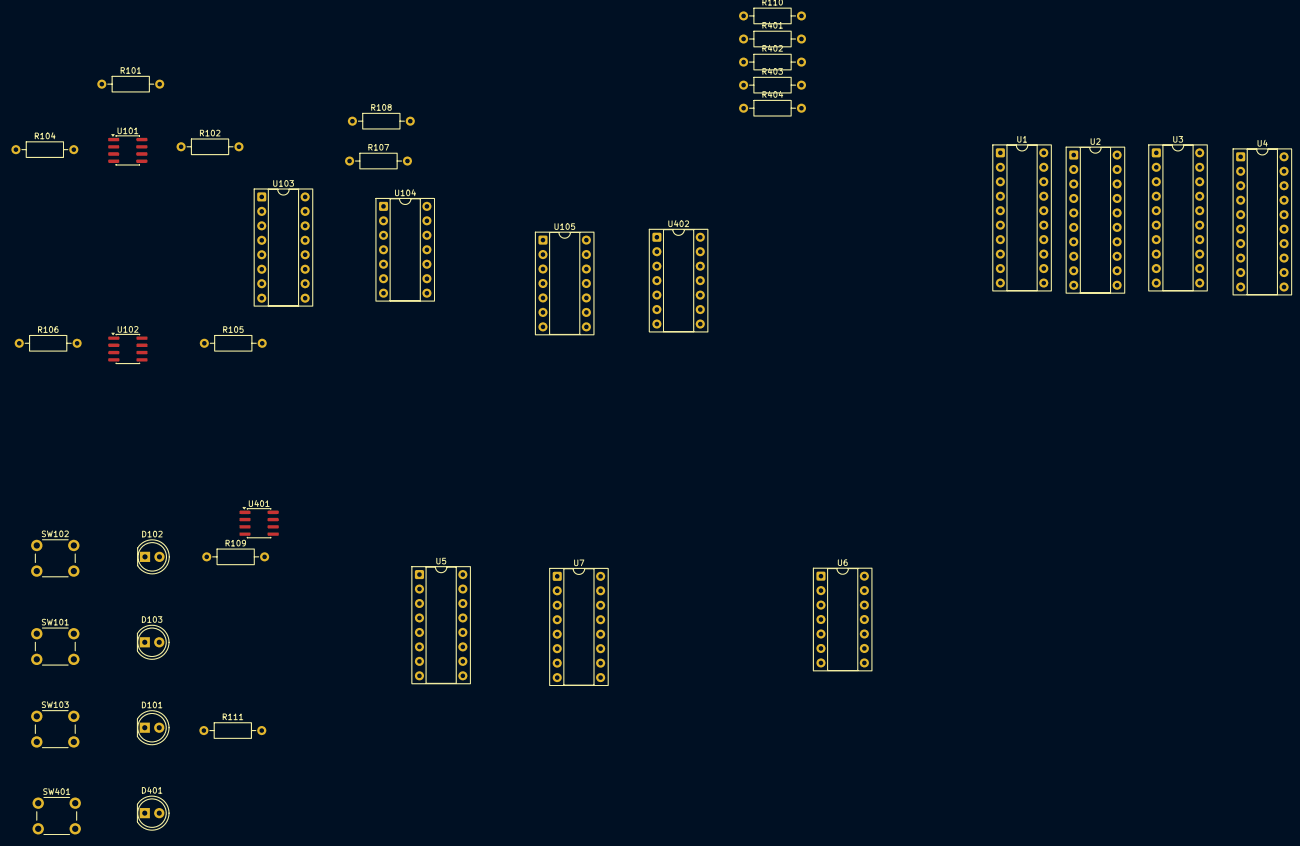
[picture p131: board ByteFrost.kicad_pcb from above]

Board: 2 copper layers, 36 parts (0 on the bottom side), 50 nets, no tracks yet.

Parts:
D101: LED (green); LED_D5.0mm
D102, D401: LED (red); LED_D5.0mm
D103: LED (blue); LED_D5.0mm
R101, R107, R108: 10K; R_Axial_DIN0207_L6.3mm_D2.5mm_P10.16mm_Horizontal
R102: 100; R_Axial_DIN0207_L6.3mm_D2.5mm_P10.16mm_Horizontal
R104: 212K; R_Axial_DIN0207_L6.3mm_D2.5mm_P10.16mm_Horizontal
R105: 20K; R_Axial_DIN0207_L6.3mm_D2.5mm_P10.16mm_Horizontal
R106, R109, R110, R111, R401, R404: 5.1K; R_Axial_DIN0207_L6.3mm_D2.5mm_P10.16mm_Horizontal
R402: 17K; R_Axial_DIN0207_L6.3mm_D2.5mm_P10.16mm_Horizontal
R403: 51K; R_Axial_DIN0207_L6.3mm_D2.5mm_P10.16mm_Horizontal
SW101: Single_Step; SW_PUSH_6mm_H7.3mm
SW102: Break; SW_PUSH_6mm_H7.3mm
SW103: Cont.; SW_PUSH_6mm_H7.3mm
SW401: Reset; SW_PUSH_6mm_H7.3mm
U1, U2, U3, U4: 74HC374; DIP-20_W7.62mm_Socket
U5: 74HC139; DIP-16_W7.62mm_Socket
U6: 74HC02; DIP-14_W7.62mm_Socket
U7: 74HC153; DIP-16_W7.62mm_Socket
U101, U102, U401: ICM7555xB; SOIC-8_3.9x4.9mm_P1.27mm
U103: 74HC76; DIP-16_W7.62mm_Socket
U104: 74HC32; DIP-14_W7.62mm_Socket
U105: 74HC00; DIP-14_W7.62mm_Socket
U402: 74HC14; DIP-14_W7.62mm_Socket

Connections:
2sec_Reset: U103.2 (~S), U105.6, U105.9
+5V: R104.1, R105.1, R106.1, R401.1, R402.1, R403.1, SW102.1, SW103.1, U1.20 (VCC), U2.20 (VCC), U3.20 (VCC), U4.20 (VCC), U5.16 (VCC), U6.14 (VCC), U7.16 (VCC), U101.4 (~RST), U101.8 (VCC), U102.4 (~RST), U102.8 (VCC), U103.5 (VCC), U104.14 (VCC), U105.14 (VCC), U401.4 (~RST), U401.8 (VCC), U402.14 (VCC)
CLK: D103.2 (A), U6.3, U6.6, U6.9, U6.12, U105.8
DATA0: U1.2 (O0), U1.3 (D0), U2.2 (O0), U2.3 (D0), U3.2 (O0), U3.3 (D0), U4.2 (O0), U4.3 (D0)
DATA1: U1.4 (D1), U1.5 (O1), U2.4 (D1), U2.5 (O1), U3.4 (D1), U3.5 (O1), U4.4 (D1), U4.5 (O1)
DATA2: U1.6 (O2), U1.7 (D2), U2.6 (O2), U2.7 (D2), U3.6 (O2), U3.7 (D2), U4.6 (O2), U4.7 (D2)
DATA3: U1.8 (D3), U1.9 (O3), U2.8 (D3), U2.9 (O3), U3.8 (D3), U3.9 (O3), U4.8 (D3), U4.9 (O3)
DATA4: U1.12 (O4), U1.13 (D4), U2.12 (O4), U2.13 (D4), U3.12 (O4), U3.13 (D4), U4.12 (O4), U4.13 (D4)
DATA5: U1.14 (D5), U1.15 (O5), U2.14 (D5), U2.15 (O5), U3.14 (D5), U3.15 (O5), U4.14 (D5), U4.15 (O5)
DATA6: U1.16 (O6), U1.17 (D6), U2.16 (O6), U2.17 (D6), U3.16 (O6), U3.17 (D6), U4.16 (O6), U4.17 (D6)
DATA7: U1.18 (D7), U1.19 (O7), U2.18 (D7), U2.19 (O7), U3.18 (D7), U3.19 (O7), U4.18 (D7), U4.19 (O7)
GND: R101.2, R107.2, R108.2, R109.2, R110.2, R111.2, R404.2, SW101.1, SW401.1, U1.10 (GND), U2.10 (GND), U3.10 (GND), U4.10 (GND), U5.8 (GND), U6.7 (GND), U7.1 (Ea), U7.8 (GND), U7.15 (Eb), U101.1 (GND), U102.1 (GND), U103.13 (GND), U104.7 (GND), U105.7 (GND), U401.1 (GND), U402.7 (GND)
INSTR6: U5.14 (A0), U7.3 (I3a), U7.4 (I2a)
INSTR7: U5.13 (A1), U7.12 (I2b), U7.13 (I3b)
unnamed: R403.2, U402.1
unnamed: D101.2 (A), U103.15 (Q), U104.1
unnamed: D101.1 (K), R111.1
unnamed: D102.2 (A), U103.14 (~Q), U104.4
unnamed: D102.1 (K), R109.1
unnamed: D103.1 (K), R110.1
unnamed: D401.2 (A), U105.4, U105.5, U401.3 (OUT)
unnamed: D401.1 (K), R404.1
unnamed: U1.11 (Cp), U6.1
unnamed: U1.1 (OE), U5.4 (O0)
unnamed: U2.11 (Cp), U6.4
unnamed: U2.1 (OE), U5.5 (O1)
unnamed: U3.11 (Cp), U6.10
unnamed: U3.1 (OE), U5.6 (O2)
unnamed: U4.11 (Cp), U6.13
unnamed: U4.1 (OE), U5.7 (O3)
unnamed: U5.12 (O0), U6.2
unnamed: U5.11 (O1), U6.5
unnamed: U5.10 (O2), U6.8
unnamed: U5.9 (O3), U6.11
unnamed: R101.1, U101.5 (CONT)
unnamed: R102.2, U101.3 (OUT), U103.1 (C), U104.5
unnamed: R104.2, U101.2 (TRIG), U101.6 (THRES)
unnamed: R105.2, U102.6 (THRES), U102.7 (DISCH)
unnamed: U102.3 (OUT), U104.2
unnamed: R106.2, SW101.2, U102.2 (TRIG)
unnamed: R107.1, SW103.2, U103.4 (J)
unnamed: R108.1, SW102.2, U103.16 (K)
unnamed: U104.3, U105.2
unnamed: U104.6, U105.1
unnamed: U105.3, U105.10
unnamed: R402.2, U401.6 (THRES), U401.7 (DISCH)
unnamed: R401.2, SW401.2, U401.2 (TRIG)
unnamed: U402.2, U402.3
R.O_Select_High: U5.3 (A1), U7.9 (Zb)
R.O_Select_Low: U5.2 (A0), U7.7 (Za)
