gilkeidar/ByteFrost/Assembler v2/ByteFrostAssembler/ByteFrostAssembler/include/assembly_instructions.hpp

#pragma once
#include <string>
#include <vector>
//#include "parser.hpp"
#include "shared_types.hpp"
#include "isa.hpp"

/**
 * @brief Given a Token t, returns its integer value as it would be represented
 * in an instruction string.
 * @note Only works for Tokens whose TokenType is such that they can be
 * stored in an instruction string. E.g., TEXT, LABEL, and DIRECTIVE tokens
 * cannot be converted to an integer value.
 * @param t Token whose value to convert to an integer as it would be represented
 * in an instruction string.
 * @return integer value of Token t's string value as it would be represented
 * in an instruction string.
 */
int getTokenIntValue(Token t);

enum class ArgumentSource {Token, Constant, TokenLabelHigh, TokenLabelLow,
	CurrentAddressHighOffset};

struct AssemblyArgument {
	ArgumentSource source;
	Argument argument;
};

struct AssemblyInstruction {
	std::string name;
	std::vector<TokenType> expected_param_types;
	std::vector<const ISAInstruction*> instruction_sequence;
	std::vector<std::vector<AssemblyArgument>> instruction_sequence_arguments;
	
	std::vector<uint16_t> generateCode(InstructionLine& line, Config & config);
};


const AssemblyInstruction assembly_instructions[] = {
	{	//	NOP	
		"NOP",
		{},
		{&isa[NOP_OPCODE]},
		{{}}
	},
	{	//	BRK
		"BRK",
		{},
		{&isa[BRK_OPCODE]},
		{{}}
	},
	{	//	OR Rd, Rs1, Rs2
		"OR",
		{TokenType::GREGISTER, TokenType::GREGISTER, TokenType::GREGISTER},
		{&isa[ALU_OPCODE]},
		{
			{
				{
					ArgumentSource::Constant,
					{ArgumentType::Func, ALU_FUNC_SIZE, OR_FUNC_BITS}
				},
				{
					ArgumentSource::Token,
					{ArgumentType::Rd, GREGISTER_SIZE, FIRST_TOKEN}
				},
				{
					ArgumentSource::Token,
					{ArgumentType::Rs1, GREGISTER_SIZE, SECOND_TOKEN}
				},
				{
					ArgumentSource::Token,
					{ArgumentType::Rs2, GREGISTER_SIZE, THIRD_TOKEN}
				},
			}
		}
	},
	{	//	AND Rd, Rs1, Rs2
		"AND",
		{TokenType::GREGISTER, TokenType::GREGISTER, TokenType::GREGISTER},
		{&isa[ALU_OPCODE]},
		{
			{
				{
					ArgumentSource::Constant,
					{ArgumentType::Func, ALU_FUNC_SIZE, AND_FUNC_BITS}
				},
				{
					ArgumentSource::Token,
					{ArgumentType::Rd, GREGISTER_SIZE, FIRST_TOKEN}
				},
				{
					ArgumentSource::Token,
					{ArgumentType::Rs1, GREGISTER_SIZE, SECOND_TOKEN}
				},
				{
					ArgumentSource::Token,
					{ArgumentType::Rs2, GREGISTER_SIZE, THIRD_TOKEN}
				},
			}
		}
	},
	{	//	XOR Rd, Rs1, Rs2
		"XOR",
		{TokenType::GREGISTER, TokenType::GREGISTER, TokenType::GREGISTER},
		{&isa[ALU_OPCODE]},
		{
			{
				{
					ArgumentSource::Constant,
					{ArgumentType::Func, ALU_FUNC_SIZE, XOR_FUNC_BITS}
				},
				{
					ArgumentSource::Token,
					{ArgumentType::Rd, GREGISTER_SIZE, FIRST_TOKEN}
				},
				{
					ArgumentSource::Token,
					{ArgumentType::Rs1, GREGISTER_SIZE, SECOND_TOKEN}
				},
				{
					ArgumentSource::Token,
					{ArgumentType::Rs2, GREGISTER_SIZE, THIRD_TOKEN}
				},
			}
		}
	},
	{	//	NOT Rd, Rs2	(Rs2 since NOT is implemented as ~B, and Rs2 is loaded
		//	into ALU register B)
		"NOT",
		{TokenType::GREGISTER, TokenType::GREGISTER},
		{&isa[ALU_OPCODE]},
		{
			{
				{
					ArgumentSource::Constant,
					{ArgumentType::Func, ALU_FUNC_SIZE, NOT_FUNC_BITS}
				},
				{
					ArgumentSource::Token,
					{ArgumentType::Rd, GREGISTER_SIZE, FIRST_TOKEN}
				},
				{	//	Rs1 is not used but must be set.
					ArgumentSource::Constant,
					{ArgumentType::Rs1, GREGISTER_SIZE, 0}
				},
				{
					ArgumentSource::Token,
					{ArgumentType::Rs2, GREGISTER_SIZE, SECOND_TOKEN}
				},
			}
		}
	},
	{	//	ADD Rd, Rs1, Rs2
		"ADD",
		{TokenType::GREGISTER, TokenType::GREGISTER, TokenType::GREGISTER},
		{&isa[ALU_OPCODE]},
		{
			{
				{
					ArgumentSource::Constant,
					{ArgumentType::Func, ALU_FUNC_SIZE, ADD_FUNC_BITS}
				},
				{
					ArgumentSource::Token,
					{ArgumentType::Rd, GREGISTER_SIZE, FIRST_TOKEN}
				},
				{
					ArgumentSource::Token,
					{ArgumentType::Rs1, GREGISTER_SIZE, SECOND_TOKEN}
				},
				{
					ArgumentSource::Token,
					{ArgumentType::Rs2, GREGISTER_SIZE, THIRD_TOKEN}
				},
			}
		}
	},
	{	//	SUB Rd, Rs1, Rs2	(Rd = Rs1 - Rs2 since this does A - B)
		"SUB",
		{TokenType::GREGISTER, TokenType::GREGISTER, TokenType::GREGISTER},
		{&isa[ALU_OPCODE]},
		{
			{
				{
					ArgumentSource::Constant,
					{ArgumentType::Func, ALU_FUNC_SIZE, SUB_FUNC_BITS}
				},
				{
					ArgumentSource::Token,
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
					{ArgumentType::Rd, GREGISTER_SIZE, FIRST_TOKEN}
				},
				{
					ArgumentSource::Constant,
					{ArgumentType::Immediate, 4, 1}
				},
			}
		}
	},
	{	//	OUT Rs1, OUT_PRINT_TYPE
		"OUT",
		{TokenType::GREGISTER, TokenType::OUT_PRINT_TYPE},
		{&isa[OUT_REG_OPCODE]},
		{
			{
				{
					ArgumentSource::Token,
					{ArgumentType::Rs1, GREGISTER_SIZE, FIRST_TOKEN}
				},
				{
					ArgumentSource::Token,
					{ArgumentType::OUTDisplayType, 1, SECOND_TOKEN}
				}
			}
		}
	},
	{	//	LMA Rd, #Immediate
		"LMA",
		{TokenType::GREGISTER, TokenType::IMMEDIATE},
		{&isa[LMA_OPCODE]},
		{
			{
				{
					ArgumentSource::Token,
					{ArgumentType::Rd, GREGISTER_SIZE, FIRST_TOKEN}
				},
				{
					ArgumentSource::Token,
					{ArgumentType::Immediate, 8, SECOND_TOKEN}
				}
			}
		}
	},
	{	//	SMA Rd, #Immediate
		"SMA",
		{TokenType::GREGISTER, TokenType::IMMEDIATE},
		{&isa[SMA_OPCODE]},
		{
			{
				{
					ArgumentSource::Token,
					{ArgumentType::Rd, GREGISTER_SIZE, FIRST_TOKEN}
				},
				{
					ArgumentSource::Token,
					{ArgumentType::Immediate, 8, SECOND_TOKEN}
				}
			}
		}
	},
	{	//	LMR Rd, Rs1
		"LMR",
		{TokenType::GREGISTER, TokenType::GREGISTER},
		{&isa[LMR_OPCODE]},
		{
			{
				{
					ArgumentSource::Token,
					{ArgumentType::Rd, GREGISTER_SIZE, FIRST_TOKEN}
				},
				{
					ArgumentSource::Token,
					{ArgumentType::Rs1, GREGISTER_SIZE, SECOND_TOKEN}
				}
			}
		}
	},
	{	//	SMR Rd, Rs1
		"SMR",
		{TokenType::GREGISTER, TokenType::GREGISTER},
		{&isa[SMR_OPCODE]},
		{
			{
				{
					ArgumentSource::Token,
					{ArgumentType::Rd, GREGISTER_SIZE, FIRST_TOKEN}
				},
				{
					ArgumentSource::Token,
					{ArgumentType::Rs1, GREGISTER_SIZE, SECOND_TOKEN}
				}
			}
		}
	},
	{	//	OUT #Immediate, OUT_DISPLAY_TYPE
		"OUT",
		{TokenType::IMMEDIATE, TokenType::OUT_PRINT_TYPE},
		{&isa[OUT_IMM_OPCODE]},
		{
			{
				{
					ArgumentSource::Token,
					{ArgumentType::Immediate, 8, FIRST_TOKEN}
				},
				{
					ArgumentSource::Token,
					{ArgumentType::OUTDisplayType, 1, SECOND_TOKEN}
				}
			}
		}
	},
	{	//	OUT Character (treated as OUT immediate with A print type).
		"OUT",
		{TokenType::CHARACTER},
		{&isa[OUT_IMM_OPCODE]},
		{
			{
				{
					ArgumentSource::Token,
					{ArgumentType::Immediate, 8, FIRST_TOKEN}
				},
				{
					ArgumentSource::Constant,
					{ArgumentType::OUTDisplayType, 1, ASCII_PRINT_TYPE_BIT}
				}
			}
		}
	},
	{	//	PUSH Rs1
		"PUSH",
		{TokenType::GREGISTER},
		{&isa[PUSH_OPCODE]},
		{
			{
				{
					ArgumentSource::Token,
					{ArgumentType::Rs1, GREGISTER_SIZE, FIRST_TOKEN}
				},
			}
		}
	},
	{	//	POP Rd
		"POP",
		{TokenType::GREGISTER},
		{&isa[POP_OPCODE]},
		{
			{
				{
					ArgumentSource::Token,
					{ArgumentType::Rd, GREGISTER_SIZE, FIRST_TOKEN}
				},
			}
		}
	},
	{	//	JSR (for function pointer semantics - i.e., jump to DP)
		//	JSR takes no arguments.
		"JSR",
		{},
		{&isa[JSR_OPCODE]},
		{
			{}
		}
	},
	{	//	A: CALL :label
		//	Implemented as:
		//	1.	Set DP = target address.
		//	2.	JSR.
		//	A:		LDA %DP, L, :label[0]
		//	A + 2:	LDA %DP, H, :label[1]
		//	A + 4:	JSR
		"CALL",
		{TokenType::LABEL},
		{&isa[LDA_OPCODE], &isa[LDA_OPCODE], &isa[JSR_OPCODE]},
		{
			{	//	A:	LDA %DP, L, :label[0]
				{
					ArgumentSource::Constant,
					{ArgumentType::ARDest, AREGISTER_SIZE, DP_BITS}
				},
				{
					ArgumentSource::Constant,
					{ArgumentType::ARHorL, 1, ARHorL_LOW_BITS}
				},
				{
					ArgumentSource::TokenLabelLow,
					{ArgumentType::Immediate, 8, FIRST_TOKEN}
				}
			},
			{	//	A + 2:	LDA %DP, H, :label[1]
				{
					ArgumentSource::Constant,
					{ArgumentType::ARDest, AREGISTER_SIZE, DP_BITS}
				},
				{
					ArgumentSource::Constant,
					{ArgumentType::ARHorL, 1, ARHorL_HIGH_BITS}
				},
				{
					ArgumentSource::TokenLabelHigh,
					{ArgumentType::Immediate, 8, FIRST_TOKEN}
				}
			},
			{	//	A + 4: JSR (no arguments

			}
		}


		//	Implemented as:
		//	A: LDA %DP, H, :label[1]
		//	A + 2: LDR R0, (A + 8)[1]
		//	A + 4: PUSH R0
		//	A + 6: JSR :label[0]
		//	A + 8: ...
		//	NOTE: CALL overrides the value in R0!
		//	TODO: REMOVE THIS IMPLEMENTATION OF CALL WHEN LSP IS REMOVED. CALL
		//	WILL BECOME A WRAPPER FOR JSR WHICH IS USED TO JUMP TO THE DP AR
		//	ADDRESS.
		//	TODO: REMOVE THIS IMPLEMENTATION OF CALL WHEN THE JSR ISA
		//	INSTRUCTION BREAKS DUE TO THE PC[L] -> DB DIRECT CONNECTION BEING
		//	REMOVED (JSR WILL BE UPDATED EVENTUALLY BUT REQUIRES NEW HARDWARE
		//	SUPPORT, E.G. THE AR DATA BUS LOAD ENABLE LUT).	
		/*"CALL",
		{TokenType::LABEL},
		{&isa[LDA_OPCODE], &isa[LDR_OPCODE], &isa[PUSH_OPCODE], 
			&isa[JSR_OPCODE]},
		{
			{
				{
					ArgumentSource::Constant,
					{ArgumentType::ARDest, AREGISTER_SIZE, PC_BITS}
				},
				{
					ArgumentSource::Constant,
					{ArgumentType::ARHorL, 1, ARHorL_HIGH_BITS}
				},
				{
					ArgumentSource::TokenLabelHigh,
					{ArgumentType::Immediate, 8, FIRST_TOKEN}
				},
			},
			{
				{
					ArgumentSource::Constant,
					{ArgumentType::Rd, GREGISTER_SIZE, R0_BITS}
				},
				{
					ArgumentSource::CurrentAddressHighOffset,
					{ArgumentType::Immediate, 8, 4 * ISA_INSTRUCTION_SIZE_BYTES}
				},
			},
			{
				{
					ArgumentSource::Constant,
					{ArgumentType::Rs1, GREGISTER_SIZE, R0_BITS}
				},
			},
			{
				{
					ArgumentSource::TokenLabelLow,
					{ArgumentType::Immediate, 8, FIRST_TOKEN}
				},
			},
		}*/
	},
	{	//	RTS
		"RTS",
		{},
		{&isa[RTS_OPCODE]},
		{{}}
	},
	{	//	TST Rs1, Rs2
		//	Perform Rs1 - Rs2 and set flags accordingly.
		"TST",
		{TokenType::GREGISTER, TokenType::GREGISTER},
		{&isa[TST_REG_OPCODE]},
		{
			{
				{
					ArgumentSource::Constant,
					{ArgumentType::Func, ALU_FUNC_SIZE, SUB_FUNC_BITS}
				},
				{
					ArgumentSource::Token,
					{ArgumentType::Rs1, GREGISTER_SIZE, FIRST_TOKEN}
				},
				{
					ArgumentSource::Token,
					{ArgumentType::Rs2, GREGISTER_SIZE, SECOND_TOKEN}
				}
			}
		}	
	},
	{	//	TST Rs1, 4-bit Immediate
		//	Perform Rs1 - Immediate and set flags accordingly.
		"TST",
		{TokenType::GREGISTER, TokenType::IMMEDIATE},
		{&isa[TST_IMM_OPCODE]},
		{
			{
				{
					ArgumentSource::Constant,
					{ArgumentType::Func, ALU_FUNC_SIZE, SUB_FUNC_BITS}
				},
				{
					ArgumentSource::Token,
					{ArgumentType::Rd, GREGISTER_SIZE, FIRST_TOKEN}
				},
				{
					ArgumentSource::Token,
					{ArgumentType::Immediate, 4, SECOND_TOKEN}
				}
			}
		}
	},

	//	TODO: Add Test Reg and Test Immediate instructions
	//{	//	LSP SREGISTER, #Immediate
	//	//	TODO: Remove this when LSP is removed.
	//	"LSP",
	//	{TokenType::SREGISTER, TokenType::IMMEDIATE},
	//	{&isa[LSP_IMM_OPCODE]},
	//	{
	//		{
	//			{
	//				ArgumentSource::Token,
	//				{ArgumentType::SpecialRegister, SREGISTER_SIZE, FIRST_TOKEN}
	//			},
	//			{
	//				ArgumentSource::Token,
	//				{ArgumentType::Immediate, 8, SECOND_TOKEN}
	//			},
	//		}
	//	}
	//},
	{	//	LDW Rd, %AR, #Imm
		//	Rd = *(ARSrc + Imm)
		"LDW",
		{TokenType::GREGISTER, TokenType::AREGISTER, TokenType::IMMEDIATE},
		{&isa[LDW_OPCODE]},
		{
			{
				{
					ArgumentSource::Token,
					{ArgumentType::Rd, GREGISTER_SIZE, FIRST_TOKEN},
				},
				{
					ArgumentSource::Token,
					{ArgumentType::ARSrc, AREGISTER_SIZE, SECOND_TOKEN},		
				},
				{
					ArgumentSource::Token,
					{ArgumentType::Immediate, 8, THIRD_TOKEN}
				}
			}
		}
	},
	{	//	SDW Rs, %AR, #Imm
		//	*(ARSrc + Imm) = Rs (Rd as source)
		"SDW",
		{TokenType::GREGISTER, TokenType::AREGISTER, TokenType::IMMEDIATE},
		{&isa[SDW_OPCODE]},
		{
			{
				{
					ArgumentSource::Token,
					{ArgumentType::Rd, GREGISTER_SIZE, FIRST_TOKEN},
				},
				{
					ArgumentSource::Token,
					{ArgumentType::ARSrc, AREGISTER_SIZE, SECOND_TOKEN},
				},
				{
					ArgumentSource::Token,
					{ArgumentType::Immediate, 8, THIRD_TOKEN}
				}
			}
		}
	},
	{	//	LDA ARDest, H/L, #Imm
		//	ARDest[H/L] = Imm
		"LDA",
		{TokenType::AREGISTER, TokenType::ARHorL, TokenType::IMMEDIATE},
		{&isa[LDA_OPCODE]},
		{
			{
				{
					ArgumentSource::Token,
					{ArgumentType::ARDest, AREGISTER_SIZE, FIRST_TOKEN}
				},
				{
					ArgumentSource::Token,
					{ArgumentType::ARHorL, 1, SECOND_TOKEN}
				},
				{
					ArgumentSource::Token,
					{ArgumentType::Immediate, 8, THIRD_TOKEN}
				}
			}
		}
	},
	{	//	MGA ARDest, H/L, Rs1
		//	ARDest[H/L] = Rs1
		"MGA",
		{TokenType::AREGISTER, TokenType::ARHorL, TokenType::GREGISTER},
		{&isa[MGA_OPCODE]},
		{
			{
				{
					ArgumentSource::Token,
					{ArgumentType::ARDest, AREGISTER_SIZE, FIRST_TOKEN}
				},
				{
					ArgumentSource::Token,
					{ArgumentType::ARHorL, 1, SECOND_TOKEN}
				},
				{
					ArgumentSource::Token,
					{ArgumentType::Rs1, GREGISTER_SIZE, THIRD_TOKEN}
				}
			}
		}
	},
	{	//	MAG Rd, ARSrc, L/H
		//	Rd = ARSrc[L/H]
		"MAG",
		{TokenType::GREGISTER, TokenType::AREGISTER, TokenType::ARHorL},
		{&isa[MAG_OPCODE]},
		{
			{
				{
					ArgumentSource::Token,
					{ArgumentType::Rd, GREGISTER_SIZE, FIRST_TOKEN}
				},
				{
					ArgumentSource::Token,
					{ArgumentType::ARSrc, AREGISTER_SIZE, SECOND_TOKEN}
				},
				{
					ArgumentSource::Token,
					{ArgumentType::ARHorL, 1, THIRD_TOKEN}
				}
			}
		}
	},
	{	//	MAA ARDest, ARSrc, #Imm
		//	ARDest = ARSrc + Imm
		"MAA",
		{TokenType::AREGISTER, TokenType::AREGISTER, TokenType::IMMEDIATE},
		{&isa[MAA_OPCODE]},
		{
			{
				{
					ArgumentSource::Token,
					{ArgumentType::ARDest, AREGISTER_SIZE, FIRST_TOKEN}
				},
				{
					ArgumentSource::Token,
					{ArgumentType::ARSrc, AREGISTER_SIZE, SECOND_TOKEN}
				},
				{
					ArgumentSource::Token,
					{ArgumentType::Immediate, 8, THIRD_TOKEN}
				}
			}
		}
	}
};
