gilkeidar/ByteFrost/Assembler v2/ByteFrostAssembler/ByteFrostAssembler/source/clap.cpp

#include <iostream>
#include "clap.hpp"
#include "constants.hpp"
#include "utility.hpp"

void usageError(std::string error_string) {
	if(error_string.length() > 0)
	std::cerr << std::endl << "Error: " << error_string << std::endl;
	std::cout << std::endl <<
		"ByteFrostAssembler input_filename.asm [-b] [-v] [-o] [-h] \n" <<
		"       -b       Generate a bin file. Otherwise general a Machine Language *.mlg file\n" <<
		"       -v       Verbose\n" <<
		"       -h       This help \n\n ";

	exit(1);
}

void CLAP::run() {
	debug("=== Stage 0: CLAP.run() ===");
	
	//	Convert each command-line argument from a char * (string) w to a
	//	CLToken and add it to a vector<CLToken> tokens
	std::vector<CLToken> tokens;

	for (int i = 1; i < argc; i++) {
		std::string tokenString = argv[i];
		debug("argv[" + std::to_string(i) + "] = " + tokenString);
		CLToken token = stringToCLToken(tokenString);

		debug("TokenType: " + CLTokenTypeToString(token.type));

		//	Check for invalid token type
		if (token.type == CLTokenType::INVALID) {
			usageError("Invalid token '" + token.token_string + "' detected.");
		}

		tokens.push_back(token);
	}

	//	Iterate over list of tokens. Each token is treated as a flag, a flag
	//	argument, or as the required input argument which is the input file
	//	name.
	//	The first argument that is of type CLTokenType.FILE, ends with ".asm",
	//	and is not an argument of a previous flag token will be undestood to be
	//	the required input file name argument.
	//	When a flag token is encountered, the CLAP will check whether the flag
	//	is a CLAP-recognized flag by checking whether the token_string exists
	//	as a key of the flag name to CLFLAG hashmap in the CommandLineArguments
	//	object.
	bool flagArguments = false;
	int currentFlagArgument = -1;
	CLFlag * current_flag = nullptr;
	//	Create a CommandLineArguments object
	//CommandLineArguments* arguments = new CommandLineArguments();
	CommandLineArguments arguments;

	for (CLToken token : tokens) {
		//	Check whether token is the required input file name argument
		if (!flagArguments && token.type == CLTokenType::FILE_NAME
			&& stringEndsWith(token.token_string, ASSEMBLY_FILE_ENDING)) {
			arguments.input_file_name = token.token_string;
		}
		//	Check whether token is a flag
		else if (!flagArguments && token.type == CLTokenType::FLAG) {
			//	Check that flag is recognized by the assembler
			std::string flag_name = getFlagName(token.token_string);

			if ((arguments.flags.find(flag_name)) == arguments.flags.end()) {
				//	Flag is not recognized by the assembler
				usageError("'" + flag_name + "' is not a recognized command-line flag.");
			}

			//	Flag is recognized by the assembler; set current_flag field
			current_flag = &(arguments.flags[flag_name]);
			//	Set flag
			current_flag->is_set = true;

			//	If there are any expected arguments, set arguments field and
			//	the current flag argument index
			if (current_flag->expected_pattern.size() > 0) {
				flagArguments = true;
				currentFlagArgument = 0;
			}
		}
		else if (flagArguments) {
			//	Check that the current token's type matches the expected flag
			//	argument type
			if (token.type != current_flag->expected_pattern[currentFlagArgument]) {
				usageError("Argument " + std::to_string(currentFlagArgument)
					+ " of flag -" + current_flag->flag_name + " must be a "
					+ CLTokenTypeToString(current_flag->expected_pattern[currentFlagArgument]) 
					+ ".");
			}
			else {
				//	Set this flag's value in the CommandLineArguments object.
				current_flag->values.push_back(token);
				currentFlagArgument++;
				if (currentFlagArgument == current_flag->expected_pattern.size()) {
					//	Went through this flag's last argument
					flagArguments = false;
					current_flag = nullptr;
				}
			}
		}
		else {
			//	Invalid argument
			usageError("Invalid argument detected: '" + token.token_string + "'.");
		}
	}

	//	Check that the last flag, if any, received all of its expected
	//	arguments
	if (flagArguments && currentFlagArgument < current_flag->expected_pattern.size()) {
		usageError("Expected "
			+ std::to_string(current_flag->expected_pattern.size())
			+ " arguments for -" + current_flag->flag_name
			+ " flag, but received " + std::to_string(currentFlagArgument) 
			+ " arguments.");
	}

	//	Check that the required input file name was set
	if (arguments.input_file_name == UNSET_FILE_NAME) {
		usageError("Must pass a '.asm' input file.");
	}

	//	Now that the CommandLineArguments object has been created, update the
	//	Assembler's Config instance fields appropriately.
	arguments.updateConfig(config);
}

CLToken stringToCLToken(std::string w) {
	//	Given a string w, match it with a CLTokenType, and return a CLToken
	//	containing w and the matched CLTokenType.

	CLTokenType type;
	
	//	CLTokenTypes to match with w:
	//	1.	FLAG
	//		w is mapped to CLTokenType.FLAG iff:
	//			1.	w.length() >= 2
	//			2.	w[0] = '-'
	//			3.	w[1:end] is in TEXT
	//	2.	NUMBER
	//		w is mapped to CLTokenType.NUMBER iff w is in NUMBER.
	//	3.	FILE_NAME
	//		w is mapped to CLTokenType.FILE_NAME iff w is in FILE
	//	4.	TEXT
	//		w is mapped to CLTokenType.TEXT iff w is in TEXT
	//	5.	INVALID (matched with s if s doesn't match any from 1 - 4)

	//	Map w to a CLTokenType
	if (w.length() >= 2 && w[0] == '-' && isTEXTString(w.substr(1))) {
		type = CLTokenType::FLAG;
	}
	else if (isNUMBERString(w)) {
		type = CLTokenType::NUMBER;
	}
	else if (isFILEString(w)) {
		type = CLTokenType::FILE_NAME;
	}
	else if (isTEXTString(w)) {
		type = CLTokenType::TEXT;
	}
	else {
		type = CLTokenType::INVALID;
	}

	return {type, w};
}

std::string CLTokenTypeToString(CLTokenType type) {
	switch (type) {
		case CLTokenType::FLAG:
			return "FLAG";
		case CLTokenType::NUMBER:
			return "NUMBER";
		case CLTokenType::FILE_NAME:
			return "FILE_NAME";
		case CLTokenType::TEXT:
			return "TEXT";
		case CLTokenType::INVALID:
			return "INVALID";
		default:
			return "UNKNOWN TYPE";
	}
}

CommandLineArguments::CommandLineArguments() {
	//	Initialize input_file_name
	this->input_file_name = UNSET_FILE_NAME;

	//	Initialize flags hashmap

	//	Add Binary Flag "-b"
	CLFlag binary_flag = { BINARY_FLAG_NAME, {}, {}, false };
	this->flags.insert({ BINARY_FLAG_NAME, binary_flag });

	//	Add Verbose Flag "-v"
	CLFlag debug_printouts_flag = { VERBOSE_FLAG_NAME, {}, {}, false };
	this->flags.insert({ VERBOSE_FLAG_NAME, debug_printouts_flag });
	
	//	Add Help Flag "-h"
	CLFlag help_flag = { HELP_FLAG_NAME, {}, {}, false };
	this->flags.insert({ HELP_FLAG_NAME, help_flag });


	//	Add Output File Name Flag "-o"
	CLFlag output_file_name_flag = { OUTPUT_FILE_FLAG_NAME, {CLTokenType::FILE_NAME}, {}, false };
	this->flags.insert({ OUTPUT_FILE_FLAG_NAME, output_file_name_flag });
}

void CommandLineArguments::updateConfig(Config& config) {
	//	Set all command-line settable properties in config.
	config.input_file_name = this->input_file_name;

	for (auto& [flagName, flag] : this->flags) {
		if (flag.is_set) {
			if (flagName.compare(BINARY_FLAG_NAME) == 0) {
				//	Binary flag is set.
				config.generateBinaryFile = true;
			}
			else if (flagName.compare(OUTPUT_FILE_FLAG_NAME) == 0) {
				//	Output file name flag is set.
				config.output_file_name = flag.values[0].token_string;
			}
			else if (flagName.compare(VERBOSE_FLAG_NAME) == 0) {
				//	Verbose flag is set.
				debug_printouts = true;
			}
			else if (flagName.compare(HELP_FLAG_NAME) == 0) {
				usageError("");
						 
			}
		}
	}
}
