gilkeidar/ByteFrost/Disk/FileSystem/BFSv1_VS/error.h

/*  Error Codes */
#define SUCCESS             0
#define UNKNOWN_FLAG        1
#define MISSING_PARAM       2
#define INCORRECT_USAGE     3
#define UNEXPECTED_ERROR    4
#define DIRECTORY_FAIL      5
#define MISSING_FILES_DIR   6
#define MISSING_BOOT_FILE   7
#define TOO_MANY_FILES      8
#define LONG_FILE_NAME      9
#define FILE_FAIL           10
#define FILE_TOO_BIG        11
