gilkeidar/ByteFrost/(commit log)

2022-04-10 Initial commit
    Created file I/O code for assembler (creates empty output file, doesn't convert any assembly yet)
2022-06-21 Minor changes to assembler + new instructions (INC / DEC)
2022-06-21 Re-organized Repository
    New folders: Assembler, Programs, and Documenation
2022-06-21 Fixed READMEs and updated assembler file names
    Fixed / updated READMEs and updated assembler to only accept .asm files and output .mlg or .bin files
2022-06-22 Added relative branches to assembler
    Added relative branching to assembler with a new instruction parameter type, "branch_amt"
2022-06-23 Add the Arduino Display Driver
2022-06-25 Eight Queens first draft (not tested)
    First draft of eight queens (one solution) in ByteFrost assembly (not tested)
2022-06-25 Assembler update and bug fix
    Updated assembler to print instruction line in mlg file (absolute branching goes awry if there are lines without instructions - assembler makes program counter go to those lines, even though they do not reflect the correct instruction address) + fix for eight queens code
2022-06-25 print statement in eight queens
2022-06-25 Add debug printout
2022-06-26 Cange line numbers to hex to match the line number on the board
2022-07-04 Update Display.ino
    debug number of interrupts (counting to make sure we're not losing interrupts)
2022-07-05 HW INT for Display Driver
    Add Register to hold display output,
    Add note to explain R on pin 5 of 555
    Update the PPT
2022-07-18 Fixed Assembler bug
    Fixed assembler bug that required input assembly file to have a newline at the end of the file to compile the last instruction
2022-07-19 Updated recursive fibonacci
    Removed printouts of current input parameter n and replaced it with a static counter of the number of function calls
2022-07-30 Display fix, powerpoint update, and BIST update
    [Display.ino]
2022-08-26 Binary Search Tree Program first version + Syntax Highlighting for Assembly
2022-08-28 Label update to assembler + new binary search tree code
2022-08-28 Small fix to assembler
2022-08-29 Updates to assembler and BST implementation
2022-08-29 Updated assembler
    Removed debug printouts and fixed a small bug
2022-08-29 Syntax Highlighting revision for ByteFrost Assembly
2022-09-06 Added simple demo program (5 NOPs and BRK)
    [assemblerv2.obj]
2024-02-04 Enhance the slide of the SD card to replace 374 with 574 which has its pins better orgenized. The disk.ino code is cleened and muved to use the PORT bit directly accross the board.
2024-03-05 Small fixes to Powerpoint documentation
2024-03-05 Applied small fixes to powerpoint documentation
2024-03-05 Update CPU.pptx
    Fix headers, Micro instruction tables, ALU slides on ADD/SUB/ADC/SBC and slide numbering
2024-03-11 Small fixes to CPU documentation powerpoint
2024-08-09 Updated assembler + added new instruction
    Added new LSP imm (Load Special Register) instruction to load high byte of PC, Data Pointer, or Stack Pointer (part of expansion into 16 bit addressing)
    [assemblerv2.obj]
2024-08-31 Start enhancing BIST to 16 bit
    Need to add LSP command to the editor and to the assembler
2024-09-02 LSP and migration to AMAP
    Add assembler support to Load Special Pointer LSP. Fix 8Queens to use LSP to enable use the RAM according to the AMAP. Convert it to labels.,
    [assemblerv2.obj]
2024-09-03 Docs on MKR Zero
    Docs on MKR Zero - using VIN as power supply to MKR Zero
2024-09-08 Added RAM test program and more ALU imm instructions
    [assemblerv2.obj]
2024-09-17 Initial parser (stage 1) implementation work
2024-09-17 Added error for invalid token encountered in input .asm file parsing
    [parser.cpp]
2024-09-20 More general implementation of AssemblyInstruction's generateCode() method
2024-09-20 Encoded entire current ISA as ISAInstructions, added some constants for QOL and code readability and fixed documentation error in OUT Immediate slide (set comment to Out #Imm, A/I instead of OUT Rs)
    [constants.hpp, isa.hpp]
2024-09-20 Added partial assembly as structs
2024-09-23 Added argument range checking for ISAInstructions and AssemblyInstructions (if a given immediate value doesn't fit in an ISAInstruction's argument (as determined by the ExpectedArgument's size and Ar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
    [assembly_instructions.cpp, assembly_instructions.hpp, constants.hpp, isa.cpp, isa.hpp, parser.cpp, parser.hpp, utility.cpp]
2024-09-24 Added preprocessor types and parsing, as well as shared_types.hpp to avoid shared type linking shenanigans / circular references (e.g., for TokenType and Tokens)
    [assembler.cpp, assembler.hpp, assembly_instructions.hpp, constants.hpp, file_generation.cpp, file_generation.hpp, parser.cpp, parser.hpp]
2024-09-25 Initial Label Handler implementation and adding more assembly instructions
2024-09-25 Added OUT_PRINT_TYPE TokenType and more assembly instructions (up to OUT Rs1, A/I)
2024-09-25 Added more instructions, CALL instruction, specific ArgumentSource for use by CALL, and hopefully a non-buggy implementation of logically shift right
    [assembly_instructions.cpp, assembly_instructions.hpp, constants.hpp, isa.hpp, label_handler.cpp, utility.cpp, utility.hpp]
2024-09-30 In-progress adding documentation, cleaning code, adding comments; added optimization that lines vector isn't copied when returned from the parser, rather the parser fills an existing Line * vector in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
2024-11-21 New MMIO Device (32-bit cycle counter)
    Updated documentation + added example program
2025-01-14 Updated Disk Driver Arduino
    First implementation of being able to write a page from the ByteFrost RAM to a sector in the disk.
2025-02-26 Cleaning assembler cruft
2025-05-15 Replaced `CommandLineArguments` with more general `Config`
    Also added a .start START_ADDRESS preprocessor directive to allow loading of a program into an arbitrary address in memory
    [assembler.cpp, assembler.hpp, clap.cpp, clap.hpp, constants.hpp, file_generation.cpp, file_generation.hpp, label_handler.cpp]
2025-05-28 New Addressing Modes design documentation + Assembler Bug Fix
    Assembler bug fix regarding start address offset (CALL assembly instruction modified to push correct return address that has been offset by start address preprocessor directive)
    [assembly_instructions.cpp, assembly_instructions.hpp, clap.cpp, file_generation.cpp]
2025-05-31 Fixed small bug in Arduino disk controller regarding writing to disk + RNG program
    With bug fix, writing to disk appears to work correctly + added RNG program using new TRNG device.
    [disk_v2.ino]
2025-11-27 Added LDW and ARSrc support to assembler
    Added LDW Assembly instruction + ISA instruction at opcode 0x16 instead of 0x14 still not removing LSP yet (which is at opcode 0x14). Note that the CALL instruction may break when the JSR instruction breaks due to the PC[L] -> DB dedicated connection being removed (JSR will be fixed but will require new hardware support such as the AR Data Bus Load Enable LUT).
    [assembly_instructions.cpp, assembly_instructions.hpp, constants.hpp, isa.cpp, isa.hpp, parser.cpp, shared_types.hpp]
2025-11-29 Added SDW instruction support
    SDW assembler support + microcode + test program (hopefully bug-free but includes instruction counting which may be incorrect)
    [assembly_instructions.hpp, constants.hpp, isa.cpp, isa.hpp, microcode.ino]
2025-11-30 Removed LSP, added LDA
    Updated LDW_SDW test to use LDA instruction instead of LSP (note that currently LDA can't load to SP so LDA %SP, H, #0x32 won't do anything, but this is a transient state of the HW and will soon be fixed).
    [assembly_instructions.cpp, assembly_instructions.hpp, constants.hpp, isa.hpp, microcode.ino, parser.cpp]
2025-12-18 Fix a bug in the assembler
    Assembler did not recognize filename starting with ".\" which windows auto-complete adds to filenames
    [utility.cpp]
2025-12-18 replaced another find_first_of with find_last_of
    [utility.cpp]
2025-12-26 Updated PUSH and POP to implement full descending stack
    Updated PUSH and POP microcode to implement full descending stack.
    Including a fix for ldw_sdw_test.asm with the new full-descending stack semantics (likely many programs will need to be fixed to accommodate the change).
    [microcode.ino]
2025-12-26 Update microcode.ino
    Fix attempt - weird bug when fetching commit on other computer
    [microcode.ino]
2025-12-26 Added support for the MAG instruction
    microcode + Assembly support
2025-12-26 Added support for the MAA instruction
    microcode + assembly support
2025-12-26 Added support for JSR instruction
    microcode + Assembly support (and updated CALL assembly instruction implementation to use LDA and new JSR)
2025-12-28 BIST V3 advance
    Added tests up to ALU SUB/C
    Fix slide on Address to Data Byte selector
    [BISTv3.asm, assembly_instructions.hpp]
2026-01-02 Finished converting 8 Queens to the new address registers
    Replaced LMR/SMR/LMA/SMA/LSP deprecated commands with new ones
    Added counter to report total number of clocks
    Added a flow diagram to the code
    [BISTv3.asm]
2026-01-02 ByteFrost Assembly syntax highlighting (Notepad++)
2026-01-09 Changed PL LD Branch to "Active High' Replaced the NAND generating it with an AND
    The NAND was of type 'LS' and I suspected it is generating glitch as the voltage is too low for LS. for type 'HC' I had only AND and not NAND so i took the opportunity to change the level in the LUT and PPT.
2026-01-09 Improve the printout of the SD Driver
2026-01-11 Extend Bistv3 to cover SP in MAG/MGA
    (In addition, the Disk INO contains printout on boot and printout the command (read/write)
2026-01-13 Add comment on how to program Display
    1. IDE Setup
    a. Board "Arduino NANO"
    b. CPU "ATmega328p (old bootloader)"
    2. To program the Arduino - the RESET control signal (black) need to be disconnected!!.
    [Display.ino]
2026-01-13 Added a plan to free up a tx pin for tty display
2026-01-19 Update mmio.asm
    Refresh commands. Cover SD Card, RNG, Counter, and just touch the other MMIO slots
2026-01-22 Full migration to the new stack pointer
    reverse SP L LUT polarity , it is now active high (both L and H are inversed before the chip but they are consider active high to use the local AND with the negative clock.
    BIST is enhanced to test SP and report more failures
    [BISTv3.asm]
2026-02-09 invert data clock on KBD signal out
    [Display.ino]
2026-02-20 Updated shell + fixed parser bug with simple trim
    [parser.cpp, utility.cpp, utility.hpp]
2026-04-12 Fix bug in RTS
    Fix bug in RTS , avoid changing SP while using it. (made the command 6 clocks instead of 4)
    First JSR-RTS works in SHELL
    The Shell first command "list memory" works as a stub. The next step is to build a lib function ATOI to convert the user input address to hexadecimal value.
    [microcode.ino]
2026-04-14 Multiple changes toward JSR/RTS
    1. Changes to JSR/RTS to avoid SP count while using it
    2. Update ppt accordingly
    3. Main issue with JSR - does not push the correct return address
    4. Extend BIST to cover LDW/SDW as they are may have issue
    [BISTv3.asm, microcode.ino]
2026-04-15 Improve BIST LDW to address HW bug it did not detect
    [BISTv3.asm]
2026-04-20 build_assembpler command line compile and copy the assembler
2026-05-21 Boot ROM kick off
    BIST is integrated.
    Old SMR replaced with SDW
    [rom_boot.asm]
2026-05-22 Start study PCB production
    Using KiCAD: Did the Register File
    [ByteFrost.kicad_pcb, ByteFrost.kicad_sch]
2026-05-23 BootROM run BIST and loads SD Card
    Now need to fix the code in the SD to run Shell
    [ByteFrost.kicad_sch, clock.kicad_sch, top_level.kicad_sch]
2026-05-23 Update disk_v2.ino
    Fix debug printout
    [disk_v2.ino]
2026-05-29 Finish KiCAD Clock and Reset
    [ByteFrost.kicad_pcb, ByteFrost.kicad_sch, clock.kicad_sch, reset.kicad_sch]
2026-06-08 Created SD_Pack for widows (in addition to linux) under Disk/FileSystem/BFS_VS
    [clock.kicad_sch, reset.kicad_sch]
2026-06-13 Add backplane analysis
    the drawio file is used to identify the wires that are not on the backplane yet.
    The decisions are
    1. which wires will get a spot on the backplane
    2. Can we use the 6 local wires feature of the backplane
    3. Should we double the backplane and avoid all these constrains
2026-07-23 Started the documentation of ByteFrost v3.0
    This deck should replace the hand-made schematics of ByteFrost v2.0 with EasyEDA schematics. This time it supposed to be 100% accurate.
